verylowfreq/cyd_kusabi/HARDWARE_DESIGN.md

# サイバーデックのハードウェア仕様の検討

最終更新: 2026-10-31

**状態**: 検証済み。**指摘 12 件はすべて決着した**（下の「決定事項」）。
**2026-08-28 にブレッドボード試作機で初火入れ**（下の「初火入れの結果」）。
残る未決は 1 つ:

- **F-11 の付随信号**（カード検出・過電流・電源スイッチ・状態 LED）の割り付け
  — 空きピンは 2 本しかないので、I²C エキスパンダを使う想定

この文書の前半は基板を起こす前の仕様の検討。**実際に起こした基板 v1 と違うところは
下の「基板 v1（hardware/cdk_motherboard）」にまとめた。**

---

## 基板 v1（hardware/cdk_motherboard）

KiCad データは `hardware/cdk_motherboard/`。仕様の検討から変わったところ:

| 項目 | 仕様の検討 | 基板 v1 |
|---|---|---|
| MCU | ESP32-S3-WROOM-1-N16R8 | Freenove ESP32-S3 開発ボード（U1）を載せる |
| 電源 | TPS631000 で 5V / 3.3V | 基板上に電源回路は無い。CN7（GND / 5V / VBAT_RAW / VBAT_EN）に外付けの電源を挿す。SW1 が VBAT_EN を GND に落とす。3.3V は開発ボードの 3V3 |
| RS-232C | SP3232EEN | **XD3232**（U3、DIP-16。3.3V 対応、ドライバ 2・レシーバ 2）。+3V3 給電。回路図のシンボル名は ADM232A のまま（下の「既知の誤り」） |
| USB VBUS | GPIO4 で制御 | GPIO4 は未接続。USB-A（CN1）の VBUS は +5V 直結。ファームは G4 に H を出すだけで害は無い |
| 外部端子 | Grove | Grove（CN2: GPIO1/2、CN3: I2C、CN4: UART2）。フットプリントは JST PH のまま（下の「既知の誤り」） |
| デバッグ | — | CN6（3V3 / RX / TX / EN / BOOT / GND）は開発ボードの UART0。CN8（RX / TX / GND）は G15/G16 の UART1（制御チャネル）。**回路図の信号名 `UART_1_*` は UART0、`UART_DEBUG_*` は UART1** |

電池電圧の分圧は R6 / R7 = 100k / 100k で GPIO5 へ（`CDK_BOARD_BATT_DIV 2` と一致）。

### 基板 v1 の既知の誤り

#### microSD の SPI の信号名

**microSD の SPI 4 本は、回路図・基板データの信号名が実物と違う。**
液晶モジュールの SD のパッド 15〜18 の並びが、フットプリントでは実物と逆順になっている。
ファームウェアのピン指定（`cdk_board.h` と下のピン割り当て表）が正しい。

| GPIO | 回路図・基板データの信号名 | 実物（ファームの指定） |
|---|---|---|
| 39 | SD_MISO | **MOSI** |
| 40 | SD_MOSI | **MISO** |
| 41 | SD_CS | **SCLK** |
| 42 | SD_SCLK | **CS** |

- 基板はそのまま使える。ファームのピン指定を実物に合わせてある（2026-09-12）。
- 信号名が入れ替わっているので、プルアップ抵抗も意図とずれている。
  R1（意図は MISO）は実物の MOSI、R2（意図は SCLK）は CS、R3（意図は CS）は SCLK に付いている。
  **実物の MISO（GPIO40）には外付けのプルアップが無い。** いまのところ読み書きは動いている。
- 次に基板を起こすときは、液晶モジュールのフットプリントの SD パッドの並びを直すこと。
- ctest の `board_pins` はこの文書と `cdk_board.h` を比べるだけで、KiCad データは見ない。

#### 部品の名前が実物と違う（配線は正しい）

- **RS-232C の IC（U3）**: 回路図のシンボル名は `ADM232A` だが、実装しているのは 3.3V 対応の
  **XD3232**。ADM232A は 5V の部品なので、シンボル名どおりに部品を買うと +3V3 給電では定格外になる。
- **外部端子（CN2〜CN4）**: フットプリントは JST PH（`JST_PH_B4B-PH-K`）だが、実装は **Grove**。

---

## MCU

ESP32-S3-WROOM-1-N16R8

- N16 = 16MB flash / **R8 = 8MB octal PSRAM**
- octal PSRAM は GPIO33〜37 を SPIIO4〜7 と SPIDQS に使う。
  GPIO33/34 はモジュールのピンに出ていないので、実際に潰れるのは 35〜37。
- ファーム側は `CONFIG_SPIRAM_MODE_OCT=y`。`sdkconfig.defaults.v1` に入っている（→ F-12）
- **ピン番号は `cyberdeck_firmware/components_port/port_board/include/cdk_board.h`
  にも同じものが入っている。**片方だけ直すと ctest の `board_pins` が落ちる

## ピン割り当て

チップにあるのは GPIO0〜21 と GPIO26〜48 の 45 本。GPIO22〜25 は存在せず、
GPIO26〜32 は内蔵 flash 用でモジュールのピンに出ていない。
**入力専用のピンは無い**（どのピンも出力にできる）。

| GPIO | 用途 | 備考 |
|---|---|---|
| 0 | BOOTボタン専用 | ストラッピング |
| 1 | ADC外部入力0 | ADC1_CH0 |
| 2 | ADC外部入力1 | ADC1_CH1 |
| 3 | 原則未使用、テストパッド | ストラッピング（JTAG 選択）/ ADC1_CH2 |
| 4 | USB Host VBUS Enable | ADC1_CH3。**基板 v1 では未接続**（VBUS は 5V 直結） |
| 5 | **電池電圧センス** | ADC1_CH4 |
| 6 | 空き | ADC1_CH5 / RTC |
| 7 | 空き | ADC1_CH6 / RTC |
| 8 | LCD Backlight PWM | ADC1_CH7 |
| 9 | LCD D/C | |
| 10 | LCD CS | **SPI2 IO_MUX**（FSPICS0） |
| 11 | LCD MOSI | **SPI2 IO_MUX**（FSPID） |
| 12 | LCD SCLK | **SPI2 IO_MUX**（FSPICLK） |
| 13 | LCD MISO | **SPI2 IO_MUX**（FSPIQ）— ファームは未使用 |
| 14 | LCD RESET | |
| 15 | UART1 RX | **デバッグ: 制御チャネル**（`cdk_proto`） |
| 16 | UART1 TX | 同上 |
| 17 | I²C SDA | 信号は 3.3V レベル前提 |
| 18 | I²C SCL | 同上 |
| 19 | USB Host D− | 内蔵 USB PHY |
| 20 | USB Host D+ | 同上 |
| 21 | UART2 RTS | RTC |
| 35–37 | 使用禁止 | octal PSRAM が使用 |
| 38 | UART2 CTS | |
| 39 | SD MOSI | 外部 JTAG と同じピン（JTAG は使わない） |
| 40 | SD MISO | 同上 |
| 41 | SD SCLK | 同上 |
| 42 | SD CS | 同上 |
| 43 | UART0 TX | **デバッグ: ログ + 書き込み**。モジュール既定 TXD0 |
| 44 | UART0 RX | 同上。モジュール既定 RXD0 |
| 45 | 空き | ストラッピング |
| 46 | 空き | ストラッピング |
| 47 | UART2 RX | D-sub / Grove（排他） |
| 48 | UART2 TX | 同上 |

### デバッグ経路

USB-Serial-JTAG が使えない（GPIO19/20 を USB ホストに使うため）ので、
DESIGN.md §3.4 の 2 チャネル構成を UART で組み直す。

| チャネル | UART | ピン | 用途 |
|---|---|---|---|
| CTRL | UART1 | 15 / 16 | `cdk_proto` のバイナリフレーム専用 |
| LOG | UART0 | 43 / 44 | `ESP_LOG` のテキスト + ファーム書き込み |

制御とログが別の物理ポートのまま残るので、DESIGN.md §3.4 が 1 チャネル縮退を
避けた理由（パニック時のバックトレースやブートローダの出力がフレームに
割り込む）はそのまま満たせる。

## 電源

- バッテリー: NiMH x2（公称 2.4V、放電末期 約 2.0V）。**本体では充電しない**
- 5V レーン: TPS631000
- 3.3V レーン: TPS631000

TPS631000 は昇降圧。出力は最大 5.3V。カタログの出力電流は入力電圧の条件つき
（`VIN ≥ 2.7V` で 1.5A、`VIN ≥ 3V` で 2A、ピークスイッチ電流 3A）で、
2 セル NiMH は常に 2.7V を下回る。**5V / 3.3V ともにピークでも 1.5A に
達しない前提**で設計する（→ F-6）。

## 外部端子

| 端子 | 内容 | 前提 |
|---|---|---|
| Grove GPIO | ADC対応GPIO x2 (GPIO1/2), 5V, GND | **信号線は 3.3V レベル** |
| Grove I2C | I2C (GPIO17/18), 5V, GND | **信号線は 3.3V レベル**（5V プルアップのモジュールは不可） |
| Grove UART | UART2 | **D-sub と排他。同時に挿さない** |
| D-sub 9pin UART | UART2 + CTS, RTS | IC: SP3232EEN(UMW)。ドライバ2/レシーバ2 でちょうど合う |

電源ピンは 5V を出すが、**信号線は 3.3V** で扱う。ESP32-S3 の GPIO は
5V トレラントではなく、絶対最大定格は電源電圧 +0.3V。5V で信号を出す
モジュールは繋がない（→ F-8）。

Grove UART と D-sub は同じ UART2 の RX（GPIO47）に繋がるため、両方に機器を
挿すと RX 側で競合する。**シルクに明記すること**（→ F-3）。

---

# 検証結果と決定 (2026-08-28)

ESP-IDF v5.5.5 の一次情報と TI の製品情報に突き合わせた。
**ピンの並びそのものは正確**で、モジュールで使えないピンも正しく除いてある。
指摘はピンの選び方ではなく、**その結果として何が使えなくなるか**に集中していた。

## 決定事項

| # | 指摘 | 決定 |
|---|---|---|
| F-1 | USB ホストが内蔵 USB PHY を占有し、USB-Serial-JTAG が使えなくなる | **UART0 と UART1 をデバッグに使う。**CTRL=UART1(15/16)、LOG+書き込み=UART0(43/44) |
| F-2 | 外部 JTAG (39–42) が SD に、内蔵 USB-JTAG が F-1 で塞がる | **JTAG は使わない。**両方とも捨てる |
| F-3 | Grove UART と D-sub が同じ UART2 で RX が競合 | **同時使用しないよう運用で回避。**シルクとドキュメントに明記 |
| F-4 | EN を操作する手段が無い | **EN ボタンを付ける** |
| F-5 | 電池電圧を測るピンが無い | **GPIO5（ADC1_CH4）で測る** |
| F-6 | TPS631000 の 1.5A は VIN≥2.7V の条件つき | **5V / 3.3V ともピークでも 1.5A に達しない前提**。問題なし |
| F-7 | NiMH の充電回路が未定義 | **本体では充電しない。**電池を抜いて外部充電器で充電する |
| F-8 | Grove の 5V と 3.3V GPIO | **信号線は 3.3V レベル前提。**5V 信号のモジュールは繋がない |
| F-9 | 型番の誤記 `TSP631000` | 修正済（`TPS631000`） |
| F-10 | LCD MISO はファームが使わない | 承知のうえで配線は残す。条件つき空きピンとして扱う |
| F-11 | 付随信号（カード検出・過電流・電源スイッチ・状態 LED）が未割り当て | **あとで決める。**空きピン一覧は下記 |
| F-12 | ファームの PSRAM 設定が試作機と最終ハードで違う | **実装済み。**`cdk.py build --board v1` で切り替わる（DESIGN.md §13 M7） |

## F-11 空きピン一覧

決定を反映したあと、モジュールに出ている 33 本の使えるピンのうち
**28 本が埋まっていて、残りは 5 本**。

### 完全に自由に使える — 2 本

| GPIO | ADC | RTC | 備考 |
|---|---|---|---|
| **6** | ADC1_CH5 | ○ | 制約なし |
| **7** | ADC1_CH6 | ○ | 制約なし |

どちらも **ADC1** なのでアナログ入力に使える（ADC2 は WiFi 使用中に読めないため
実質使えない）。どちらも **RTC GPIO** なので**ディープスリープからの復帰に使える**。

> **ウェイクに使うピンはこの 2 本のどちらかしかない。**
> RTC GPIO は GPIO0〜21 に限られ、そのうち空いているのは 6 と 7 だけ。
> 電源スイッチやウェイクボタンを付けるなら、**先にここを予約すること。**
> I²C エキスパンダの先に付けた信号ではチップを起こせない。

### 条件つきで使える — 5 本

| GPIO | 条件 | ADC / RTC |
|---|---|---|
| **3** | ストラッピング（JTAG 選択）。ただし **`STRAP_JTAG_SEL` eFuse を焼かない限り効かない**。JTAG を使わないので焼く理由がない。起動時の内部プルが無いので外部で決めること | ADC1_CH2 / RTC |
| **13** | LCD MISO。ファームは画面を読み戻さないので未接続にできる（DESIGN.md §12）。将来リードバック対応パネルに替えるなら残す | ADC2 / RTC |
| **21** | UART2 RTS。D-sub のフロー制御を使わないなら空く | — / RTC |
| **38** | UART2 CTS。同上 | — / — |
| **45** | ストラッピング（VDD_SPI 電圧選択）。**起動時に LOW でなければならない**。起動時に HIGH へ引かれる接続は不可 | — / — |
| **46** | ストラッピング（起動モード）。**起動時に LOW でなければならない**。同上 | — / — |

GPIO45 / 46 は「起動時のレベルが決まっていて、起動後に出力として使う」用途向き。
状態 LED のように起動時に不定でも困らないものなら載る。逆に、外部から
引っ張られる可能性がある入力には使わないこと。

> **未確認**: GPIO45 / 46 の内部プルダウンが reset 時に有効かどうかまでは
> 確認していない。何かを繋ぐなら**外部プルダウンを入れる**のが安全。

### 付随信号の割り付け案

F-11 で挙がっていたのは 5 つ。空きは 2 本なので、そのままでは足りない。

| 信号 | 案 |
|---|---|
| 電源スイッチ / ウェイク | **GPIO6 か 7**（RTC が要るので他に選択肢が無い） |
| SD カード検出 | I²C エキスパンダ、または**省略**（マウントを試して失敗で判定できる） |
| USB 過電流 (FAULT) | I²C エキスパンダ。または**ロードスイッチの FAULT を自分の EN に戻して**ハードだけで遮断し、MCU は関与しない |
| USB VBUS 検出 | I²C エキスパンダ |
| 状態 LED | I²C エキスパンダ、または GPIO45 / 46 |

**I²C エキスパンダ（PCA9555 / PCF8574 など）を 1 個載せるのが素直。**
I²C は GPIO17/18 にすでに出ているので MCU のピンは 1 本も増えない。
遅い信号（LED・検出・スイッチの状態）はこれで足りる。
試作機の CoreS3 も同じことを AW9523 でやっているので、扱いの勘所は分かっている。

**エキスパンダで代替できないのはウェイクだけ**。そこだけ GPIO6/7 を使う。

## 確認できた点

- **GPIO35–37 使用禁止。** R8 は octal PSRAM なので GPIO33–37 が
  SPIIO4–7 / SPIDQS に使われる。GPIO33/34 はモジュールのピンに出ていないので、
  表に無いのが正しい。
- **ストラッピングピンの扱い。** ESP32-S3 のストラッピングは
  GPIO0 / 3 / 45 / 46 のちょうど 4 本で、指定と一致する。
- **USB D− = GPIO19 / D+ = GPIO20。** 内蔵 PHY の割り当てとして正しい。
- **ADC を GPIO1/2 に取った判断。** ADC1 は GPIO1–10、ADC2 は GPIO11–20。
  **ADC2 は WiFi 使用中に読めない**ので、外部入力を ADC1 に置いたのは正しい。
  電池センスの GPIO5 も ADC1。
- **UART0 が GPIO43/44。** WROOM-1 の既定 TXD0/RXD0 と一致していて、
  書き込み時に迷わない。
- **LCD が SPI2 の IO_MUX ピンに載っている。** CS=10 / MOSI=11 / SCLK=12 /
  MISO=13 は FSPI の IO_MUX そのもの。GPIO マトリクス経由を避けられるので
  SPI を 80MHz まで上げられる（いまは 40MHz で動かしている）。480x320 の全画面が 300KB なのでここが効く。
- **LCD と SD が別の SPI ホスト。** 試作機 CoreS3 の「LCD と SD が SPI3 を
  共有し、さらに DC と MISO が同じ G35」という問題
  （`port_spibus` でピンの向きを切り替えて凌いでいる）が、この基板では
  最初から存在しない。DESIGN.md §12 の 7 番が構造的に消える。
- **SP3232 の選定。** ドライバ 2・レシーバ 2 で TX / RX / RTS / CTS に
  ちょうど合う。過不足がない。
- **TPS631000 で 5V が作れる。** 出力は最大 5.3V なので範囲内。
- **入力専用ピンが無い。** ESP32-S3 はどの GPIO も出力にできるので、
  空きピンの用途を選ぶときに向きの制約を考えなくてよい。

## 液晶 — ILI9488 (決定)

**SPI 接続では 16bit を受け付けない。** 18bit (RGB666) の 3 バイトしか
通らないので、キャンバスの RGB565 を転送の直前に広げる。

| | |
|---|---|
| 転送量 | 480x320 の全画面で **450KB**（RGB565 なら 300KB。1.5 倍） |
| ドライバ | `atanisoft/esp_lcd_ili9488` 1.1.x（変換とレジスタ列） |
| 素の向き | 320x480（縦）。横長で使うので `swap_xy` + `mirror` |

**帯単位で送るので全画面 450KB を一度に持つ必要はない。** 16 行ずつなら
480x16x3 = 23KB の変換バッファ 1 つで足り、起動時に 1 回だけ確保する
（DESIGN.md §14）。

> **ドライバの `draw_bitmap` に境界検査が無い。** `buffer_size`（画素数）を
> 超える画素数を渡すとヒープを壊す。帯の行数と必ず一致させること。
> 1.0.x は転送のたびに malloc し、失敗すると**無限ループ**するので使わない。

## まだ決まっていないこと

### F-11 の付随信号

上記の案のとおり。**ウェイクに使う 1 本（GPIO6 か 7）だけは先に予約する**のが
よい。あとから「RTC GPIO が無い」と気づくと、空きが無いので詰む。

## 照合先と、確認していないこと

ピン・ADC・JTAG・ストラッピング・IO_MUX は手元の ESP-IDF v5.5.5 のソースと
資料で確認した。

- `components/soc/esp32s3/include/soc/adc_channel.h` — ADC1 = GPIO1–10 / ADC2 = GPIO11–20
- `components/soc/esp32s3/include/soc/usb_pins.h` — D− = GPIO19 / D+ = GPIO20
- `components/soc/esp32s3/include/soc/spi_pins.h` — SPI2 IO_MUX と MSPI（octal）の割り当て
- `components/soc/esp32s3/include/soc/soc_caps.h` — 入力専用ピン無し / UART 3 本
- `docs/en/api-reference/peripherals/gpio/esp32s3.inc` — ストラッピング / ADC / RTC / GPIO33–37 / USB-JTAG
- `docs/en/api-guides/jtag-debugging/esp32s3.inc` — 外部 JTAG = GPIO39–42、選択ピン = GPIO3

TPS631000 の電圧・電流は TI の製品ページ。

**確認していないこと:**

- GPIO45 / 46 の内部プルダウンが reset 時に有効かどうか
- JTAG の 4 信号が GPIO39–42 のどれに対応するか（JTAG を使わないので影響なし）
- 電源の最終判断には実際の負荷実測が要る（1.5A に達しない前提は未検証）
- キーボードの型番が未定なので、消費電力の見積もりは概算
- **ILI9488 のドライバは実機で一度も動かしていない。**基板が無いので、
  初期化列・向き（swap_xy / mirror）・SPI クロックは最初の火入れで調整が要る
  → 2026-08-28 の初火入れで動いた（下記）

---

# 初火入れの結果 (2026-08-28)

本番の回路構成をブレッドボードで組んだ試作機にファームウェアを載せた。
書き込みは CH343 (COM76) 経由の UART0。

## 動いたもの

| | 結果 |
|---|---|
| チップ | ESP32-S3 (QFN56) rev v0.2 / 16MB flash (quad) / **PSRAM 8MB** |
| **octal PSRAM** | `Found 8MB PSRAM device` / 80MHz。基板切り分けの `SPIRAM_MODE_OCT` が効いた |
| 自動リセット | esptool の `default_reset` がそのまま通る（**手で BOOT を押す必要が無い**） |
| コンソール | UART0 (G43/G44)。ログも書き込みも同じ線 |
| **ILI9488** | 初期化・転送とも成功。**480x320 → 端末 80桁 x 26行** |
| フォント / 日本語 | 東雲 12px、かな漢字カタカナ半角カナ、罫線、色、属性すべて描画 |
| WiFi | 接続して IP 取得 |
| SKK 辞書 | フラッシュに 6.3MB を焼いて 送りあり15,996 / 送りなし159,795 を認識 |
| 空きヒープ | internal 110KB / PSRAM 7.8MB |

DESIGN.md §0 で決めた **80桁 x 26行がそのまま出た**。

## 直したもの

### SPI ホストの番号を 1 つ間違えていた

`spi_host_device_t` は `SPI1_HOST=0 / SPI2_HOST=1 / SPI3_HOST=2` で、
**周辺機能の名前の数字と 1 つずれる**。「SPI2 だから 2」と書いていた。

- SD: `3` は範囲外で `spi_bus_initialize(): invalid host_id`
- **LCD: `2` は SPI3 に載る。初期化も表示も通ってしまう。**
  IO_MUX 直結を失って GPIO マトリクス経由になり、80MHz が使えない

SD は起動時に落ちたので気づいた。**LCD のほうは正常に見えるので気づけない。**
この文書が「LCD を IO_MUX ピンに置いた」ことを強みとして挙げていたのに、
ファームがその経路を使っていなかった。列挙子の名前で書くように直した。

**この表の主張をビルドで守るようにした。** 上のピン表の「SPI2 IO_MUX」は
`soc/spi_pins.h` の `SPI2_IOMUX_PIN_NUM_*` そのものなので、
`port_display.c` で静的アサートにしてある。ホストを別の番号にしても、
LCD の 4 本を IO_MUX 以外へ動かしても、そこでビルドが止まる。

つまり**このピン表の「SPI2 IO_MUX」という記述は、もう飾りではない**。
ここを書き換えるなら `cdk_board.h` も一緒に直さないとビルドが通らない。
（ピン**番号**の食い違いは別途 `tools/check_board_pins.py` が見ている。
番号の一致とホストの正しさは別の性質なので、仕組みも 2 つある。）

### 画面が 180 度回っていた

`swap_xy(true)` + `mirror(true, false)` で上下逆に出た。初期化も転送も
正しく、向きだけが違う。`mirror(false, true)` に直した。
**これは論理では決まらない**（パネルの実装と取り付け向き次第）ので、
見て合わせるしかない。

### パネルの上端（見えない行があるか）

**基板を起こすときに効く話。** 以前の 3.5 インチ ILI9488 モジュールは
一番上の 1 画素行が見えず、キャンバスの行 y をパネルの行 y+1 に出して
逃がしていた（`CDK_BOARD_LCD_Y_OFFSET` = 1）。

**2026-10-30 に 0 へ戻した。** いまのパネルでは 1 下げると画面全体が
1 画素下にずれて見えた（人間の目視）。以下は 1 以上にするときの約束:

- ずらした分、キャンバス下端の 1 行はパネルの外に出るので送らない。
  欠けるのはステータス帯（DESIGN.md §0）の最下段 1 行だけ。
- **キャンバスは 480x320 のまま**。ずれはパネルの性質であって描く内容の
  性質ではないし、`shot --verify` がキャンバスを見ている以上、
  ここを変えるとホストとの一致検証まで巻き添えになる。

**別のパネルに変えたらこの値を測り直すこと。** 見えない行数はモジュール
（ガラスの位置・ベゼル・コントローラのオフセット）で決まるので、
0 かもしれないし 2 かもしれない。

確認の仕方は A/B しかない。`shot --verify` はキャンバスを比べているので、
**オフセットが 0 でも 1 でも 2 でも必ず通る**。オフセットを変えて 2 回焼き、
同じ画面を撮って相互相関でずれ量を測った（文字行のピッチ 12 画素を
物差しにすると、写真 1 枚あたり 2.833 画像画素 = 1 パネル画素）。

### 地の文の白

`default_fg` を `palette[7]`（xterm 既定 = 0xE5E5E5、実は 90% の灰色）から
`palette[15]`（純白）に変えた。このパネルでは灰色が目立って暗く見える。

**ファーム側の上限はここ。** ドライバの RGB565→RGB666 変換は 0xFFFF を
63/63/63 に写しており（変換で落ちてはいない）、バックライトも起動時から
duty 100%。これ以上明るくするならハードウェア側（バックライト電流、
パネルのコントラスト）になる。

### 制御チャネルを UART1 に載せた

F-1 の結論を実装した。`cdk_proto` のフレームを UART1 (TX=G16 / RX=G15) に
流す。速度は 921600（スクリーンショットが 300KB あるので、ログと同じ
115200 だと 1 枚 26 秒かかる）。

## 配線を直して動いたもの

### microSD

最初は `sdmmc_card_init failed (0x107)` でタイムアウトしていたが、
配線を直したら認識した。`SL16G 14.8G 20000 kHz`、読み書きとも成功。
CoreS3 で使っていたカードをそのまま挿しており、`/sdcard/skk/user.dic` の
学習 3 件も読めている。

### 制御チャネル (UART1 → FT232 COM75)

`ping` が通り、**`shot --verify` が 480x320 = 307,200 バイトで
ホストの基準画像と完全一致**した。`selftest`（boot + ping + vt + shot）も
そのまま完走する。

これで**本番の解像度で、実機の画面とホストが同じ絵を描いていることを
バイト単位で確かめられる**ようになった。M0 から積んできた検証の仕組みが
最終ハードでもそのまま使える。

## 動作確認できたこと

| 機能 | 結果 |
|---|---|
| `selftest` | boot + ping + vt + shot が完走。**480x320 完全一致** |
| SKK | `Ctrl-J` → `Nihon` → Space → **▼日本**（画素で桁も確認） |
| 辞書 | フラッシュから 17.5 万語。個人辞書は SD から 3 件 |
| エディタ | `edit v1.txt` で日本語を書いて `Ctrl-S` → SD に 53 バイト保存 |
| SD 読み書き | `cat v1.txt` で書いた内容が読める |
| WiFi | 接続して IP 取得 |

空きヒープ: internal 108KB / PSRAM 7.77MB。

## ポートの役割（基板で違う）

3 つの役割があり、どれが同じ線に乗っているかが基板で変わる。

| 役割 | 中身 | CoreS3 | v1 |
|---|---|---|---|
| PROG | esptool の書き込み。**EN と GPIO0 を叩ける線** | USB-Serial-JTAG (COM22) | CH343 (COM76) |
| CTRL | `cdk_proto` のバイナリフレーム | 同上 (COM22) | FT232 → UART1 (COM75) |
| LOG | `ESP_LOG` のテキスト | FT232 (COM75) | CH343 (COM76) |

**リセットの掛け方も違う。** USB-Serial-JTAG と普通の USB シリアルでは
DTR/RTS の使い方が別で、取り違えると症状が「起動ログが出ない」だけになり、
ポートの問題だと気づきにくい。`cdk.py` は `.cdk_board` を見て
自動で使い分ける（`--ctrl` / `--log` / `--prog` で上書きできる）。

なお、このブレッドボードでは **GPIO19/20 が PC に繋がっている**らしく、
USB-Serial-JTAG が COM77 として見えている（本番は USB ホストに使うので
消える経路）。ファームは v1 では使わない。

### 中間調が沈む（ガンマ補正）

「少し暗いだけの色がまったく読めない」という指摘。原因は 2 つ重なっている。

- xterm の**通常色は 0xCD = 80%** しかない。バナーの `ESP32-S3 terminal` は
  `ESC[32m` の緑 (0x00CD00) で、1 チャネルだけなのでいちばん条件が悪い
- このパネル自体が中間調を沈ませる

`cdk_screen_set_gamma()` で 0 と最大値を固定したまま中間だけ持ち上げる。
基板の既定は `CDK_BOARD_LCD_GAMMA_X10`（v1 = 22 → ガンマ 2.2、CoreS3 = 10 = 無補正）。

**パレットではなくセルの色に最後に掛ける。** dim（半分にする）や反転を
済ませてから補正しないと「補正後の値の半分」になって dim が沈みすぎる。

**中身は整数演算だけ。** `powf` だとホストと実機で最終ビットが揃う保証が無く、
`shot --verify` の完全一致がたまに崩れる。整数なら同じ C コードが必ず同じ値を出す。

#### 値は目で決めるしかない

**カメラでは測れないことを 3 通りで確かめた。**

| やったこと | なぜ駄目だったか |
|---|---|
| 横並びのグレーランプを 1 枚撮る | 視野角で場所ごとに明るさが違い、**単調なランプが単調に写らない**（v=78 が v=177 より明るい） |
| 画面全体を 1 色で塗って階調ごとに撮る | **写真ごとに露出が変わる**。黒と白の比が 1.38:1 まで潰れた |
| 同じ写真の中で緑と白の比を取る | 白が 255 で**飽和**して比が意味を持たない |

パネルの向き (#35) と同じ性質で、人が見て決めるしかない。
そのかわり**焼き直さずに追い込める**ようにした。

```
set gamma 26      ← その場で画面が変わる。NVS に残る
```

10（無補正）〜40 の範囲。範囲外や壊れた値は基板の既定値に落として、
設定ミスで画面が読めなくならないようにしてある。

#### 実機のガンマは基準画像にも渡している

`SHOT_INFO` の予約バイトに載せ、`cdk.py` が `cdk_render --gamma=N` へ渡す。
これが無いと `set gamma` で追い込んだ瞬間に `shot --verify` が落ちて、
**しかも落ちる理由がガンマ違いなので「実機が壊れた」ように見える**。
実機で 2.2 / 2.6 / 3.0 と変えても完全一致のままであることを確認済み。
