verylowfreq/cyd_kusabi/ABOUT.md

## 概要

ESP32-S3でサイバーデックを作るプロジェクト

## 利用シチュエーション

- 簡易なSSH端末に
- SSH接続先のホストで実行されるAIエージェントの指示端末
- マイコンであることを活かして、ローレベルな通信やピン操作が可能な端末
- 日本語ワープロ

## 機能

- WiFiでインターネット接続
- USBキーボードから入力を受け付ける
- ディスプレイにコンソールを表示
- SSH端末
- SKK日本語入力
- コマンドラインの簡易なシェル風環境
- コマンドでGPIO、I2C、ADC、UARTなどが操作できる
- microSDをファイルシステムとして利用

## ハードウェア

- ESP32-S3 + PSRAM
- USBキーボード
- microSD
- SPI接続の液晶ディスプレイ。320x240もしくは480x320

## 開発環境

ESP-IDF v5.5.5 ( C:\DATA-0\Espressif\esp-idf-v5.5.5 )

## ターミナル機能

目標はCodexやClaude CodeのCLIが動くこと。下記で省略可能なものは削って良い。

CR、LF、BS、TAB
カーソル移動
画面消去
行消去
SGR色
カーソル位置設定
保存・復元
スクロール
UTF-8。ただし実際に扱うのはShiftJISの範囲でも良い。
全角幅

## SKK日本語入力

辞書はとりあえずSKK-JISYO.Lを利用する。あとで差し替えられるように。
実機では辞書ファイルを直接扱わず、パソコン上でいったん変換を挟んでも良い。

## 開発進行

まずはM5Stack CoreS3で試作をする。この時点ではUSBキーボード対応は不要。AIエージェントが自律的にコーディング、実行、デバッグできるようにする。ディスプレイ表示も検証できるように、ディスプレイの表示画像をファイルに書き出してパソコンへ転送する仕組みを入れる。
ESP32-S3実機ではなくパソコン上で検証できるところは積極的にパソコン上で検証する。

## テスト用WiFiネットワーク

TEST_WIFI_SSID
TEST_WIFI_PSK

## テスト用SSHサーバー

TEST_SSHSERVER_HOST
TEST_SSHSERVER_USERNAME
TEST_SSHSERVER_PASSWORD

## ホストのコンパイラ・インタプリタ

Rust
clang ( C:\Program Files\LLVM\bin )
Visual Studio 2022 ( C:\Program Files\Microsoft Visual Studio\2022\Community )
Python

## 決めてほしいこと

- 機能の開発順序
- 機能ごとの詳細
- 実装困難・不能な箇所についての指摘と代替案

→ 回答は `cyberdeck_firmware/DESIGN.md` に記載。以降、実装仕様の正はそちら。

---

## 決定事項 (2026-08-27)

| 項目 | 決定 |
|---|---|
| 最終ハードの液晶 | 480x320 |
| 端末のセル寸法 | 半角 6x12 / 全角 12x12 → **80桁 x 26行** |
| フォント | 東雲フォント 12px (BDF, Public Domain)。フラッシュに焼き込み、SD 不要 |
| 試作機の入力手段 | PC からシリアル経由でキーイベントを注入（`tools/cdk.py type` / `key`） |
| 開発優先順位 | M0 基盤 → M1 ターミナル → **M2 WiFi+SSH** → M3 シェル/周辺 → M4 SD → M5 SKK → M6 エディタ |
| 日本語ワープロの範囲 | microSD 上のプレーンテキストを編集する簡易エディタ（SKK 併用）。装飾・PDF 出力は対象外 |
| 実装言語 | C11 + ESP-IDF v5.5.5（ホスト側ツールは Python） |
| GUI ライブラリ | 使わない（テキストグリッドを自前描画） |

### 実機の確認結果

- COM22 に ESP32-S3 (rev v0.1) / 16MB flash / USB-Serial-JTAG モードを検出。M5Stack CoreS3 とみなす。
- COM74 に CH340 USB シリアル変換器。ログ専用チャネルが必要になったときの予備。
- ESP-IDF v5.5.5 と esp32s3 ツールチェーンは導入済み。
- 公式 BSP `espressif/m5stack_core_s3` 2.0.0 がコンポーネントレジストリに存在。
  CoreS3 は LCD バックライトと周辺電源が AXP2101 / AW9523 経由なので、
  ピンマップと電源投入順序は BSP から取る。

## 追加で決めた仕様（詳細は DESIGN.md）

### 画面

480x320 で 80桁 x 26行（312px）、余り 8px を最下段のステータス帯にする。
試作機 CoreS3 (320x240) は同じフォントで 53桁 x 20行。桁数は実行時にパネル寸法から算出する。

### アーキテクチャ

ESP-IDF に依存しない純 C のコア（VT パーサ、UTF-8/文字幅、フォント描画、SKK エンジン、
シェル、エディタ）と、薄いポート層（表示、入力、ネットワーク、ストレージ、周辺）に分ける。
コアはホスト PC 上で clang/MSVC + ctest で単体テストする。

### 開発ループ

- `idf.py monitor` は終了しないのでエージェントからは使わない。
  タイムアウトとセンチネル (`#CDK-READY`) 付きのシリアルリーダを `tools/cdk.py` に実装する。
- スクリーンショットは液晶からの読み戻しではなく、PSRAM 上のキャンバスをダンプして PNG 化する。
  同じキャンバスをホスト側テストでもレンダリングして画像 diff できる。
- チャネルは 2 本に分ける。制御・バイナリ転送は USB-Serial-JTAG (**COM22**)、
  ログは UART1 → CoreS3 の PORT.C (G17/G18) → FT232 (**COM75**)。配線済み。
  1 本に多重化するとパニック出力や ROM ブートローダのチャタリングでフレームが壊れるため。
  FT232 を繋げないとき用に 1 チャネル縮退モードも用意する。
- SSH ライブラリは **wolfSSH + wolfSSL**（GPLv3 は許容と判断）。導入コストが最小。
  クライアント PTY が期待通り動かなければ libssh2 (BSD-3) に切り替える。
- 26 行は仕様として受け入れる。パネル変更はしない。

## セキュリティ上の注意

テスト用の WiFi PSK と SSH パスワードは、最初この資料に平文で書いていた。
2026-08-27 に gitignore した `.env` へ移し（上の「テスト用」の節は変数名だけ）、
2026-09-01 に `git filter-repo` で履歴からも消した。
ファームウェアのソースにも sdkconfig にも書かず、NVS から読む
（`.env` から作る `secrets.h` は初回の種。DESIGN.md §8.1）。

## 未決の宿題

以下は当面ブロッカーではないが、いずれ決める必要がある。

- **`skkdict` パーティション (4MB) を確保するか**: SD が本命なので、SD 無し運用を捨てるなら不要。M5 までに判断。
- **最終ハードの基板構成**: パネルの型番（ILI9488 / ST7796 など）、SD を SDMMC で別バスにするか、
  USB キーボードへの 5V 給電回路、バッテリと PMIC。
- **キー配列の既定値**: US / JIS 両対応で実装するが、既定をどちらにするか。
- **SSH の鍵認証**: パスワード認証だけで足りるか、SD 上の秘密鍵にも対応するか。
- **筐体**: 実装が固まってから。
