verylowfreq/cyd_kusabi/DEV_STATS.md

# AIの自律的な組み込み開発における各種統計

対象: ESP32-S3 サイバーデック (M0 基盤 → M1 ターミナル → M2 SSH → M3 シェル → M4 ストレージ → M5 日本語入力 → M6 エディタ → M7 最終ハード → M8 wasm)
最終更新: 2026-09-16 / 到達点: **M8 完了**（WebAssembly ユーザーアプリ / C と Rust の SDK）
＋ `wget`（HTTP / HTTPS で 1 本取る。実機 v1 で確認、https の 1 周最長 200ms → 62ms に詰めた）
＋ シリアル端末 `uart`（UART2・RTS/CTS の切り替え。M3 で見送った 2 点を決着。
  実機の折り返しで echo とフロー制御まで確認）
＋ wasm アプリからの TLS / HTTPS（ABI は増やさず `sock_open` の型で。同時 2 本）
＋ ターミナルのスクロールバック（200 行）
＋ M7 完了（USB キーボード / ステータス帯 / 公開鍵認証 / 再接続）
＋ ハードウェア仕様のレビュー ＋ 最終ハードの初火入れとパネル調整

機械的に数える項目はフックの**累計**（`.dev-stats.json`）で、
**この節目だけの数ではない。** 前回（2026-08-29 / ビルド 99・書き込み 34・
テスト 39）との差には、M8 の作業だけでなく、その間に人間が回した分も入っている。
M8 単体の内訳は下の「M8」の節にある（実機書き込み 4・実機ビルド 8）。

- AIが行ったビルド回数: **305**（実機 196 / ホスト 109）
- 実機への書き込み回数: **116**
- 自動テスト回数: **158**（ctest 実行回数。1 回あたり **27 スイート / 39,186 チェック**。
  うち `test_text` 29,034・`test_font` 7,387 が総当たりのループで、残りは約 2,800）
- 成功／失敗回数: テスト **107 成功 / 11 失敗** ・ ビルド **136 成功 / 19 失敗**
- AIが修正した不具合数: **64**（うち 53 は AI が自力で発見、3 は人間が指摘、8 はレビュー指摘）
- AIが指摘したハードウェア設計上の問題: **12**（うち重大 4。ファームの不具合とは別枠）
- 人間が介入した回数: **53**（うち不具合の指摘 4、設定ミスの訂正 2、判断の提供 22、新規指示 23、検証の代行 2）
- 人間が却下した提案数: **0**
- 1機能が通るまでの反復回数: M0 = 実機書き込み 3 / M1 = 実機書き込み 4・ホストテスト 12 / M2 = 実機書き込み 5・ビルド 8 / M3 = 実機書き込み 4・ホストテスト 6 / M4 = 実機書き込み 9・実機ビルド 12 / M5 = 実機書き込み 3・ホストビルド 15 / M6 = 実機書き込み 3・ホストビルド 4 / **M8 = 実機書き込み 4・実機ビルド 8**
- 自律ループが停止した理由の列挙と回数: **9**（内訳は下記。**M4〜M8 では 0 回**。`wget` で 3 回）
- カメラの撮影回数: **23**（M5 / M6 / M8 / TLS では 0 回。v1 のパネル調整で 18 回）
- 画像で初めて見つかった不具合数: **2**（ほかに、原因の手がかりが画面から得られたもの 1）

---

## 数え方

機械的に数えられる項目は `dev-stats-hook.py`（Claude Code の PostToolUse フック）が
自動計上し、生カウンタは `.dev-stats.json` に貯まる。人間が数えるとずれるし、
AI が後から会話ログを読み返して再構成しても概算にしかならないため。

判断が要る項目（不具合数・人間の介入回数など）はフックでは数えられないので、
このファイルに手で書く。

> **フック導入は 2026-08-27 11:20。それ以前の数字はセッションログからの再構成で、
> ビルド回数とテスト回数は ±2 程度の誤差がある。** 書き込み回数・カメラ撮影回数・
> 不具合数・人間の介入回数は個別に列挙できるので正確。以降は自動計上。

補足 1: `ctest` の出力を `grep` や `tail` で絞ると、フックから合否判定が見えず
テストの成功／失敗が計上されない。判定を数えたい実行では出力を絞らないこと。

補足 2: 2026-08-27 12:00 に分類の取りこぼしを直した。それ以前は
`build; flash` のような複合コマンドを 1 つしか数えていなかった。

---

## AIが修正した不具合（44件）

| # | 不具合 | 発見方法 |
|---|---|---|
| 1 | PSRAM を octal で初期化 → 起動時 abort（CoreS3 は quad） | 起動ログ |
| 2 | `usb_serial_jtag_write_bytes` が TX リング超えで 0 を返し続ける → スクショ 0 バイト | 実機ログ |
| 3 | フォントのビット詰めが「バイトの MSB が左端」でなく右 2 列が消える | ホストテスト |
| 4 | カーソル移動先の行がダーティにならず、カーソルが描かれない | ホストテスト |
| 5 | `cdk_keys` が Enter / BS / Tab で Alt 修飾を落とす（Alt+BS が効かない） | レビュー指摘 |
| 6 | JIS X 0208 の全角が Latin-1 の半角を上書き（`° ± £` がげたになる） | ホストテスト |
| 7 | **起動バナーの枠線の桁数が中身と合っていない** | **人間が画面を見て指摘** |
| 8 | `cdk.py build` の `cmd.exe` 引用符が壊れて起動しない | コマンド実行 |
| 9 | `cdk.py type` が `\033` を解釈しない | 実機の画面 |
| 10 | libssh2 で `HAVE_POLL` を定義（lwIP に `poll.h` が無い） | コンパイルエラー |
| 11 | libssh2 の `agent_win.c` を削って `#include` が壊れた（自分のミス） | コンパイルエラー |
| 12 | libssh2 がリンクされていない（`probe` を呼んでいなかった） | バイナリサイズが変わらない |
| 13 | 生成した C ソースのエスケープが潰れた（`\033` が ESC 実体に） | 書き込み前に自分で確認 |
| 14 | 同上。1 行だけ f-string にし忘れ `{NL}` が literal で残った | 書き込み前に自分で確認 |
| 15 | 統計フックが複合コマンド（build+flash）の最初の分類しか数えない | カウンタが実感と合わない |
| 16 | `cdk_shell_split` が区切り文字を終端で潰し、2 語目以降を落とす | ホストテスト（SegFault） |
| 17 | Alt 修飾が UTF-8 の複数バイトをまたぐと消える | ホストテスト（往復） |
| 18 | `cdk_keys` の新ファイルを IDF 側 CMakeLists に足し忘れ | 実機のリンクエラー |
| 19 | `gpio mode out` の直後に `gpio get` が 0 を返す（入力バッファが切れる） | 実機の画面 |
| 20 | シェル終了後に送信済みの行が残る | ホストテスト |
| 21 | **プロンプトの表示幅計算が SGR を可視文字として数え、カーソルが 7 桁ずれる** | **画像（画素の反転位置を計測）** |
| 22 | **FATFS の長いファイル名が無効で `known_hosts` を開けない**（libssh2 からは `rc=-16` としか見えない） | **実機の画面**（`ls` に `LICENC~1.BRO` という 8.3 短縮名が出ていた） |
| 23 | ECDSA の鍵種別を 1 つのビットに丸め、nistp384/521 を `nistp256` と偽って記録する | 実機で TOFU の書き出し内容を確認中に発見 |
| 24 | ヒアドキュメント経由で C ソースの `\r\n` が実改行に潰れた（3 度目。正規表現での修復を試みて悪化させた） | 書き込み前に自分で確認 |
| 25 | ローマ字変換で `"nn"` を ん と決め打ち、`konna` が「こんあ」になる | ホストテスト |
| 26 | **`selftest` が M2 から壊れていた**（起動画面に WiFi の IP と SD のカード名が出るようになり、基準画像と一致しなくなっていた） | M5 で久しぶりに実行した |
| 27 | 送りの途中で BS すると `▽おく*` という、母音を打つまで抜けられない状態に落ちる | ホストテスト |
| 28 | 同上（4 度目）。`cdk_render.c` の `\n` `\0` が潰れた | コンパイルエラー |
| 29 | **エディタのステータス行が画面幅を超えると画面全体がスクロールし、本文が消える** | ホストテスト（吐いたエスケープ列を端末に流してセルを見る） |
| 30 | エディタから戻ってもかな入力が続き、シェルの `ls` が「ｌｓ」になって何も打てない | 実機の画面 |
| 31 | 同上（5 度目）。今度は Python の**検索文字列側**で `\n` が潰れ、置換が当たらなかった | assert が落ちた |
| 32 | **折り返した行がちょうど右端まで埋まっているとカーソルが動かない**（実機では固まって見える） | ホストテスト（1 つの論理行が画面より深く折り返す場合を足した） |
| 33 | ファイルを arena へ直接読んだあと、同じ番地を src と dst にして `memcpy` していた | レビュー指摘 |
| 34 | **SPI ホスト番号を 1 つ間違え、LCD が IO_MUX 直結を失っていた**（SD だけ起動時に落ちて発覚。LCD は正常に見える） | 実機の起動ログ → 再発は `_Static_assert` で止まる |
| 35 | v1 の画面が 180 度回っていた（初期化も転送も正しく、向きだけ） | 実機のカメラ写真 |
| 36 | **`ctest --test-dir build-host` は建て直さない。** 古いバイナリのまま「18/18 通った」と出る | `default_fg` を変えたのに ctest が通り、そのあと selftest だけが落ちた |
| 37 | 同上（**6 度目**）。ヒアドキュメント経由で `\n` が実改行に潰れ、Python の文字列リテラルが壊れた | `cat -A` で書いた直後に確認 |
| 38 | 起動時に `cdk_cfg_init()` を呼んでおらず、**`set gamma` で書いた値が再起動で消えたように見える**（NVS を開くのが WiFi 接続時だけだった） | 実機で `set` すると値は残っているのに画面が変わらない |
| 39 | 立ち上げ用の詳細ログの枠を、**キーを離したときの全ゼロレポートも消費**していた。目当ての打鍵が枠を使い切ったあとに来て、ログに残らなかった | 打鍵を頼んだのにログに出ず、画面写真で確認する羽目になった |
| 40 | **公開鍵認証を足したらメインタスクのスタックが溢れて再起動**（8192 では足りない。libssh2 が PEM を読んで EC 署名する分） | 実機で `ssh` を叩いたら落ちた |
| 41 | `libssh2_userauth_publickey_fromfile_ex` に公開鍵 NULL を渡すと **ECDSA が `rc=-16` で落ちる**（mbedTLS の導出は RSA 専用）。「鍵が未登録」と区別がつかない | 実機のログ |
| 42 | **`set ssh.pass ""` で消したパスワードが `secrets.h` から書き戻されて復活する**（空 = 未設定と見なして毎回種を撒いていた）。認証情報を消す手段が無かった | **人間が指摘** |
| 43 | 接続済みで `wifi connect` を叩くと**必ず 20 秒待って「失敗 ESP_ERR_TIMEOUT」と赤く出る**（接続は生きたまま）。`esp_wifi_connect()` は接続中に呼んでもイベントを上げない | **人間が指摘**（紛らわしい） |
| 44 | **かな入力から `l` で抜けられない。** 打ちかけがあると `l` が文字扱いになり、その `l` がまた打ちかけになって次の `l` が `ll` = っ を出す。押すほど抜けられない | **取扱説明書を書きながら実機で確認して発覚** |
| 45 | 生成した C の `\033` が **ESC の実体に潰れた**（#13 / #14 と同じ再発）。`main.c` の 4 か所が壊れた | コンパイルエラー |
| 46 | wasm3 のリンクで、**ゲストが使っていないインポートが `function lookup failed` になる**。表を全部リンクすると必ず落ちる | ホストのスパイク |
| 47 | 境界検査の対漏れを見る検査が**空振りで通っていた**。区切りに使った置き換え文字が `@` を含み、関数の本体が最初の `;` で切れて「0 個 対 0 個」で一致していた | **わざと 1 個消して落ちるか試した** |
| 48 | コマンド表を足すとき `tables[]` にだけ足して `counts[]` に足さないと**配列の外を読む** | 書きながら気づき `_Static_assert` を入れた |
| 49 | **32KB のタスクスタックが内部 DRAM から取れない。** 空き 77,959 に対し最大ブロックが 31,744 しかなく `wasm run` が落ちた。しかも hello.wasm ですら 42KB 使うので、取れていても踏み抜いていた | **実機**（画面のエラー → `free` で最大ブロックを見て判明） |
| 50 | **`con_write` が溢れたぶんを黙って捨てていた。** リング 4KB に対しメインループが 1 周で汲むのは 2KB で、出し続けるアプリの出力が画面から消えてログにしか残らない。しかも**ホストのテストがその挙動を固定していた** | レビュー指摘 |
| 51 | `wasm stop` に**入る道が無い**。走っている間はシェルが止まっているので、書いても「動いているアプリはありません」としか言えない | レビュー指摘 |
| 52 | UART の枠が 2 で**ハードと合っていない**。UART0 がコンソール、UART1 が制御チャネルで、外に出せるのは 1 本だけ | レビュー指摘 |
| 53 | **予約ピンの表が試作機のものしか無かった。** v1 では LCD (G8-G14)・SD (G39-G42)・制御チャネル (G15/G16)・ログ UART (G43/G44) が素通しで、逆に Grove の I2C (G17/G18) が塞がっていた。`gpio set 12` で画面が、`gpio set 15` で PC との通信が死ぬ状態 | I2C / UART を予約表に通したときに発覚（既存の穴） |
| 54 | **ゲストのモジュールでファームが落ちる。** 上流の `m3_LoadModule` は失敗してもモジュールをランタイムに繋ぐ（コメントに明記あり）のに、こちらでも `m3_FreeModule` していて二重解放になっていた。線形メモリを大きく宣言した `.wasm` を置くだけで再起動する | **AI が自力で発見**（Rust 用に足した fixture `f_bigmem` で segfault） |
| 55 | **`cdk.py push` が複数フレームの転送で壊れる。** 受け側が 1 周 256 バイトしか汲まず、921600 baud（約 92 バイト/ms）に追いつかずに受信リングが溢れていた。C のアプリはどれも 1 フレームに収まっていたので通っていなかった | **AI が自力で発見**（Rust のアプリ 10 本中 6 本が失敗。END の CRC 照合が捕まえた） |
| 56 | Rust の `prelude` に `gfx` が無く、ハンドル型に `Debug` も無かった（`?` や `unwrap_err()` で必ず躓く） | **AI が自力で発見**（fixture を書いていてコンパイルエラー） |
| 57 | `du` の MB 表示の丸めが `1024*104`（正しくは `1024*1024/10`）。1.5M が 1.4M になる | **レビュー指摘** |
| 58 | Rust のコンソールを `con.rs` に置いたら **git が add できない**（`CON` は Win32 の予約デバイス名） | **AI が自力で発見**（git のエラー） |
| 59 | **エディタの中で `Shift+PgUp` を押すと画面が壊れる。** 代替画面の上に主画面の履歴が描かれる。積むほうは `alt_active` を見ていたのに、遡るほう (`cdk_term_view_scroll`) で見落としていた | **AI が自力で発見**（実機のエディタで） |
| 60 | **2 回目以降の `wifi connect` が黙って繋がらない。** `esp_wifi_start()` は 2 回目も `ESP_OK` を返す（冪等）のに `ESP_ERR_WIFI_NOT_STOPPED` が返る前提で書かれており、`ESP_OK` の枝は 「STA_START イベントが繋ぎに行く」に任せていた。STA_START は最初の 1 回しか 上がらないので誰も `esp_wifi_connect()` を呼ばず、20 秒待って reason=0 で失敗。ドライバは何もしていないのでログにも一切出ない | **AI が自力で発見**（起動を非同期化したあと実機で。ログに `wifi:` が 1 行も 出ないことが手がかり） |
| 61 | **切断と再接続を繰り返すと fd と libssh2 のセッションが漏れる。** リモートで `exit` すると `cdk_ssh_read` は `s_open` を false にするだけで セッションもソケットも解放せず、`cdk_ssh_connect` は `if (s_open)` でしか 閉じないので、残ったものを黙って上書きしていた | **AI が自力で発見**（scp のために「開いているセッションを黙って壊さない」判定を足したら `exit` 後の再接続が `ESP_ERR_INVALID_STATE` で通らなくなり、その原因を追って判明） |
| 62 | **`libssh2_session_set_blocking(0)` だけではノンブロッキングにならない。** ソケットが blocking のままだと libssh2 の `recv()` がカーネルの中で待つので EAGAIN が返らず、メインループが止まる | **AI が自力で発見**（scp の転送は始まるのに `cdk.py shot` が「SHOT_INFO が返りません」で落ちた。画面が止まっている証拠） |
| 63 | **ホスト鍵の不一致と二重呼び出しを同じ `ESP_ERR_INVALID_STATE` で返していた。** `exit` 後に残ったセッションのせいで、**繋がる相手に「ホスト鍵が記録と一致しません」** と表示され、直す方向が完全に間違う | **AI が自力で発見**（scp の受信を実機で試したら出た） |
| 64 | **アプリ用の I2C がアドレス 8 個で打ち止め。** `dev_for` がデバイスハンドルを 8 個キャッシュしたまま解放せず、9 個目に `ESP_ERR_NO_MEM` を返していた。走査すると 0x08-0x0F で枠を使い切るので **0x10 より上を絶対に見つけられない**。シェルの `i2c scan` は `i2c_master_probe` を通って表に触らないため、同じピンで片方だけ見つかる | **実機**（ユーザーが ENV III を繋いで報告。シェルでは見えるのに wasm では 0 個） |
| 65 | **走査を 1 バイト読みで書いていて、相手を壊していた。** 待機中の SHT30 に読みを 1 回投げると、来ない続きを待って **SCL を握り続ける**。ユニットの VDD を抜くまで戻らず、同じバスの他のデバイスも道連れ。`i2c scan` でも回復しない。0 バイト書きは `i2c_master_transmit` が `write_size > 0` で弾くので、IDF で安全な走査は `i2c_master_probe` だけ。ABI に `i2c_probe` を足した。**C と Rust の両方に同じ穴があった**（Rust は `I2c::probe()` が 1 バイト読み） | **実機**（ユーザーが「i2cscan の後に envunit3 が反応しなくなる。電源を抜くと復活」と切り分けて報告） |
| 66 | **NACK が `CDK_E_PERM` (-2) に化けていた。** IDF は転送が DONE にならないと一律 `ESP_ERR_INVALID_STATE` を返し、`map_err` がそれを PERM に写す。「相手が居ない」が「予約ピンで禁止」と同じ番号になり、いちばん多い失敗がいちばん誤解を招いていた | **AI が自力で発見**（上の 2 件を追う途中で。番号だけでは切り分けられないことに気づいた） |
| 67 | **クロックストレッチの上限がドライバ既定の 2ms のままだった。** SHT30 は高精度測定で 15ms 引っぱるので、`0x2C06` を投げて即読むと読みだけが時間切れで落ちる | **AI が自力で発見**（IDF の `I2C_LL_SCL_WAIT_US_VAL_DEFAULT` を読んで） |

このほか、**製品コードではなくテスト側の期待値が誤っていたもの 3 件**（タブストップ 2、
CBT の終端文字 1）。実装は正しく、テストを直した。

不具合ではないが直したもの: `f_getfree("0:")` のドライブ番号決め打ちを
`esp_vfs_fat_info()` に変更。表示された空き容量が不審に見えたので調べたが、
数字自体は正しかった（カードに Raspberry Pi のブートパーティションが入っていた）。

### #13 #14 #24 #28 #31 — 同じ罠を 5 回踏んだ

シェルのヒアドキュメントに埋めた Python から C ソースを書くと、`\033` や
`\r\n` がバックスラッシュのまま残らない。5 回目は**検索文字列側**で潰れて
置換が当たらなかった（幸い assert で止まった）。

5 回払ったので、注意ではなく**規則**にする。

> **追跡下のファイルの中身を書き換えるなら Write / Edit ツールを使う。
> ヒアドキュメントはシェル内で閉じる作業だけに使う。**

最初は「エスケープを含む文字列は通さない」と書いたが、それだと毎回
「この文字列にエスケープは入っているか？」を判断することになる。
5 回とも判断を誤ったのだから、判断が要らない形にするしかない。

**正規表現で後から直そうとすると悪化する。** 復旧は `git checkout --`
からやり直すのが速い。

## 人間が介入した回数（30件）

| # | 内容 | 種別 |
|---|---|---|
| 1 | 仕様質問 4 件への回答（画面/桁数・試作機の入力・優先順位・ワープロ範囲） | 判断 |
| 2 | GPL 許容・26 行受け入れ・FT232 配線完了の報告 | 判断 |
| 3 | 四隅マーカーとグレー勾配が正常であることの確認 | 判断 |
| 4 | **バナー枠線のずれを指摘** + コミット方針の選択 | **不具合報告** |
| 5 | 認証情報を Git 履歴から消す依頼 | 新規指示 |
| 6 | マージ完了報告 + カメラ撮影スクリプト導入 + 継続指示 | 新規指示 |
| 7 | カメラ解像度変更 + 本ファイルの作成依頼 | 新規指示 |
| 8 | M2 の継続指示 | 新規指示 |
| 9 | **`.env` のユーザー名タイポを訂正**（`tesetuser` → `testuser`） | **設定ミスの訂正** |
| 10 | M3 の継続指示 | 新規指示 |
| 11 | microSD を挿入した報告 + M4 の継続指示 | 新規指示（物理作業を含む） |
| 12 | M5 の継続指示 | 新規指示 |
| 13 | M6 の継続指示 | 新規指示 |
| 14 | **ハードウェア仕様の検証依頼**（HARDWARE_DESIGN.md） | 新規指示 |
| 15 | **指摘 12 件すべてへの回答**（設計判断）+ 空きピン一覧と基板切り分けの依頼 | 判断 |
| 16 | SKK 辞書を注釈なし版に差し替える指示 | 新規指示 |
| 17 | **液晶コントローラを ILI9488 に決定** | 判断 |
| 18 | **本番回路のブレッドボード試作機を接続**（COM76）+ 動作確認の依頼 | 新規指示（物理作業を含む） |
| 19 | **SD の配線ミスを修正**、FT232 (COM75) の所在を指摘 | **設定ミスの訂正**（物理作業を含む） |
| 20 | **パネルの上端 1 行が見えない**／**地の文の白が暗い** の 2 点を指摘 | **不具合の指摘**（どちらも実機を見ないと分からない） |
| 21 | 他の色も暗くて読めないと報告し、**パレットごと明るくする案の可否を諮問**。提示した 3 案からガンマ補正を選択 | 判断 |
| 22 | **USB キーボードを接続**し、USB ホストの実装を依頼 | 新規指示（物理作業を含む） |
| 23 | **キーボードで打鍵**（abc → @ → : → "）。AI には押せないので検証そのものを代行 | **検証の代行**（物理作業） |
| 24 | 展示想定で**文字を 2 倍にするモード**を依頼。「まず方針だけ」と区切ってから着手を承認 | 新規指示 |
| 25 | M7 の続き（ステータス帯）を指示 | 新規指示 |
| 26 | さらに M7 の続き（公開鍵認証）を指示 | 新規指示 |
| 27 | **公開鍵をサーバーに登録**して動作を確認。残り（再接続）の実装を指示 | 新規指示（AI にできない作業） |
| 28 | **`set ssh.pass ""` が効かないことを指摘**。あわせて `authorized_keys` のファイル名誤り（`.authorized_keys`）を自分で見つけて修正 | **不具合の指摘** |
| 29 | `wifi connect` の紛らわしい失敗表示を直すよう指示 | **不具合の指摘** |
| 30 | 取扱説明書の作成を指示。続けて SKK の `l` の修正と、ビルド・書き込み手順の追記を指示 | 新規指示 |

物理作業（FT232 の配線、microSD の挿入、カメラの設置）は人間しかできない。
18 番までは**すべて人間の側から先回りして行われた**もので、AI が作業を
止めて依頼したケースは無かった。

**23 番で初めて、AI から頼んで手を止めた。** USB キーボードの検証は
「キーを押す」ことそのものが要るので、先回りのしようがない。
撮影や配線と違って**一度やってもらえば済む作業ではなく、直すたびに
また押してもらう**ことになる。だから 1 回の打鍵から最大限を引き出す作り
（生のレポートと復号結果を並べて出す）を先に入れた。

## 自律ループが停止した理由（6件・M4〜M6 では 0 件）

| 理由 | 回数 | 内訳 |
|---|---|---|
| 仕様が決まらず判断を仰いだ | 3 | 初期の 4 問、M0 完了時の確認、部分帯転送＋同期状況 |
| 破壊的操作の承認待ち | 1 | Git 履歴の書き換え（4 コミット全部のハッシュが変わる） |
| 実機の目視確認を依頼 | 2 | パネルの向き（M0）、部分帯転送の位置（M1） |
| 仕様の判断を仰いだ（`wget`） | 1 | 同名の扱いとサイズ上限（2 問を 1 回で） |
| 実機が無く実機試験の手前で止めた（`wget`） | 1 | 人間の指示「実機テストまで来たらいったん停止」 |
| 制御チャネルが見えず接続を頼んだ（`wget`） | 1 | ログ/書き込みの COM81 だけ見えて、制御の COM75 が無かった |

「目視確認を依頼」の 2 件は、**スクリーンショットでは原理的に検出できない**もの。
`shot` はキャンバスのダンプなので、パネルへの転送が壊れていても正しい絵が返る。
カメラ (`cdk.py cam`) を導入したので、今後この 2 件は自力で確認できる。

## カメラ撮影（23回）

| # | 解像度 | 目的 | 結果 |
|---|---|---|---|
| 1 | 1280x720 | M1 の表示をパネル上で確認 | 枠・色・日本語とも正常。ただし 6x12 グリフは判読限界 |
| 2 | 1280x720 | `cdk.py cam` の疎通確認 | 同上 |
| 3 | 1920x1080 | 解像度変更後の判読性確認 | **本文がそのまま読める。**M2 で SSH 出力を写真から確認できる見込み |
| 4 | 1920x1080 | SSH 経由の `top` をパネルで確認 | 反転ヘッダ・桁揃え・連続再描画とも正常。**写真から内容を読めた** |
| 5 | 1920x1080 | **SD アクセス直後のパネルを確認**（M4） | 破壊なし。色分けも正常。`LICENCE.broadcom` が実機で読めた |
| 6-9 | 1920x1080 | **上端 1 画素ずらしの A/B 測定**（v1） | オフセット 0 と 1 で焼き分けて撮影し、相互相関で **+0.92 パネル画素**。`shot --verify` では原理的に見えない変更を数字で確認した |
| 10-23 | 1920x1080 | **パネルの伝達特性を測ろうとした**（v1） | **3 通り試して全部失敗。**カメラでは測れないと結論した（下記） |

M2 では写真から `top` の表示内容（反転ヘッダ・桁揃え）を直接読めた。
1280x720 では 6x12 グリフが判読限界だったので、解像度の変更が効いている。

**5 枚目はスクリーンショットでは代用できない。** M4 では LCD と SD が
同じ SPI バスとピン (G35) を共有しており、壊れるとしたらパネルへの転送。
`shot` はキャンバスのダンプなので、転送が壊れていても正しい絵を返す。
「SD アクセス中に画面が壊れないこと」は**カメラでしか確認できない**。

**画像で初めて見つかった不具合: 2件**

**#7 バナー枠線のずれ**（人間が指摘）。
これは人間が指摘したもので、AI 側はスクリーンショットとホストの基準画像が
バイト単位で一致していたため「正しい」と判断していた。
**両者が同じコードで同じ間違いを描いていれば一致してしまう** という、
自己検証の構造的な穴が出た例。

**#21 カーソルが 7 桁ずれる**（AI がスクリーンショットの画素を計測して発見）。
行の中身は正しく、`gpio` も履歴も期待通り動いていたので、
文字列を見るテストでは何も落ちなかった。「見た目だけがおかしい」不具合は
画面を実際に見ないと見つからない。

このときは目視で判断がつかなかったので、**セルごとの白画素率を数えて
反転表示（カーソル）がどの桁にあるかを機械的に求めた**。
写真や画像を「読む」のではなく「測る」と、判別しづらい表示でも
はっきり答えが出る。ホスト側にも回帰テストを足してある
（`ESC[<n>C` の n を見る）。

**#22 FATFS の LFN**（AI が `ls` の画面から発見）。
不具合そのものは機能的なもので「見た目の異常」ではない。
ログには `rc=-16` としか出ておらず、SD の故障・ディレクトリ不在・権限と
候補が絞れなかった。決め手は**画面に出ていた `LICENC~1.BRO`** という
チルダ付きの短縮名で、これで「長いファイル名が無効」と一手で確定した。
画面が原因究明の材料になった例として数えるが、
「画像でしか見つからない不具合」ではないので上の 2 件とは分けている。

### 画像の読み違い（1件・実害なし）

M4 の検証中、320x240 のスクリーンショットを見て
`testuser@203.0.113.10` の `@` が抜けていると判断した。
実際には出ており、6x12 の `@` が縮小画像で `0` に見えていただけだった。

確かめ方は #21 と同じで、**該当セルの画素を 6x12 のドット図に起こして形を見た**。

```
.###.
#...#
#..##
#.#.#
#.#.#
#.#.#
#..#.
#...#
.###.
```

**小さいグリフを画像から目で読むのは信頼できない。**
おかしいと思ったら、読むのをやめて測ること。

---

## 実機で通していない分岐をどう潰すか（M4）

`known_hosts` の**「鍵が違ったら接続を断る」枝は、外から普通に叩けない**。
正しいサーバーに繋いでいる限り一度も走らないので、
放っておくと「コードを読んで正しそうだから正しい」で終わる。

これは #7（バナー枠線）で踏んだのと同じ穴で、そのときは人間が画面を見て気づいた。
同じ形の見落としを繰り返さないために、故意に壊すビルドを用意した。

```
idf.py build -DCDK_FAULT_KNOWNHOSTS=1   # 照合用の鍵の末尾ビットを反転する
```

既定は無効で、CMake の警告が出るようにしてある。

**最初の版は「壊し方」を間違えていた。** 鍵そのものを壊したので、記録も
同じように壊れて一致してしまい、細工したのに普通に繋がった。
壊すのを**照合に使う側だけ**にすると、記録には本物が入るので、
1 つのビルドで「1 回目は記録して繋がる → 2 回目以降は必ず断る」まで通せる。

M4 では 5 経路すべてを実機で通した。

| 経路 | 通し方 | 結果 |
|---|---|---|
| 未登録 → 記録 (TOFU) | そのまま接続 | 記録して接続 |
| 一致 | 通常ビルドで再接続 | `記録と一致` |
| **不一致 → 拒否** | **故意に壊すビルド** | `ESP_ERR_INVALID_STATE` |
| 拒否のあとの再試行 | 同じ起動のまま 7 回 | 毎回断る。固まらない |
| 記録の削除 | `hostkey forget` | 次が TOFU に戻る |

拒否を確認したあと**通常ビルドに戻して接続できることまで確認する**。
CMake のキャッシュ変数なので、消し忘れると壊れたビルドが残り続ける。

### ついでに分かったこと

拒否を 5 回繰り返すと PSRAM の空きが約 1KB 減るが、**リークではない**。
放置すると戻る。閉じた TCP コネクションの制御ブロックが
TIME_WAIT の間だけ残っているため（1 接続あたり約 200 バイト）。
内部ヒープの空きは 166,011 バイトで前後とも 1 バイトも動かなかった。

「数字が減った＝リーク」と決めつける前に、時間をおいてもう一度測ること。

---

## 検証そのものが壊れていた件（M5）

**`selftest` は M2 から一度も通っていなかった。** 起動画面に WiFi の IP と
SD のカード名が出るようになり、基準画像 `banner.vt` と一致しなくなっていた。
M5 で久しぶりに走らせて気づいた。

不具合 #26 として数えているが、性質が違う。

- 検証されなかった期間は M2 → M5 の 3 マイルストーン
- その間に「ホストと実機が同じ絵を描く」ことは一度も確かめていない
- それでも表示の不具合は #21（カーソルの桁ずれ）1 件しか出ていない

**失敗したまま誰も見ていない検証は、無いのと同じ。** 緑を確認しないなら、
テストを書いていないのと変わらない。M0 と M1 では完了条件として毎回
実行していたのに、機能を足すことに気を取られて回さなくなっていた。

直し方は「基準画像を実機の起動画面に合わせる」ではなく、
**実機の画面を確定的にできる経路を作る**ことにした（`CDK_MSG_VT`）。
端末を作り直してから同じバイト列を流すので、起動時に何が表示されていても
比較できる。基準画像を実機に合わせにいくと、実機が壊れたときに
基準画像も一緒に壊れる。

ついでに未確定文字列（日本語入力のプリエディット）も比較対象に入れた。
実機だけで重ね描きしていたら、この検証の外に出ていた。

再発防止として DESIGN.md §13 に「次のマイルストーンを始める前に
ctest と selftest を両方通す」と入れた。ホスト側だけなら Claude Code の
`Stop` フックで自動化できる（実機不要・1 秒）。

## 日本語入力をどう検証したか（M5）

画面に出る日本語は、**読める** ことと **桁が合っている** ことが別々に壊れる。

| 見たいこと | 方法 |
|---|---|
| 変換結果が正しい | ホストテスト（辞書 fixture 10 件 + 状態機械 82 チェック） |
| 辞書の探索が正しい | 実物 17.5 万件を別実装と 613 件照合 |
| 実機で同じ結果になる | `skkdict` コマンドで実機から引く |
| 桁が合っている | セルの画素を 6x12 のドット図に起こす |
| ホストと 1 ビットも違わない | `shot --verify-vt --preedit` |

**辞書を実機で引けることを、入力の配線より先に確かめた。** 一度に両方を
繋ぐと、変換できないときに辞書とキー配線のどちらが悪いのかを 6x12 の
画面越しに切り分けることになる。`skkdict` コマンドはそのために作った。

**「壊れていることを確かめる」テストも入れた。** 未確定文字列をわざと
違う文字列にすると比較が落ちることを確認している。これをやらないと、
「両方とも空だから一致した」を「合っている」と読み違える。
M4 のホスト鍵と同じ考え方。

---

## テストの当て方を変えた（M6）

エディタは「画面がどう見えるか」が仕様なのに、出力は**エスケープ列**という
中間形式で出る。バイト列を直接期待値にすると、描き方を変えるたびに
テストが落ちる。かといって目で見るのでは自動化にならない。

**吐いたエスケープ列を `cdk_term` に流し込み、画面のセルの中身と
カーソル位置で確かめる**ことにした。

```
cdk_edit → エスケープ列 → cdk_term → セルを読む → 期待値と比べる
```

すでに 1,000 チェック以上で検証してある VT パーサを、そのまま
「エディタが正しく描いたか」の物差しに使い回せる。おかげで
「全角が右端に来たときのカーソル位置」のような、文字列比較では
書きようがない期待値が 1 行で書けた。

```c
T_EQ_STR(row_text(0), "abcdefgあ");
T_EQ_INT(T.cy, 1);   /* 行が埋まったのでカーソルは次の行の頭 */
T_EQ_INT(T.cx, 0);
```

この当て方が **#29（ステータス行が画面をスクロールさせる）** を出した。
長いメッセージを最下行に書くと端末が改行し、画面全体が 1 行上がって
本文が消える。バイト列を見るテストでは絶対に見つからない。
実機で書いていたら「たまに本文が消える」として何時間か溶かしていた。

## 折り返しの判断を 1 か所に閉じ込めた（M6）

M1 の枠線ずれ、M3 のカーソル 7 桁ずれ、M5 の ▽ の桁——**表示が崩れる
不具合はどれも「同じことを 2 か所で計算していた」**。エディタは
折り返しがあるぶん、その機会が増える。

そこで「行の切れ目を決めるのは `wrap_break()` だけ」と決め、描画・
上下移動・スクロール・カーソル位置の 4 つを全部そこへ通した。
上下移動を書くときに「ここだけ自前で数えたほうが速い」と思う場面が
確かに来たが、通した。

結果として、実機で最初に試した折り返し + 上移動が一発で正しかった。

## 「固まる」不具合はテストの形で決まる（M6）

**#32** は、折り返した行がちょうど右端まで埋まっているときに
カーソルが動かなくなるというもの。実機で踏んだら「エディタが固まった」
としか見えない。画素を測っても分からないし、ログにも何も出ない。

見つかったのは、スクロールのテストに**1 つの論理行が画面より深く
折り返す**場合を足したから。それまでのテストは

```
l1 / l2 / l3 ... l7      短い行が 7 本
```

という形ばかりで、実機で実際に走る

```
あいうえお…（40 字が 8 行に折り返す）
```

という形が無かった。行数もカーソルの動きも「テストしている」つもりで、
**いちばん普通の使い方だけが抜けていた。**

テストの数ではなく、**形**が足りているかを見ること。

---

## 人間が書いた設計を AI がレビューした（2026-08-28）

M0〜M6 は「AI が書いたものを AI が検証する」だった。ここで初めて向きが逆になり、
**人間が書いたハードウェア仕様を AI が検証した**。指摘 12 件、うち重大 4 件。

ファームの不具合とは別枠で数えている。直したのは AI ではなく、
判断するのは人間だから。

### 何が効いたか

ピンの並びそのものは**正確だった**。使えないピン（octal PSRAM が食う GPIO35–37）も
ストラッピングピンも正しく除いてある。指摘が集中したのは別のところで、

> **ピンの選び方ではなく、その結果として何が使えなくなるか。**

たとえば「USB ホストを GPIO19/20 に置く」は、ピン割り当てとしては正しい。
ESP32-S3 の内蔵 USB PHY はそこにしかない。問題は、その PHY を
USB-Serial-JTAG と取り合う関係にあることで、**いまの開発ループ
（`cdk.py` の制御チャネル）が丸ごと消える**。ピン表を見ているだけでは出てこない。

同じ形が 2 件目にもあった。外部 JTAG は GPIO39–42 で、そこは SD。
内蔵 USB-JTAG は 1 件目で消える。**両方の debug 経路が同時に塞がる**。
どちらの割り当ても単体では妥当なので、2 つを並べて初めて見える。

### やり方

**記憶で断定せず、手元の一次情報に当たった。** ESP-IDF v5.5.5 のソースと
ドキュメントが全部ローカルにあるので、ADC のチャネル対応、USB PHY のピン、
SPI2 の IO_MUX、JTAG のピン、ストラッピングを 1 つずつ確認した。
電源 IC は TI の製品ページ。

これは効いた。たとえば「TPS631000 は 1.5A」と覚えていたら見落としたが、
実際の記載は `VIN ≥ 2.7V で 1.5A` という条件つきで、**2 セル NiMH は
常にその条件を下回る**。数字そのものより、数字に付いている条件のほうが
効くことがある。

**確認していないことも書いた。** JTAG の 4 信号がどのピンに対応するかは
追っていない（4 本とも SD なので結論が変わらないため）。
消費電力は液晶とキーボードの型番が未定なので概算。
検証の範囲を書かないレビューは、読む側が信用の置き所を決められない。

## 基板の切り分けを入れた（2026-08-28）

ハードウェアレビューの F-12 から。試作機（CoreS3）と最終ハード（v1）で
**PSRAM のモードが違う**（quad / octal）。間違えると起動時に abort する。
M0 で一度踏んでいて、そのとき「基板ごとに設定を分ける仕組みが要る」と
書いたまま置いてあったもの。

やったこと:

- `sdkconfig.defaults` を「基板に依らない部分」だけにして、
  `sdkconfig.defaults.cores3` / `.v1` に分けた
- `components_port/port_board/include/cdk_board.h` にピン番号と
  「その基板にその機能があるか」を集めた
- `cdk.py build --board v1` で切り替わる
- ポート層で分岐しているのは 3 か所だけ（spibus / display / storage）

### ピン番号が 2 か所にあるので、突き合わせるテストを足した

ピン番号は HARDWARE_DESIGN.md（人が読む表）と `cdk_board.h`（ファームが
使う定数）の両方にある。片方だけ直すと、**基板は正しいのにファームだけ
別のピンを叩く**。実機でしか出ないうえ、原因が分かりにくい。

`tools/check_board_pins.py` が両方を読んで突き合わせる（ctest の `board_pins`）。
スクリプトが持っているのは「どの定数がどの用途か」という対応だけで、
番号そのものは持たない。**番号を 3 か所に増やしたら意味がない。**

例によって「壊れたときに落ちるか」も確かめた。`CDK_BOARD_SD_CS` を
41 → 31 に変えると落ち、戻すと通る。M4 のホスト鍵と同じ考え方。

### 実装しなかったこと

**v1 の表示ドライバは書いていない。** 480x320 の SPI 液晶は ILI9488 か
ST7796 が多いが、初期化列も色の受け方も違う。**型番が決まっていない。**
当てずっぽうで書くと、動かないときに「何も出ない」のか「初期化が違う」のか
切り分けられなくなる。いまは明示的にエラーを返して、ピン番号だけログに出す。

一方 **SD は書けた**。ピンが確定していて、`esp_vfs_fat_sdspi_mount` に
渡すだけだから。同じ「未検証のコード」でも、決まっていないものを埋めるのと
決まっているものを写すのとでは、後で払う値段が違う。

### 切り分けても壊れていないことを確かめた

CoreS3 でビルド → 書き込み → `selftest` が 153,600 バイト完全一致。
SD もマウントし、SKK 辞書も読めている（`port_storage` を触ったので、
ここは実機で見ないと分からない）。

## 最終ハードの初火入れ（2026-08-28）

本番回路のブレッドボード試作機にファームを載せた。**M0 から積んできた
検証の仕組みが、そのまま最終ハードで動いた。**

```
selftest → boot + ping + vt + shot --verify
        → 480x320 = 307,200 バイトが基準画像と完全一致
```

DESIGN.md §0 で「80桁 x 26行」と決めたものが、実機でそのまま出た。

### 見つけた不具合 2 件

**#34 SPI ホストの番号を 1 つ間違えていた。** `spi_host_device_t` は
`SPI1_HOST=0 / SPI2_HOST=1 / SPI3_HOST=2` で、周辺機能名の数字とずれる。

| | 書いた値 | 実際 | 症状 |
|---|---|---|---|
| SD | 3 | 範囲外 | 起動時に `invalid host_id` で落ちる |
| LCD | 2 | SPI3 | **正常に見える。**IO_MUX 直結を失うだけ |

**SD が落ちなければ気づけなかった。** ハードウェアレビューで
「LCD を IO_MUX ピンに置いたのは良い判断」と書いておきながら、
ファームがその経路を使っていなかった。設定の誤りが「動くが遅い」に化けると、
テストでも実機でも見つからない。列挙子の名前で書くよう直した。

**直したあと、同じ間違いがビルドで止まるようにした。** コメントを足すだけでは
次に同じことが起きる。`soc/spi_pins.h` が IO_MUX のピン番号を持っているので、
HARDWARE_DESIGN.md が主張している「LCD は SPI2 の IO_MUX 直結だから速い」を
そのまま静的アサートにできる。

```c
_Static_assert(CDK_BOARD_LCD_SPI_HOST == SPI2_HOST, ...);
_Static_assert(CDK_BOARD_LCD_CS == SPI2_IOMUX_PIN_NUM_CS && ..., ...);
_Static_assert(CDK_BOARD_SD_SPI_HOST != CDK_BOARD_LCD_SPI_HOST, ...);
```

`check_board_pins.py` はピン**番号**の食い違いを見るが、#34 は番号ではなく
**ホスト**の取り違えだった。守る対象が違うので別の仕組みが要る。

故障注入で確かめた（`SPI2_HOST` を `2` に戻すとビルドが止まる）。
**そのとき副産物が 1 つ出た。** gcc は静的アサートの文字列をバイトのまま
診断に出すので、日本語で書いたメッセージが 8 進エスケープの羅列になり、
肝心の「どう直すか」がまったく読めなかった。**アサートのメッセージは
ASCII で書く**（説明は上のコメントに置く）。故障注入をしていなければ、
次に踏んだ人が読めないメッセージを受け取っていた。

**#35 画面が 180 度回っていた。** 初期化も転送も正しく、向きだけが違う。
**これは論理では決まらない**（パネルの実装と取り付け向き次第）。
カメラで撮って見るまで分からず、直したあとも「見て合わせた」としか
書きようがない。他の不具合と性質が違う。

### 3 つ目は不具合ではなく道具の前提

`cdk.py boot` が動かなかった。**リセット線が乗っている口が基板で違う**のに、
ツールは「CTRL の線にリセットがある」と決め打っていた。

| 役割 | CoreS3 | v1 |
|---|---|---|
| PROG（EN と GPIO0） | USB-Serial-JTAG | UART0 の USB シリアル |
| CTRL | 同上 | UART1 |
| LOG | FT232 | UART0（PROG と同じ） |

CoreS3 では PROG=CTRL、v1 では PROG=LOG。**症状は「起動ログが出ない」
だけ**なので、ポートの問題だと気づきにくい。`.cdk_board` を見て
自動で使い分けるようにした（基板を切り分けたときに書いている印が役に立った）。

### 実機でしか出ないものの割合

2 つは別の話なので分けて数える。

M0〜M6 の 33 件の内訳:

| | 件数 | 内訳 |
|---|---|---|
| 実機で**見つかった** | 11 | #1 #2 #7 #9 #18 #19 #21 #22 #23 #26 #30 |
| 実機で**しか出ない** | 5 | #1 #2 #18 #19 #22 |

差の 6 件（#7 #9 #21 #23 #26 #30）は、**ホストでも捕まえられたのに
実機で先に踏んだもの**。枠線の桁数 (#7) もプロンプトの桁ずれ (#21) も
かな入力の漏れ (#30) も純粋な C の側にあり、テストを書いていれば
出ていた。実機で見つかった数を「実機が要る証拠」として数えると、
自分のテストの穴を見落とす。

今回の 3 件は #34 #35 とツールの前提で、**全部が実機でしか出ない側**。
このうち #34 だけはビルドで止まる形に落とせた。#35（向き）は落とせない —
正しい向きは論理では決まらないので、目で見るしかない。
最終ハードへ移る作業は、ホストで先回りできる比率がいちばん低い。
逆に言えばそれ以外はホストで潰してあったので、初火入れで残っていたのが
この 3 件で済んだ。

## パネル 2 件の指摘（2026-08-28）

人間から「上端 1 行が見えない」「地の文の白が暗い」の 2 点。
**どちらも実機を見ないと分からない**（#35 の向きと同じ性質）。

### 上端 1 行

キャンバスの行 y をパネルの行 y+1 に出す。ずらした分、下端 1 行は
パネルの外に出るので送らない。

**ここで `shot --verify` は役に立たない。** 比べているのはキャンバスで、
ずらしているのはパネルへの出し方だから、**オフセットが 0 でも 1 でも 2 でも
必ず通る**。自分の検証手段が構造的に見えない場所だと先に認めるほうが早い。

代わりに A/B を測った。オフセットを 0 に戻して焼き、同じ画面を撮って
2 枚を突き合わせる。

```
文字行のピッチ = 34 画像画素 / 12 パネル画素 → 2.833 倍
プロファイル相互相関 = +2.62 画像画素 = +0.92 パネル画素
```

最初は枠線のピークだけ見て「+0.75 画像画素」と出た。ピーク行は量子化されて
いるので単独では足りない。**プロファイル全体の相互相関**にしたら 0.92 になった。
1 画素ずらしたことを、目ではなく数字で確かめられた。

### 地の文の白

`default_fg` が `palette[7]` = 0xE5E5E5 だった。xterm の既定だが、
これは白ではなく **90% の灰色**。`palette[15]`（純白）に変えた。

先に「本当に上限なのか」を確かめた。

| 確かめたこと | 結果 |
|---|---|
| ドライバの RGB565→RGB666 変換 | 0xFFFF → 63/63/63。変換では落ちていない |
| バックライト | 起動時から duty 100% |
| 変更後の実測（写真の字の芯） | 青 254 で飽和 |

**つまりファーム側にこれ以上の余地は無い。** まだ暗いなら残る手はハードウェア
（バックライト電流・パネルのコントラスト）で、そう言えるだけの根拠を先に取った。

パレット自体は xterm 標準のまま。明示的な SGR 37 は今も 0xE5E5E5 で、
37 と 97 の区別も残る。

### 巻き添えで出た 2 件

**#36 `ctest` は建て直さない。** `default_fg` を変えたあと ctest は
18/18 で通ったが、そのあと selftest だけが落ちた。基準画像を作る
`cdk_render.exe` が古いままで、**実機とホストで違うコードを比べていた**。
ctest はビルド済みのバイナリを走らせるだけなので、こうなる。

怖いのは落ちたことではなく、**その手前で「18/18 通った」と出ていたこと**。
`shot --verify` の前に必ずホストを建て直すようにした（実行して
`cdk_render.exe` の更新時刻が進むことを確認済み）。

**#37 ヒアドキュメントで `\n` が潰れた。6 度目。** 今回は Python の
文字列リテラルが行の途中で切れて構文エラーになる形。書いた直後に
`cat -A` で見て気づいた。**「今回は大丈夫」と判断したときに起きている。**
規則は判断を挟まない形にしてあるのに、また判断した。直しは記録どおり
Edit ツールで入れた。

## 測れないと分かるまで（2026-08-29）

「他の色も暗くて読めない。パレットごと明るくしたほうがいいか」という相談。

原因は 2 つ重なっていた。xterm の**通常色は 0xCD = 80%** しかなく、
バナーの緑 (`ESC[32m` = 0x00CD00) は 1 チャネルだけなので条件が最悪。
そこにパネル自身の沈みが乗る。

### カメラで測ろうとして 3 回失敗した

「ガンマをいくつにするか」を数字で出そうとして、全部駄目だった。

| やったこと | なぜ駄目だったか |
|---|---|
| 横並びのグレーランプを 1 枚撮る | 視野角で場所ごとに明るさが違い、**単調なランプが単調に写らない**（v=78 が v=177 より明るく出た） |
| 画面全体を 1 色で塗り、階調ごとに撮る | **写真ごとに露出が変わる**。黒と白の比が 1.38:1 まで潰れた |
| 同じ写真の中で緑と白の比を取る | 白が 255 で**飽和**していて比が動かない（1.0/1.8/2.6 で 0.873→0.878） |

3 番目は「同一フレーム内の比なら露出は関係ない」という理屈自体は正しく、
1 番目・2 番目の失敗を踏まえて組み直したもの。それでも飽和で駄目だった。

**引き際を決めておくべきだった。** 1 回目で「カメラは測定器ではない」と
気づけたはずで、実際には 3 回やって 14 枚撮ってから諦めている。
[上端 1 画素ずらし](#) は A/B の**差**を見ていたので測れたが、今回は
**絶対値**が要る。同じカメラでも、測れるものと測れないものがある。

結論は #35（画面の向き）と同じ。**人が見て決めるしかない。**
そのかわり `set gamma 26` でその場で変わり NVS に残るようにして、
焼き直さずに追い込めるようにした。判断は人に返すが、**試行の回転は速くする**。

### 検証を巻き添えにしないための工夫

ガンマを実機で変えられるようにすると、ホストの基準画像とずれる。
放っておくと `set gamma` を打った瞬間に `shot --verify` が落ちて、
**しかも落ちる理由がガンマ違いなので「実機が壊れた」ように見える**。

`SHOT_INFO` の予約バイトに実機のガンマを載せ、`cdk.py` が
`cdk_render --gamma=N` へ渡すようにした。2.2 / 2.6 / 3.0 のどれでも
完全一致のままであることを確認済み。

**整数演算だけで書いた。** `powf` はライブラリ実装によって最終ビットが
違いうるので、ホストと実機で 1 ビットずれた画像ができる。原因を追いにくい
落ち方をするので、16.16 固定小数の平方根を積んで x^(1/gamma) を作った。

### #38 と、7 度目のヒアドキュメント

`set gamma` で書いた値が再起動で消えたように見えた。NVS を開く
`cdk_cfg_init()` が WiFi 接続時にしか呼ばれておらず、起動時のガンマ適用が
毎回「未設定」に落ちていた。`set` の一覧には値が出ているのに画面が変わらない、
という分かりにくい症状になる。

ヒアドキュメントの `\n` 潰れは**7 度目**。今回はシェルではなく
**ツール呼び出しの JSON 層**で 1 段落ちた。規則（追跡下のファイルは
Write / Edit を使う）は 5 回目のときに作ってあり、守っていれば起きなかった。
経路が増えるたびに同じ失敗が別の顔で出てくる。

## 自分では押せないものを検証する（2026-08-29）

USB キーボードの実装。**これまでと決定的に違うのは、AI が入力を発生させられない**
こと。`shot --verify` も A/B 撮影も故障注入も、全部こちらから動かせたが、
キーは人が押すしかない。

### 1 回の打鍵で最大限を知る

往復が高くつくので、**生のレポートと復号結果を 1 行に並べて出す**ようにした。

```
report 00 | 2F 00 00 00 00 00 -> '@'
report 02 | 1F 00 00 00 00 00 -> '"'
```

左が USB から届いたバイト、右がこちらの解釈。**押した文字が違うときに、
バスの問題なのか配列表の問題なのかが 1 行で分かれる。**
配列表はホストテストで固められるので、人に頼むのは「バスから何が届くか」だけ。

### 配列は 1 打鍵で確定する

US と JIS は**同じキーの usage id が同じで刻印だけが違う**。
`espressif/usb_host_hid` は HID ディスクリプタの `bCountryCode` を外に出さない
ので、挿さっているものからは判定できない。

決め手は `@` がどこから出るか。US は Shift+2 (0x1F)、JIS は P の右 (0x2F)。
US のまま打ってもらったら `[` が出た。**それだけで JIS と確定した。**

### #39 — 自分のログで自分の首を絞めた

立ち上げ用の詳細ログを「最初の 24 レポートだけ INFO」にしていたが、
**キーを離したときの全ゼロレポートも枠を消費していた**。情報量ゼロのもので
枠が半分潰れ、頼んだ打鍵 (`abc` → `@`) は枠を使い切ったあとに来た。

人に打ってもらったのに何も残らない、という一番もったいない失敗。
幸い**打った文字はシェルに入るので画面に残っていて**、写真から
`$ abc[` を読んで確定できた。検証経路を 2 つ持っていたことに救われた。

キーが乗っているレポートだけ数えるよう直した。

### レポートのまま渡す

USB のタスクが積むのは**キーではなくレポート**。キーに変換してから積むと、
CapsLock の状態とオートリピートの時計を 2 つのタスクから触ることになる。
レポートのまま渡せば、状態はぜんぶメインループ側に閉じる。

オートリピートは**呼び出し側の時計で進める**。ブートキーボードは状態が
変わったときしかレポートを送らないので、レポート駆動だと
「別のキーを押したときだけ連射される」ことになる。実機で気づくと厄介な種類の
間違いで、ホストテストで先に固定できた（時刻が一周する場合も）。

## 方針を先に出す（2026-08-29）

展示用の 2 倍表示。**「まず方針だけ教えて」と区切られた**のがこれまでと違う。

書く前に見せたことで、着手前に 3 つ決まった。

| 出した論点 | 決まったこと |
|---|---|
| 24px フォントを持ってくるか、画素を広げるか | **広げる。** 別フォントは字形もカバー範囲も変わって「その字だけ出ない」問題を新しく作る |
| 実行時に切り替えるか、再起動を挟むか | **再起動。** 端末を作り直す必要があり、その場でやると画面が消える |
| 40桁 x 13行で足りるか | 展示なら可 |

**3 番目は自分では決められなかった。** 13 行は SSH にはかなり狭く、
「遠くから読める」ことをどれだけ優先するかは使う人にしか分からない。
実装してから聞くと、駄目だったときに全部捨てることになる。

### 検証の穴を先に塞いだ

倍率を実機で変えられるようにすると、ホストの基準画像とずれる。
ガンマのときに通った道なので、**今回は最初から `SHOT_INFO` に載せた**。
2 倍にしても `shot --verify` は完全一致のまま。

同じ形の問題が 2 回続けて出たので、**「実機側で見た目を変えられるように
したら、基準レンダラにも同じ値を渡す」**が定型になった。

### #7 と同じ壊れ方を機械で止める

40 桁用のバナーを新しく書いたが、これは #7（枠線の桁数が中身と合っていない）
とまったく同じ地雷を踏みうる。しかも #7 は**スクリーンショットとホストの
基準画像がバイト単位で一致したまま**起きた（同じコードが同じ間違いを描く）。

`tools/check_banner_width.py` を ctest に足した。桁数の上限だけでなく
**枠線の行の幅が揃っていること**も見る。故障注入で確認済み
（上辺だけ 1 桁伸ばすと `36桁(行 3), 37桁(行 1)` と言って落ちる）。

実際、最初に書いた 40 桁バナーは枠と中身が合っていなかった。
書いた直後に数えたので気づけたが、目で見ていたら通していた。

## ステータス帯 — 仕様どおりに作らなかった（2026-08-29）

§0 は「26行 = 312px、**余りの 8px** を帯に使う」と書いてある。
そう作らなかったので、理由を残す。

- 8px に 12px のフォントは入らない
- 専用の小さいフォント（4x6 など）を作る手はあるが、**2 倍表示のときに
  帯だけ極小のまま**になり、展示で遠くから読めない
- 1 行使えば拡大率にそのまま追随する

代償は本文が 1 行減ること。「26行は仕方ない」で受け入れてもらった経緯が
あるので**既定は off** にした。仕様を変えるより、既定で影響しない形にする。

### 最初に考えた方法は SSH で壊れる

最下行を DECSTBM（`ESC[1;25r`）で守る案を先に考えた。これは駄目で、
**`vi` も `less` も `top` も自分でスクロール領域を設定するか `ESC[r` で
解除して全画面を使う**。SSH してそれらを動かすのがこの機械の主目的なので、
上書きは例外ではなく通常動作になる。

帯を端末グリッドの**外**に置き、端末には 1 行少なく渡す形にした。
エスケープを使わないので遠隔から触れない。ついでに #29（ステータス行が
幅を超えて画面全体がスクロールし本文が消える）の経路も構造的に消えた。

### 「検証中だけ描かない」は作らなかった

帯の中身（IP・電池）はホストで再現できないので、`shot --verify` と
食い違う。実機側に「検証中は帯を描かない」フラグを入れれば通るが、
**それは検証されているときだけ挙動が違う装置**で、#26（selftest が M2 から
壊れていた）と同じ穴になる。解除条件が曖昧なのも危ない。

装置に分岐を足すのではなく、**比較の範囲を本文に限った**。
`SHOT_INFO` に帯の高さを載せ、`cdk_render` にも同じ値を渡す。

最初この高さを「帯 1 行 = 24px」にして落ちた。実際は
`12行 x 24px = 288` で残り **32px**（帯 24 + 端数 8）。帯の高さだけにすると
端数の 8px が比較に残り、本文を比べているつもりで帯の一部を比べていた。
本文が終わる位置から下を全部、と計算し直した。

### 出せないものは出さない

電池電圧は GPIO5 (ADC1_CH4) から読めるが、**分圧比が未定**なので
正しい値にならない。`batt_mv` が 0 のときは何も出さない作りにして、
比が決まるまで出さないことにした。0.00V と出すのは嘘になる。

### 自分の足を踏んだ小ネタ

`skk on` のまま `set statusbar off` を送って、コマンドがかなに変換されて
届かなかった。#30（エディタから戻ってもかな入力が続く）とまったく同じ形を、
今度は**自分の操作で**踏んだ。実機を触るときはモードを戻してから。

## 公開鍵認証 — 検証の限界がはっきりしていた（2026-08-29）

**サーバー側の `authorized_keys` に登録できないので、「鍵で入れた」ことは
私には確かめられない。** その前提で、確かめられる範囲を先に決めてから作った。

| 確かめられること | 手段 |
|---|---|
| 符号化が OpenSSH と同じか | **`ssh-keygen -l -f` と突き合わせ**（別実装） |
| PEM の書き→読みが往復するか | 生成時と `ssh key` の指紋が一致するか |
| 鍵をサーバーへ提示できたか | `rc` が -16（形式が違う）か -18（未登録）か |
| パスワードを壊していないか | 鍵があっても接続できること |

ホストテストの期待値も **`ssh-keygen` が作った本物の鍵**にした。
自分で組んだ期待値と自分の実装を比べても、同じ間違いをしていれば通る（#7 の形）。

### 実機で踏んだ 2 つ

**#40 スタックが溢れた。** `ssh` を叩いたら再起動した。

```
***ERROR*** A stack overflow in task main has been detected.
```

libssh2 が PEM を読んで EC 署名するところがメインタスクの上で走る。
8192 では足りなかった。**増やしただけで終わりにせず、接続直後に
実測値をログへ出すようにした**（いまは 16384 で残り 8500 バイト）。
余裕を勘で決めていると、次に何か足したときまた同じことになる。

**#41 `rc=-16 (Key type not supported)`。** 公開鍵ファイルに NULL を渡すと
mbedTLS が秘密鍵から導出しようとするが、**その経路は RSA 専用**だった
（`_libssh2_mbedtls_pub_priv_key` が `MBEDTLS_PK_RSA` 以外を弾く）。

厄介なのは、**この失敗が「鍵が未登録」と区別できない**こと。どちらも
「公開鍵で入れなかった」としか見えない。`.pub` を明示的に渡したら
`rc=-18` に変わり、そこで初めて「提示はできている」と分かった。
**エラー番号が変わったことが、前進の唯一の証拠だった。**

### ed25519 が使えないことを先に書いた

`LIBSSH2_ED25519 = 0`。`ssh-keygen` の既定が ed25519 なので、黙っていると
利用者は必ず最初にそれを作って詰まる。ヘッダ・`ssh key` の失敗メッセージ・
DESIGN.md の 3 か所に書いた。

### 8 度目のエスケープ潰れ

`'\0'` を書こうとして、**ツール呼び出しの JSON 層**で 1 段落ち、
C ソースに**本物の NUL バイト**が入った。grep が「バイナリファイル」と
言って初めて気づいた。7 度目と同じ経路。規則（追跡下のファイルは
Write / Edit）を守っていれば起きていない。

## 再接続 — 起こせない事象をどう通すか（2026-08-29）

M7 の最後。通信断で繋ぎ直す。

### 繋ぎ直してよい切れ方だけ繋ぎ直す

ここが設計の中心だった。**`exit` で繋ぎ直すと、SSH から出られない機械になる。**
「切れた」を 1 つにまとめると必ずこうなる。

| 切れ方 | 繋ぎ直すか |
|---|---|
| 通信断 | する |
| リモートが閉じた (`exit`) | しない |
| `ssh close` | しない |

read/write のエラー経路と `libssh2_channel_eof()` の経路はもともと別だったので、
理由を持たせるだけで分かれた。**新しい判定は 1 つも書いていない。**

### 通信断は起こせないので注入した

WiFi を落とす手段もサーバーを止める手段も無い。**`EOF` を一時的に `ERROR` と
して扱う故障注入**で経路を通した。ログに

```
22583 リモートがセッションを閉じました
25552 （再接続）ホスト鍵 SHA1: ...
27189 接続しました
```

と並び、1 秒待ってから繋ぎ直しているのが見える。戻したあと `exit` が
繋ぎ直さないことも確認した。**注入して通し、戻して通さないことまで見る**のが
1 組。片方だけだと「常に繋ぎ直す」実装でも通ってしまう。

### 通せなかったもの

**キーで中止する経路は実機で通していない。** 相手が生きていると 1 回目で
繋がってしまい、止める隙が無い。状態機械はホストテストで見ているが、
結線は目視だけ。そう書いて残した。

### バックオフで固定した 2 つ

どちらも「動いているように見えて実は壊れている」種類:

- **時刻の一周。** 符号なしで比べると 49 日で一周した瞬間に「まだ来ていない」
  と判断して永久に繋ぎ直さなくなる。SSH は繋ぎっぱなしにするので実際にまたぐ。
- **上限で頭打ちにしてから倍にする。** 先に倍にすると 32bit を溢れて待ちが
  短くなり、**上限を上げたのに連打になる**という逆の壊れ方をする。

2 つ目はテストが先に見つけた。ついでに「上限自体も 2^31 ms を超えられない」
（一周判定を符号付きの差でやっている以上そうなる）ことも分かり、
そこで頭打ちにした。**テストが実装の前提を 1 つ掘り出した。**

### 9 度目のエスケープ潰れ

同じ回で 2 回踏んだ。`'\0'` が NUL バイトになり、`\033` と `\r\n` が
実体になった。どちらも Python ヒアドキュメント経由。
**規則は 5 回目に作ってある。守っていない私の問題で、規則の問題ではない。**
C ソースに手を入れるときは Write / Edit だけを使う。

## #42 消せない設定（2026-08-29・人間の指摘）

`set ssh.pass ""` でパスワードを消したのに復活する、という指摘。**そのとおりだった。**

```
set ssh.pass ""   → NVS のキーを消す
load_config()     → 「未設定」と見なして secrets.h の種を書き戻す
```

`cfg_or_seed()` が毎回「空なら種を撒く」をやっていた。**空にする＝未設定に戻す
なので、消した意思と初回の状態を区別できていない。** 結果、認証情報を消す手段が
無かった。パスワードを消して公開鍵だけにする、という一番したいことができない。

種を撒くのは本当に初回だけにした。判定は「設定キーが 1 つでもあるか」。
一度でも使われた機械なら、いまの中身がその人の意思。

### 直ったことの確かめ方

`set ssh.pass ""` のあと `load_config()` を走らせて（`wifi connect`）、
`set` で `(未設定)` のままなのを見る、では**弱い**。表示だけ直っていても通る。

**パスワードが無い状態で SSH が繋がるか**を見た。繋がるなら公開鍵しか
経路が無いので、消えていることと鍵が効いていることが同時に確定する。

```
ssh.pass (未設定)
→ 公開鍵で認証しました (/sdcard/id_ecdsa)
```

### ついでに直した表示

`ssh.key` が `(未設定)` と出ていたが、実際は既定の `/sdcard/id_ecdsa` が
効いている。**「設定しないと動かない」のか「既定で動いている」のかが
読み取れない**ので、既定値のあるものはその値を出すようにした。

```
ssh.key    /sdcard/id_ecdsa (既定)
ssh.recon  on (既定)
```

### 公開鍵は人間側の原因だった

`rc=-18` が続いていた件は、サーバーのファイル名が `.ssh/.authorized_keys`
（先頭にドット）だったため。人間が自分で見つけて直した。

こちらは「実機は正しい鍵を出している」ところまでしか確かめられていなかった
（SD 上の `.pub` と秘密鍵から導出した公開鍵が一致、`ssh-keygen -l` と指紋が一致）。
**その切り分けがあったので、探す場所がサーバー側だと分かっていた。**

## #43 生きているのに「失敗」と出る（2026-08-29・人間の指摘）

接続済みで `wifi connect` を叩くと、20 秒待ってから赤字で
`失敗 ESP_ERR_TIMEOUT` と出る。**接続は生きたまま。**

`esp_wifi_connect()` は接続中に呼んでも新しい GOT_IP イベントを上げない。
こちらはイベントを待っているので、必ずタイムアウトまで座り込む。

同じ SSID なら何もせず成功を返すようにした。SSID が違うときは切って繋ぎ直す
（設定を変えて叩いたのに前の AP のままのほうが分かりにくい）。

**「動いているのに失敗と言う」類は、動かないより始末が悪い。** 見た人は
まず接続を疑うので、原因から遠いところを探し始める。#41（`rc=-16` が
「鍵が未登録」と区別できない）と同じ形で、**表示が状態を正しく表していない**
という一点で共通している。

この 2 件はどちらも自動テストでは捕まらない。壊れているのは
「機械の動き」ではなく「人に伝わる内容」なので、使った人が言うまで分からない。

## #44 説明書を書いたら不具合が出た（2026-08-29）

取扱説明書に「かな入力から抜けるには `l`」と書いた。**書いた手順を実機で
なぞったら、抜けられなかった。**

```
$ にほん     ← nihon のあと l（末尾の n が打ちかけだった）
$ にほんっ   ← もう一度 l を押すと っ が出る
```

打ちかけのローマ字があるとモード切り替えキーが文字として扱われる。
`l` 自身が打ちかけになるので、次の `l` は `ll` = っ。**押すほど抜けられない。**

原因はローマ字表で `l` が小書き文字の前置き (`la`→ぁ、`ll`→っ) を
兼ねていたこと。同じ役割は `x` (`xa`→ぁ) が持っていて重複していた。

- `l*` と `q*` を表から外した（`くぁ` は `kw*` を足して拾えるようにした）
- モード切り替えは**打ちかけを吐き出してから必ず効く**ようにした
  （捨てると打った字が消えたように見えるので、`ん` は出してから切り替える）

### 説明書は検証の道具になる

これは**手順を書いて、そのとおり動かしてみた**から出た。
ホストテストも実機の selftest も通っていたし、変換そのものは動いていたので、
どちらにも引っかからない。**「使う人がやる順番でやってみる」以外に
見つけ方が無かった。**

同じ回で、`edit` は引数を省けないこと、シェルに Ctrl-B/F/U/K/W があること
（説明書に書き漏らしていた）も分かった。ソースから拾って実機で確かめる、を
1 項目ずつやると、書いてある嘘が落ちる。

### 既存のテストが落ちたのは正しい

`ltu` → `っ` を期待していたテストが落ちた。**製品の側が正しくて
テストが古い**ので、テストを直した。この判断を間違えて実装を戻すと、
せっかく直した不具合が復活する。

---

## M8（WebAssembly ユーザーアプリ）で分かったこと

**指示**: 「wasm を使って、ユーザーアプリをランタイムでロードできるようにしたい。
WASI や POSIX API 互換じゃなくていいので、軽量・簡素な独自 API も設計してほしい。」

人間が出した判断は 4 つ（ランタイム・実行モデル・描画 API の範囲・配布方法）。
そのうち**ランタイムだけ AI の推奨と違う選択**（AI は WAMR を推した。人間は wasm3）。

### wasm3 を選んだのは結果的に大きかった

AI が WAMR を推したのは「Espressif 公式コンポーネントがある」ためで、
人間が wasm3 を選んだのは別の理由だった。**やってみると後者のほうが
このプロジェクトの検証の作り方に合っていた。**

wasm3 は純 C99 の 12 ファイルなので、ホストビルドにそのまま入る。おかげで
`ctest` が**本物の `.wasm` を実機と同じソース**（`port_wasm_vm.c` /
`port_wasm_natives.c`）で回せる。M5 で「selftest が M2 から一度も通って
いなかった」ことを踏まえた設計目標に、いちばん効いた 1 手になった。

WAMR を選んでいたら、ホスト側は「偽のメモリを渡して自前の層だけ叩く」
テストになっていたはずで、**境界検査そのものは検証できなかった。**

### 実機でしか出ないものが 1 件

| | 内容 |
|---|---|
| #49 | 32KB のタスクスタックが内部 DRAM から取れない |

ホストでは 64bit のスタックが潤沢にあるので絶対に出ない。しかも
「空きメモリは 77KB ある」ので**総量を見ていると気づけない**。
最大ブロックを見て初めて分かった（`free` コマンドが両方出していたのが効いた）。

さらに、直したあとに測った高水位が「64KB 中 23,524 残り」で、
**hello.wasm ですら 42KB 使っている**ことが分かった。32KB のままだったら、
仮に確保できていてもスタックを踏み抜いていた。エラーが出たおかげで
踏み抜きを回避できたことになる。

### 検査そのものが空振りしていた（#47）

境界検査の対漏れを見る ctest を書いたら、いきなり「40 個すべて対になって
います」と通った。**通ったので疑って、わざと 1 個消してみたら、やはり
通った。** 区切りに使った置き換え文字が `@` を含んでいて、関数の本体が
最初の `;` で切れており、どの関数も「0 個 対 0 個」で一致していた。

M5 の「失敗したまま誰も見ていない検証は、無いのと同じ」の裏返しで、
**成功したまま何も見ていない検証**も同じだけ無意味だった。
新しい検査を足したら、落ちることを一度確かめる。

### レビューで見つかったものが 4 件（#50-#52 と `sock_connect`）

いずれも**実機では症状が出ないか、出ても原因が分かりにくい**もの:

- `con_write` が出力を捨てる（#50）— 画面から消えてログにしか残らない。
  しかも**ホストのテストがその挙動を「正しい」として固定していた。**
  テストが間違いを守る側に回ることがある。
- `wasm stop` に入る道が無い（#51）— 動かしてみても「動いているアプリは
  ありません」としか出ないので、壊れているのかコマンドが正しいのか分からない。
  この機械では**取扱説明書が検査でもある**（#44 がそれで見つかった）ので、
  書く前に消した。
- `sock_connect` が Ctrl-C を飲み込む — 実装前に指摘されたので、
  最初から刻む形で書いた。**いちばん詰まりやすい API がいちばん止まらない
  API になる**という筋の悪さは、動かす前に潰すしかない。

### 既存の穴が広がって見つかった（#53）

I2C と UART がピンを取るので予約表を通したら、**表が試作機 (CoreS3) の
ピンしか知らない**ことが分かった。v1 では液晶も SD も制御チャネルも
素通しで、逆に自分の基板の Grove I2C が塞がっていた。

`gpio` コマンドからも届く既存の穴で、M3 からずっとあった。
**新しい入口を作ったから見つかった**類の不具合で、機能追加が
既存コードの点検になった例。

### 同じ罠を 3 度踏んだ（#45）

`\033` が ESC の実体に潰れる。#13 / #14 と同じで、原因も同じ
（シェル経由で C のエスケープを書いた）。DEV_STATS に書いてあっても
踏むということで、**書くだけでは再発は止まらない。**
今回は途中から専用のファイル書き込みに切り替えて止まった。

### 数字

- 実機書き込み 4 回、実機ビルド 8 回、ホストビルド多数
- 実機で確かめたことは 10 項目（DESIGN.md §15.13 の表）
- カメラは 0 回（画面の内容だけで足りた）
- 自律ループの停止 0 回

### やり残し

**UART は実際のデバイスを繋いだ確認をしていない。** 手元に繋ぐものが
無く、ピンの拒否とバスを開けるところまで。**繋いだら動くはず、は検証ではない**
ので、DESIGN.md §15.14 と取扱説明書の両方に未検証と書いた。

**I2C は検証済み**（Unit ENV III / SHT30 + QMP6988 を G17/G18 に）。
このとき「繋いだら動くはず」が実際に外れた。動かなかったのはピンでも
配線でもなく、**アプリ用の I2C そのものに 4 件のバグ**（表の 64-67）。
走査は 0x10 より上を見つけられず、しかも走査するとセンサが止まった。
未検証と書いておいたのは正しかった。

---

## M8 続き（Rust の SDK）で分かったこと

**指示**: 「この独自 wasm API の、Rust 向けのクレート？SDK？やサンプルを書いてほしい。」
そのあと「Rust バージョンは 2024 でいきたい」。

DESIGN.md §15.10 に「同じ ABI に Rust から当てるのはファーム側の変更なしで
できる」と書いてあった。**当ててみたらファームを 2 か所直すことになった。**
書けると言い切ったまま試していなかったぶんが、そのまま出た。

### 新しい言語を足したら、既存の穴が 2 つ出た

| | 何が起きたか | なぜ M8 で見つからなかったか |
|---|---|---|
| #54 | 線形メモリを大きく宣言した `.wasm` で**ファームが二重解放で落ちる** | `m3_LoadModule` の**中で**失敗する fixture が無かった。`f_noentry` は load 成功後に落ち、ゴミバイト列は parse の段で弾かれる |
| #55 | `cdk.py push` が**複数フレームの転送で壊れる** | **C のアプリは最大 2,354 バイトで、どれも 1 フレーム (4KB) に収まっていた**。複数フレームを送る用事が一度も無かった |

どちらも「Rust だから」ではなく、**Rust のアプリが C より大きく、
より多くのメモリを宣言したから表に出た**もの。新しい使い手を足すと
既存の経路の未検証な部分が炙り出される、という形。

#55 は M8 で入れた「長さと全体の CRC を END で突き合わせる」がそのまま
効いた。無ければ壊れた `.wasm` が SD に置かれ、`wasm run` の
「読めません」から転送を疑うまでに遠回りしていた。
**転送の検査を入れておいた判断が、次の節目で回収された。**

#54 のほうが重い。**ゲストが持ち込むファイルでファームが落ちる**ので、
この機能でいちばん踏ませたくない類だった。上流の `m3_LoadModule` は
「失敗してもランタイムがモジュールを引き取る」と**コメントに明記して
いた**のに、こちらは読まずに解放していた。ベンダリングしたコードの
所有権の約束は、当てずっぽうで書くと静かに壊れる。

### 検査が空振りしていないかを、今度は先に試した

M8 で `wasm_natives_checked` が「0 個 対 0 個」で通っていた前例があるので、
新しい `abi_names_match` は**書いた直後に 2 通りの壊し方を試した**:

- 名前を 1 個消す → 落ちる
- 正規表現を壊して 0 件にする → 落ちる（下限の検査が効いた）

前回は通ったのを疑って壊してみて気づいた。今回は最初から手順に入れた。

### Rust だけが違う挙動が 1 つある

アロケータはバンプで解放しない（C 版の `cdk_alloc` と同じ）。線形メモリが
1MB なので、**確保を繰り返すループはいつか必ず落ちる。**

実機で測ったところ、70 バイトの `format!` を回すループは
**約 15,000 回**で尽きた（`memory allocation of 70 bytes failed`）。

同じループを C で書くと確保が起きない。**言語を足したことで、
同じ API なのに挙動が違う場所ができた**ことになる。サンプルはどれも
たまたま踏まない書き方だったので、測って初めて数字が出た。
取扱説明書とクレートの両方に「落ちる書き方 / 落ちない書き方」を並べた。

### パニックが画面に出るのが、そのまま利点になっている

```
panic: index out of bounds: the len is 3 but the index is 7 (apps\boom\src\lib.rs:21)
```

C 版は `落ちました: out of bounds memory access` としか出せない。
`no_std` で `#[panic_handler]` を自分で持てるので、`file:line` を出してから
トラップできる。**アプリを書く側から見て一番の差はここ**で、
`Result` や `format!` より効く。

### エディション 2024

利用者の指定。`unsafe extern` / `#[unsafe(no_mangle)]` / `static mut` 禁止の
3 点があり、3 つめだけアロケータに効いた（`AtomicUsize` に置き換え）。
それ以外は素直に通った。**最初のビルドが一発で通った**ので、
ここは想定していたより問題にならなかった。

### Windows の予約デバイス名

コンソールのモジュールを `con.rs` にしたら、**git がそのファイルだけ
add できなかった**（`open(): No such file or directory`）。`CON` は
`PRN` / `AUX` / `NUL` / `COM1` と同じ Win32 の予約名で、bash の `stat` は
通るのに Win32 の `open()` が転ぶ。`console.rs` にして `#[path]` で
呼び名だけ `con` に保った。

### 数字

- 実機書き込み 4 回、実機ビルド 6 回（うち CoreS3 の素通し確認 1）
- 不具合 5 件（#54-#58）。うち 1 件はレビュー指摘（`du` の丸め）
- サンプル 10 本。いちばん大きい `rs_du.wasm` で 18,945 バイト（上限 256KB）
- カメラ 0 回

### やり残し

- I2C と UART は C 版と同じく**実際のデバイスで未検証**
- crates.io への公開はしない（パス依存のまま）
- `std` 対応はしない

---

## スクロールバックで分かったこと

**指示**: 「コマンド実行結果が 1 画面に収まらずあふれることがあるので、
ターミナルのスクロールバッファを実装してほしい。」
あわせて「履歴は 200 行に。この作業を開始する前に今のブランチを main に
マージして、この作業自体は main で直接やって。」

### テストが空振りしていたことに、今度は自分で気づけた

M8 で `wasm_natives_checked` が「0 個 対 0 個」で通っていた前例があるので、
**新しい検査は書いた直後にわざと壊す**のを手順に入れてある。今回は
履歴側 4 条件・描画側 3 条件のすべてで落ちることを確かめた。

そのおかげで、**描画側のテストが本当に空振りしていた**ことも分かった。
`test_screen` の `count_color` は **どの字でも前景 60 / 背景 12 を返す**
（'A' も '2' も '4' も同じ）。字の違いを当てにしたテストは、通っても
何も見ていない。既存のケースが通っていたのは「0 より大きい」までしか
見ていなかったから。

最初はここで諦めて「原因が分からないので描画のテストは書けなかった」と
コミットしたが、**レビューで「具体的に何を確かめたか」を問われて調べ直し、
測定器のほうが壊れていたと分かった**。見方を「空白か、何か描かれているか」
（空白セルは背景色ちょうど 72 画素）に変えたら素直に書けた。

**「原因不明」で止めた判断が早すぎた。** 1 つ測れば分かることだった。

### 実機でしか出なかったものが 1 件

| | 内容 |
|---|---|
| #59 | エディタの中で `Shift+PgUp` を押すと画面が壊れる |

履歴に**積む**ほうは `alt_active` を見ていたのに、**遡る**ほうで
見落としていた。「記録しない」と「遡らせない」は別の判断で、片方だけ
書いて満足していた形。

ホストのテストでは出なかった。積む条件ばかり考えて、
「代替画面で遡ろうとしたらどうなるか」を試していなかったため。
直したあと、その条件もテストに足してある。

### 設計で効いたこと

`cdk_screen_draw` が行を `cdk_term_row(t, y)` からしか読んでいなかったので、
**そこにオフセットを入れるだけで描画側はほぼ変更なし**で済んだ。
M1 でこの 1 か所に絞ってあったのが、5 つ後の節目で効いた形。

`cdk_term_init` の形を変えず、履歴を後から足す口（`set_history`）にしたので、
ホストの基準レンダラ (`cdk_render`) は呼ばなければ今までと同じ。
`shot --verify` の比較が動かないまま入れられた。

### 数字

- 実機書き込み 3 回、実機ビルド 4 回（うち CoreS3 の素通し確認 1）
- 不具合 1 件（#59）
- ホストのテスト 17 ケース追加（履歴 13 / 描画 4）
- カメラ 0 回

---

## TLS で分かったこと（2026-09-01）

**指示**: 「wasm API について、いまネットワークソケットって TLS に容易には
つなげられないと思うんだけど、TLS 系の処理は ESP-IDF 側にまかせて、
とりえあず TLS 通信が使えるようにしてほしい。ひとまず HTTPS つなげられると
うれしい。」

### ABI を増やさずに済んだのは、前の設計の貯金だった

TLS は新しい口を 5 本（`tls_open` など）足す形になりがちだが、今回は
**インポートを 1 本も増やさずに入った。** `sock_open(CDK_SOCK_TLS)` に
型を足しただけで、`connect` / `send` / `recv` / `close` は同じ名前のまま。

効いたのは M8 の 2 つの判断:

1. **ゲストに渡すハンドルをスロット番号にしてあった**（fd を渡していない）。
   おかげでホストは「fd に見える整数」を返せばよく、TLS の実体は
   `port_sock.c` の中に閉じ込められた。上の 2 層は 1 行も変えていない。
2. **`sock_connect` がホスト名を文字列で持っていた。** IP だけを渡す API に
   していたら、SNI と証明書の照合のために新しい口が要った。

`abi_names_match` の `MIN_NAMES` は現在の個数ちょうどなので、名前を 1 本でも
増やすとそこも直すことになる。増やさない設計に寄せる圧力として効いていた。

### 「2 本目が失敗する」で済まなかった（その後 PSRAM で解決した）

同時に開ける TLS の本数を、はじめ 2 にした。mbedtls のセッションが
in 16KB + out 4KB で、内部 DRAM の空きが 75KB あるなら 2 本入るだろう、
という見積もり。

**1 回目は 2 本とも通ってしまった**（それぞれ 329 バイト取れた）。
ところが SSH を挟んだ後に同じものを走らせたら失敗した。ログを見ると:

```
E esp-aes: Failed to allocate memory
E esp-tls-mbedtls: mbedtls_ssl_handshake returned -0x0001
E esp-tls-mbedtls: write error :-0x0001
```

問題は失敗したことではなく、**壊れたのが 2 本目だけではなかった**こと。
内部 DRAM が枯れると、既に確立している 1 本目の read / write も
esp-aes の確保に失敗して落ちる。**「新しい接続が開けない」なら呼び出し側で
対処できるが、「動いている接続が巻き添えで壊れる」は対処のしようがない。**

いったん上限を 1 に下げた。空きヒープ次第でたまに通ることは分かっているが、
**たまたま通る数を上限にしてはいけない。**

この基板の内部 DRAM は、空きが 75KB あっても**連続では 31,744 バイトしか
取れない**。M8 で wasm のタスクスタックを PSRAM に追い出したのと同じ壁で、
「空き容量」ではなく「最大ブロック」を見るべきという教訓が 2 度目に出た。

### 症状ではなく確保の主を読んだら、上限が外れた

人間から「mbedTLS を PSRAM 配置にして同時 2 接続できる？」と聞かれて、
`sdkconfig` を変える前に**失敗しているのが誰の確保なのか**を読んだ。
`esp-aes: Failed to allocate memory` の出どころは `esp_aes_dma_core.c` で、
落ちているのは **DMA 記述子**の確保。しかも `MALLOC_CAP_DMA` 付きなので
**PSRAM には置けない**。

つまり「AES を PSRAM に移す」のは筋が悪く、正しくは
**mbedtls の 16KB/4KB を PSRAM へどけて、内部 DRAM を DMA 記述子のために
空ける**。`CONFIG_MBEDTLS_EXTERNAL_MEM_ALLOC=y` を入れたら 2 本とも通り、
4 本でも通った。**枯らしている側と、枯れて困っている側は別だった。**

一度成功しただけでは前と同じなので、3 回連続・SSH を挟んだ後・トラップで
落ちた後、をそれぞれ確かめてから 2 に上げた。4 本も一度は通ったが、
同じ密度で確かめていないので上限は 2 のままにしてある。

**払った代償はほぼ無かった。** ハンドシェイクは 1 本 1,917ms、2 本並行
1,880〜1,911ms、4 本並行 1,871〜1,920ms。この時間は網の往復と証明書の検証が
支配していて、バッファがどの RAM にあるかは効かない。速度を心配して
PSRAM を避ける理由は、少なくともここでは無かった。

### 逆に、内部 DRAM のままだと壊れ方が悪化する

比較のため内部 DRAM に戻して 4 本開いたら、エラーを返すのではなく
`rst:0xc` で**再起動した**（バックトレースは CORRUPTED）。
2 本のときの「1 本目が巻き添え」より明確に悪い。
**上限の設定を間違えたときの壊れ方まで見ておかないと、どれくらい
安全側に倒すべきかが決められない。**

### 見積もりを実機に否定させる場所を先に決めておいた

着手前の計画に「RAM と同時本数 — ここが唯一の未知数」という節を作り、
sdkconfig は先回りで触らない・実機で 1 本と 2 本を試す・駄目なら
`TLS_MAX` を 1 に下げると書いておいた。**降りる先を先に書いてあったので、
実機が否定したときに設計を作り直さずに済んだ。**

人間には「2 本」を選んでもらっていたが、根拠にした見積もりのほうが外れた
ので 1 に変えた。**選択そのものではなく、選択の前提が崩れた場合だった。**

### 一番間違えやすい 1 行を、数で確かめた

TLS で怖いのは `recv` の戻り値の写し方で、取り違えると「永久に回る」か
「本文が途中で切れる」になる。しかも**どちらも実機では成功に見えることがある**。

- esp-tls が `0` を返す = 相手が閉じた → `CDK_SOCK_CLOSED`
- `WANT_READ` / `WANT_WRITE` = まだ来ていない → `0`

もう 1 つ、ハンドシェイクは非ブロッキングで刻むので、**終わった後に下の
ソケットをブロッキングへ戻して `SO_RCVTIMEO` を 200ms に戻す**必要がある。
戻し忘れても動いてしまう（`recv` が即 0 を返し、ゲストが空回りするだけ）。

そこで「3 秒間、何も送らずに `sock_recv` を回して呼び出し回数を数える」
アプリを書いた。結果は **3001ms で 15 回**＝ちょうど 200ms 刻み。
戻し忘れていれば数千回になる。**目で見て正しそうなものを、数で確かめた。**

### 全体に効くフラグを入れるときに調べたこと

「検証を切る手段も欲しい」と言われて実装に入る前に ESP-IDF の中を読んだら、
`skip_common_name` はホスト名の照合を止めるだけで連鎖の検証は止めず、
CA を何も指定しない設定は「検証を飛ばす」のではなく**setup ごと失敗する**
と分かった（`esp_tls_mbedtls.c`）。検証を切るには `sdkconfig` で
`CONFIG_ESP_TLS_INSECURE` を立てるしかない。

これは**プロジェクト全体の既定を変えるフラグ**で、頼まれた内容とは
コストが違う。人間に戻して選び直してもらった上で入れた。
影響が限られる理由（`CDK_SOCK_TLS` は常に CA を渡すのでこの既定に落ちない、
SSH は libssh2 が mbedtls を直接使うので esp-tls を通らない）は推論なので、
**SSH で実際にログインするところまで実機で確かめた。**

### 数字

- 実機書き込み 8 回、実機ビルド 9 回、ホストビルド 4 回
- 不具合 0 件（実装中に見つけた設計の誤り 1 件 = TLS 2 本同時。
  コミット前に実機で潰したので不具合には数えない）
- ホストのテスト 5 ケース追加（型の検査のみ。`port_sock.c` はホストビルドに
  入らないので TLS 本体の自動テストは 0）
- 実機確認用のアプリを 3 本書いた（`tls2` 本数の上限と接続時間 /
  `tlsidle` recv の刻み / `tlstrap` 落ちた後の後始末）
- フラッシュ 1,527,728 → 1,663,984 バイト（+136,256 = 約 133KB。証明書バンドルと
  esp-tls が実際にリンクされた分）
- カメラ 0 回、スクリーンショット 9 枚

---

## シリアル端末 `uart` で分かったこと（2026-09-12）

**「実装より先に決めろ」と書いてあった設計メモが、そのまま効いた。**

`uart monitor` は M3 の「見送ったもの」で保留されていて、理由と一緒に
**先に決めるべき 2 点**（抜けるキー / 抜けるキー自体を相手に送る手段）が
書かれていた。今回はその 2 点を決めるだけで設計が済んだ。
保留の理由まで書き残してあると、再開のときに調査が要らない。

### 実装前に気づけたこと

- **`uart` という名前も設計済みだった。** 最初は `serial` で始めようとしたが、
  DESIGN.md §10 に `uart open/send/monitor` として載っていて、未実装リストにも
  `uart` と書いてあった。名前を変えると文書が二重になる。
- **基板は最初から対応していた。** D-sub の SP3232EEN はドライバ 2・
  レシーバ 2 で TX/RX/RTS/CTS がちょうど載り、`cdk_board.h` に 4 本とも
  定義済み。`tools/check_board_pins.py` の突き合わせ表にも入っていたので、
  ピン表の変更は 1 行も要らなかった。
- **ポート層は半分できていた。** `cdk_uart_open` は在ったが wasm 専用の
  貸し出し口で、フロー制御は決め打ちで無効。引数を 3 つ増やして、
  唯一の呼び出し元（wasm backend）に `false, -1, -1` を渡させるだけで済んだ。
  **ゲスト ABI は変えていない**ので、C / Rust の SDK を照合する
  `abi_names_match` は触らずに緑のまま。

### 実装中に見つけた 3 件（実機に繋ぐ前）

いずれもビルドとホストテストでは出ない。**セッションの前例（SSH / scp）と
突き合わせて読んだときに出てきた。**

| # | 何が起きるか |
|---|---|
| 1 | **かなモードだと `Ctrl-] q` で抜けられない。** `route_key` は SKK が先で、ひらがなモードの SKK は素の `q` を食う（カタカナ切り替え）。前置キーの判定だけを SKK の前に出した。画面を占有したまま抜けられなくなる形なので、実機で踏むと電源を切るしかない |
| 2 | **`uart_write_bytes` がメインループを永久に止める。** TX リングが埋まると `portMAX_DELAY` で待つ。フロー有効で相手の CTS が下がったままだと捌けない。wasm から呼んでいた頃はアプリのタスクが止まるだけだったが、書く主体がメインループになったので画面・キー・制御チャネルが揃って死ぬ。`uart_get_tx_buffer_free_size` で入る分を確かめて、入らなければ捨てる形にした |
| 3 | **応答を返す口で `term_printf` を呼ぶと端末パーサが再入する。** `on_term_reply` は `cdk_term_feed` の途中（エスケープ列を解いている最中）から呼ばれる。詰まりの通知がまた `cdk_term_feed` を呼ぶので壊れる。ここだけ `cdk_uart_write` を直に呼ぶ |

2 は「同じコードでも呼ぶ場所が変わると危険度が変わる」例。
`cdk_uart_write` 自体は前から在って、wasm では問題になっていなかった。

### 直した思い込み 2 件

- **詰まりの通知を毎回出すと画面が埋まる。** `route_bytes` は 1 バイトずつ
  送っていたので、500 バイトの貼り付けが弾かれると 500 行出る。
  「詰まりを見せる」ための表示で本文が流れて消えるのは本末転倒なので、
  詰まりに入った 1 回だけ出すようにし、0x1D までをまとめて送る形にした。
- **`cdk.py key ctrl+]` は `route_bytes` を通らない。** scp のコメントを
  真似て「忘れると `cdk.py key ctrl+]` が効かない」と書いたが、
  `key` は MSG_KEY で `route_key` に来る。`route_bytes` に来るのは
  `cdk.py type`（MSG_TEXT）。**コメントの主張を確かめてから書き直した。**

### 数字

- ホスト単体試験 27/27。`uart` の引数 5 件と帯 3 件を追加
- v1 / CoreS3 の両方でビルド。CoreS3 は `CDK_BOARD_HAS_EXT_UART 0` で
  セッションごと落ちる（`CDK_BOARD_EXT_UART_*` が定義されていないため、
  囲み忘れるとビルドで分かる）
- **実機 v1 で確認（書き込み 1 回）。** カメラ 0 回、スクリーンショット 15 枚

### 実機で確かめた（2026-09-12）

**作業の途中で人間からポート番号を知らされて実機が繋がった**
（COM75 = 制御、COM81 = ログ・書き込み。`cdk.py` の既定は COM76 なので
`CDK_LOG` で振り替えた）。それまでは未検証で出す前提で書いていたので、ここは追記。

**実装中に見つけた 3 件のうち、2 番（メインループが止まる）が一番効いた。**
`uart 9600 --flow` に 2000 バイト流すという、対策前なら機械ごと固まって
いたはずの操作で、**`ping OK` が返り、警告が 1 行出るだけ**で済んだ。
画面・キー・制御チャネルが生きたままなのをその場で確かめられた。

1 番（かなモードで抜けられない）も実機で確認した。帯を `あ` にしてから
`Ctrl-] q` を送って戻れている。**これは自動テストでは出せない**
（SKK と `route_key` の順序は実機のキー入力経路でしか通らない）。

ほかに確かめたもの: 0x1D + `q` での離脱（`route_bytes` 側）、`Ctrl-C` が
抜けずに相手へ通ること、開き直しが何度でもできること（`cdk_uart_close`）、
詰まりの通知が再入場でまた出ること、引数の拒否、`selftest` の回帰なし。

### 折り返しで確かめた（2026-09-12・人間が配線）

**人間が D-sub の先で TXD↔RXD と RTS↔CTS を折り返してくれた。**
これで残っていた 3 つのうち 2 つが閉じた。

**フロー制御が効いていることを、対照実験の形で示せた。**
配線前は CTS が浮いていて、`uart 9600 --flow` に流すと送信が詰まった。
配線後は**同じコマンド・同じ速度で普通に流れる**。変えたのは配線だけなので、
**CTS 入力が RTS で実際に駆動されている**ことがこれで言える。
単独の成功では言えなかったことが、前の失敗と並べて初めて言えた。

- echo: 打った字がそのまま戻る。ローカルエコーが無いので、
  画面に出ている物は往復してきたデータそのもの
- 取りこぼし: 9600 `--flow` で 320 バイト、230400 `--flow` で 960 バイト。
  番号付き 30 行が順番どおりで、欠けも化けも無し
- 対照: 230400 フロー無しでも完走し、帯から `F` が消える
  （無効時は G21/G38 を掴まないという実装どおり）

**詰まりの通知が「速度が追いつかない」側でも出ることを確認した。**
9600 に 2000 バイト（送信リングは 1KB）で出る。折り返しが繋がっていて
CTS は満たされているので、**これは CTS とは無関係の詰まり**。
通知の文言で原因を断定しなかったのは正しかった。

### 通せなかったもの

- **RTS の絞り込み**（混んだときに RTS を下げて相手を止めること）。
  SP3232 の定格（〜235kbps）では ESP32 の受信が余裕で追いつき、
  RX FIFO が閾値 122 を超えない。折り返しでは相手も自分なので、
  送る側を待たせる状況そのものが作れない。**確かめたのは
  「RTS が出ていて CTS がそれを受けている」ことまで。**
- **wasm が UART を掴んでいるときに `uart` が断ること**
  （`uartecho.wasm` が SD に無く、今回は流していない）

`i2c_probe` は実機を繋いだ途端に 4 件出た。今回そうならなかったのは、
**前例（SSH / scp のセッション）と突き合わせて先に 3 件見つけていた**分が
大きい。相手を繋ぐ段でまだ出る可能性は残っている。

## `wget` で分かったこと（2026-09-16）

**専用タスクを作りかけて、やめた。** 最初の案は「`esp_http_client_open` は
刻めないので HTTP 全体を別タスクで回す」だった。レビューで「接続を待つのは
scp の認証待ちと同じ前例で、決め手は本体を刻めるかだ」と指摘され、
IDF v5.5.5 のソースを読んで確かめた:

- `esp_http_client_read` は呼ぶたびに `client->timeout_ms` で select する
- `esp_http_client_set_timeout_ms` はフィールドを書くだけで、次の read から効く

なので「接続は待つ・本体はメインループが刻む」で scp と同じ形に収まり、
タスク間の状態の受け渡し（と、その排他・終了待ち）がまるごと要らなくなった。
**別タスク案のまま書いていたら、状態の文字列をタスクとメインループが
同時に触る競合を作り込んでいた。**

### 読んで見つけたもの（書く前）

- **長さの分からない応答は読めない。** `content_length` が -1 のとき
  `data_process < content_length` が偽になり、read が即 0 を返す。
  そのままだと 0 バイトのファイルが「受け取りました」で置かれる。ヘッダの段で断る
- **汲み切ったあとの read は期限いっぱい待つ。** 1 周 8 回読むと 80ms 止まるので、
  4KB 満杯で返らなかったらその周はやめる
- **リダイレクトは本文を読み捨ててから開き直す**（esp_https_ota の手順）

### レビューで見つかった 2 件（実機の前）

| # | 何が起きるか |
|---|---|
| 1 | **1 周でメインループが最大約 640ms 止まる。** 期限は `esp_http_client_read` 1 呼び出しではなく transport の read 1 回ごと。4KB を頼むと受信バッファ 512B 単位で最大 8 回待ち、それを 1 周 8 回。1 回に頼む量を 512B にし、30ms の時計を足した。**自分で「期限を短くすればその長さだけ」と書いたコメントが間違っていた** |
| 2 | **rename に失敗すると元も `.tmp` も消える。** 上書き指定では先に元を消しているのに、失敗の後片付けが `.tmp` も消していた。scp は「.tmp は残す」と約束していた |

どちらも読んだコード（read のループ、scp の約束）の中に答えがあって、
自分では読み流していた。

### 同じ罠をまた踏んだ（4 回目）

Python のヒアドキュメントで `cmd_wget` を書いたら、`\r\n` が本物の改行に、
`\033` が ESC の実体に潰れた（#13 / #14 / #45 と同じ）。**メモリに書いて
あったのに踏んだ。** ビルド前に `git diff` を見て気づき、Write ツールで
書いた断片を差し込み直した。出荷前なので不具合数には入れていない。

### 数字

- ホスト単体試験 27/27（`test_shell` 284 チェック。URL 判定・名前生成・連番の 3 ケースを追加）
- 実機ビルド 2 回（どちらも通過・警告なし。2 回目はレビュー指摘の修正後）。書き込み 0 回
- 2026-09-16 時点では実機が繋がっておらず、人間の指示で実機試験の手前で停止（翌日に確認。下記）

### 実機で確かめた（2026-09-17・v1）

機能はどれも一発で通った: http / https、多段リダイレクト（http → https →
raw.githubusercontent.com、Content-Length と一致）、404、`%` と `:` を含む名前、
連番、上書き、10MB / 4GB を途中で Ctrl-C（`.tmp` も本体も残らない）、引数の拒否。

**直したのは速さと応答で、3 件とも数字を出して初めて見えた。**
終了時のログに「周の数 / 回数切れ / 時間切れ / 最長 / 仕上げ」を足した。
`cdk.py ping` は PC 側の起動が約 450ms を占めるので、数十 ms の停止は
それでは見えない。

| # | 何が起きていたか | 見つけ方 |
|---|---|---|
| 1 | **1 周 8 回の予算で頭打ち**（国内ミラーで約 80KB/s、周の 7 割が回数切れ）。30ms の時間で切る形にして約 107KB/s | 実機の計測ログ |
| 2 | **SD へ 512B ずつ書いていた。** 書き込みのほうが遅く、周の 2 割が 30ms を超えていた。4KB 溜めて書く | 実機の計測ログ |
| 3 | **https で 1 周 200ms 止まる。** 期限は select にしかかからず、mbedtls が TLS レコード 1 つ分揃うまでブロッキングの recv で待つ。ヘッダ後にソケットを O_NONBLOCK にして最長 62ms・約 105KB/s。WANT_READ のたびに出るログは受け取り中だけ黙らせる | 実機の計測ログ ＋ IDF のソースを読んで原因を特定 |

3 は、実機に繋ぐ前に「TLS の読みは部分レコードで待つかもしれない」と
一度考えて、**「短いはず」で流していた**ものだった。

**残っている長い周は最後の 1 回だけ**（書き残し・削除・rename で 97〜152ms）。
scp と同じで受け入れた。

### 通せなかったもの

- SSH を開いたまま / 再接続待ちの間の `wget`（TLS のメモリ）
- rename の失敗、SD の容量切れ、長さの分からない応答（試せる相手を用意していない）

### 数字（実機分）

- 実機ビルド 5 回・書き込み 6 回（計測を入れて 3 回詰めた分を含む）。すべて成功
- スクリーンショット約 15 枚、カメラ 0 回

## `scp` の上限撤廃で分かったこと（2026-09-17）

人間の指定は「512KB の上限を外し、大きすぎるときは `wget` と同じ挙動に」。
上限の 2 行を消すだけの変更に見えたが、**消すと 32 ビットの壁が表に出た。**

- **この機械の `off_t` は 32 ビット。** libssh2 は相手の申告を 64 ビットで
  読むのに、`st_size` に詰めるところで上が落ちる。4GB+1KB は 1024 バイトとして
  届き、**黙って 1KB だけ受け取って「受け取りました」になる。**
  **これは上限があった頃からの不具合**だった（切られた後の値が 512KB 未満なら
  上限の確認も通る）。上限を外す作業で型を追って初めて気づいた
- **進捗の百分率が 43MB で溢れる**（`done * 100` が 32 ビット）。これも上限が
  隠していた

libssh2 の内部には手を入れず、申告どおり読み終えたあとに **scp の終端 NUL と、
その後 300ms 何も来ないこと**を確かめて 4GB 超を見分けた。NUL だけ見る案は、
疎なファイルでは中身の 0 バイトがすり抜けるので足りない。

### 実機で確かめた（v1・相手の VPS）

**相手のディスクが満杯だった**（`/` が 25G/25G。テスト用ユーザーのホームには
大きなものは無く、他人の領域なので触っていない）。`truncate` の疎なファイルは
ブロックを食わないので、それで組んだ。

- 1MB 受信（旧上限超え）: 41 秒・約 25KB/s で完走
- 4GB+1KB 受信: 1024 バイト読んだところで「大きすぎます (4GB 超)」、`.tmp` 無し
- 3GB 受信: 合計が正しく出て（負にならない）、Ctrl-C で止まり `.tmp` 無し
- 1MB 送信: 全部送れて、相手の「No space left on device」がそのまま出る

**送信の成功（512KB 超）は確かめていない**（相手に空きが無い）。
試験用のファイルは相手側から消した。

### 数字

- 実機ビルド 1 回・書き込み 1 回（どちらも成功）。ホスト試験 27/27
- 不具合数に 1 件足した（4GB 超の受信が黙って切られる。前からあったもの。
  AI が型を追って自力で発見）。百分率の溢れは上限を外して初めて起きるので数えない
