verylowfreq/cyd_kusabi/hardware/cdk_motherboard/cdk_motherboard_1.kicad_pcb

## KiCad design hardware/cdk_motherboard/cdk_motherboard_1.kicad_pcb (2026-10-30)

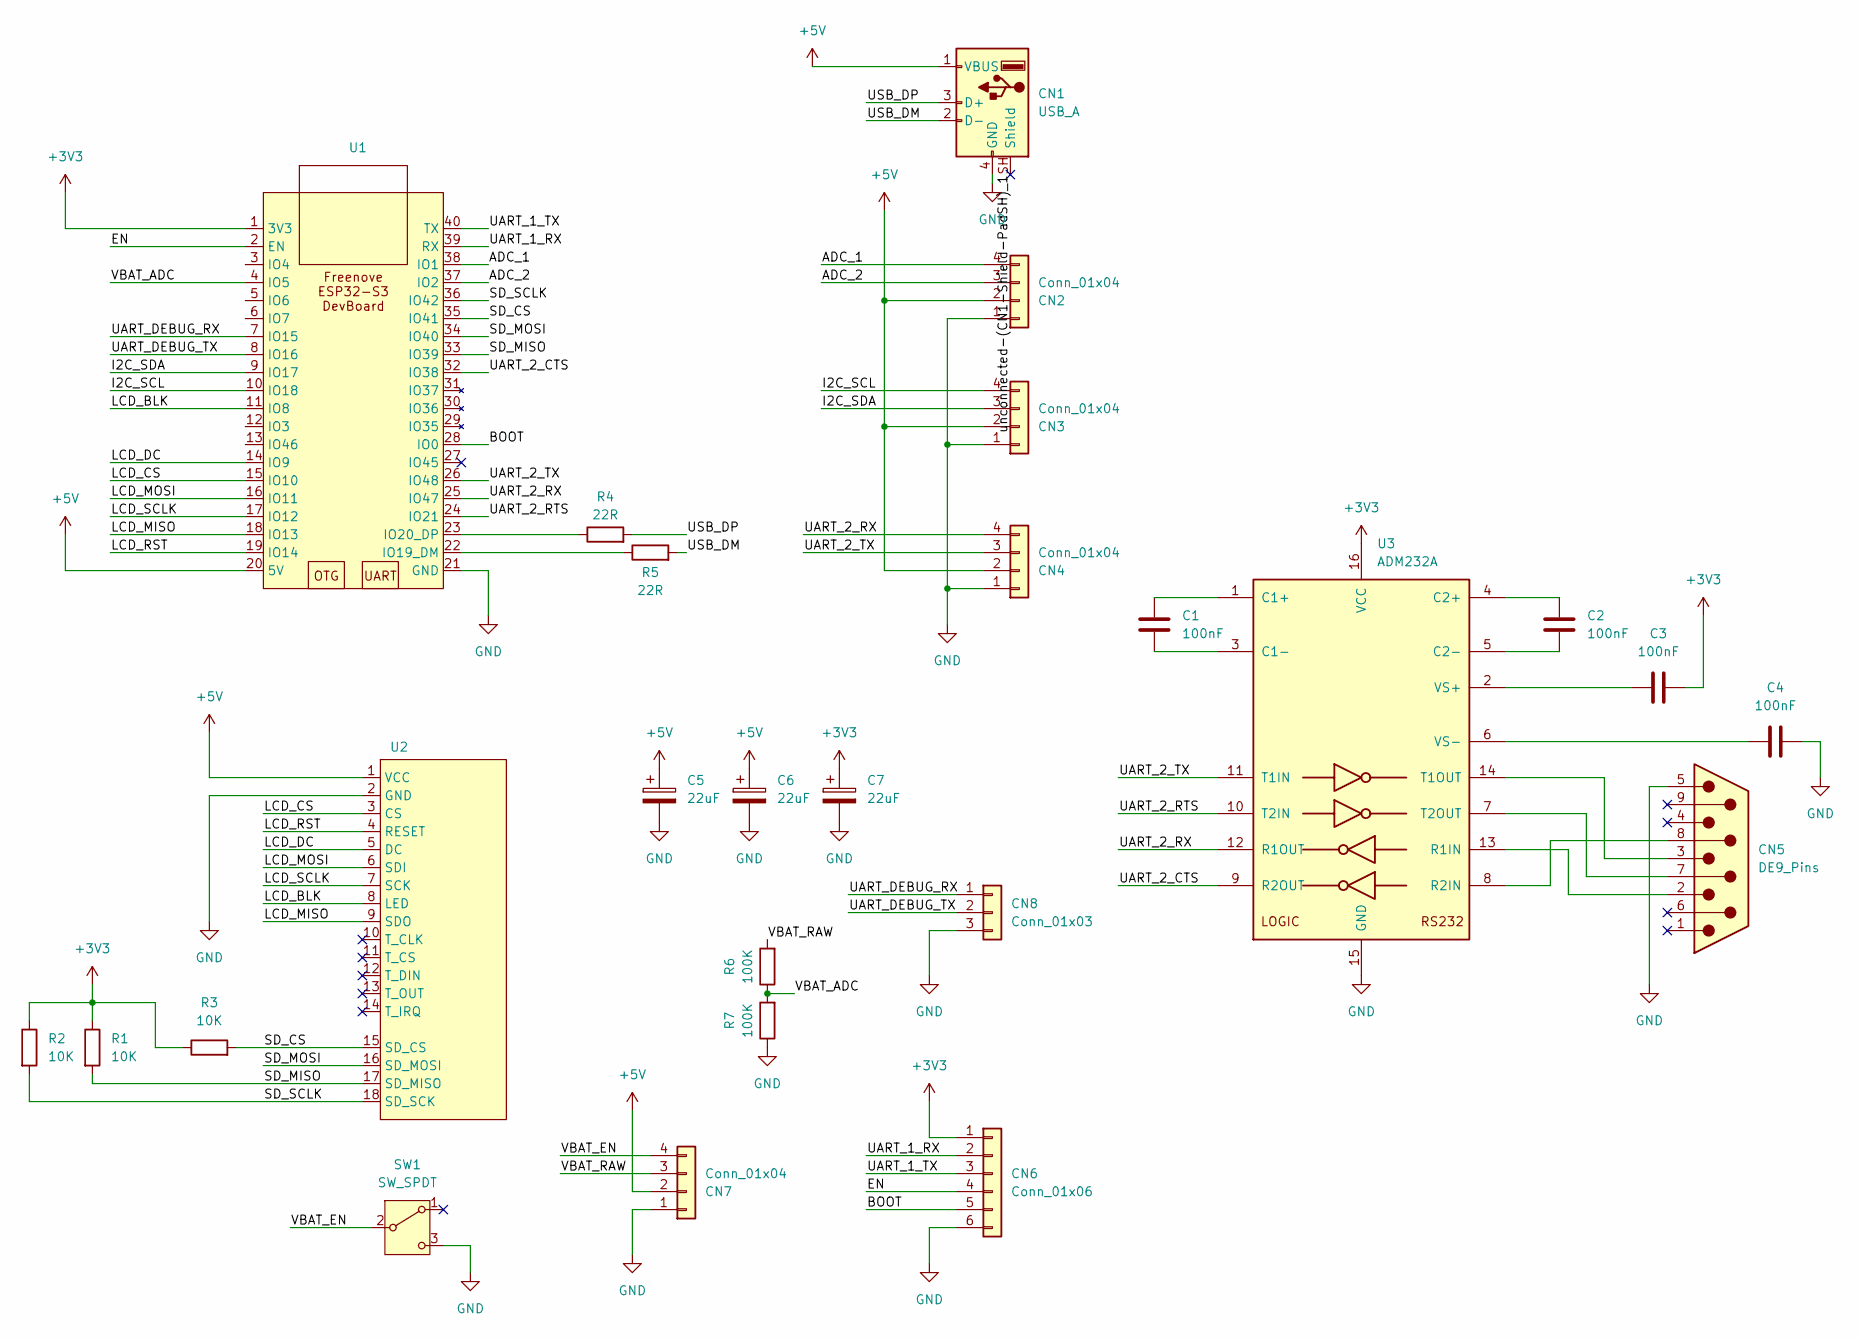
[picture p4: schematic cdk_motherboard_1.kicad_sch]

Parts:
C1, C2, C3, C4: 100nF; C_Disc_D3.0mm_W1.6mm_P2.50mm
C5, C6, C7: 22uF; CP_Radial_D5.0mm_P2.00mm
CN1: USB_A; USB Type-A Receptacle 5075AR-04-WH
CN2, CN3, CN4, CN7: Conn_01x04; JST_PH_B4B-PH-K_1x04_P2.00mm_Vertical
CN5: DE9_Pins; D-Sub 9pin Plug DMR-09PGG
CN6: Conn_01x06; PinSocket_1x06_P2.54mm_Vertical
CN8: Conn_01x03; PinSocket_1x03_P2.54mm_Vertical
R1, R2, R3: 10K; R_Axial_DIN0207_L6.3mm_D2.5mm_P7.62mm_Horizontal
R4, R5: 22R; R_Axial_DIN0207_L6.3mm_D2.5mm_P7.62mm_Horizontal
R6, R7: 100K; R_Axial_DIN0207_L6.3mm_D2.5mm_P7.62mm_Horizontal
SW1: SW_SPDT; Toggle Switch 2MS1-T1-B4-VS2-Q-E-S
U1: Freenove ESP32-S3 DevBoard
U2: LCD_480x320_4inch_SD
U3: ADM232A; DIP-16_W7.62mm

Connections:
+3V3: C3.2, C7.1, CN6.1, R1.1, R2.1, R3.1, U1.1 (3V3), U3.16 (VCC)
+5V: C5.1, C6.1, CN1.1 (VBUS), CN2.2, CN3.2, CN4.2, CN7.2, U1.20 (5V), U2.1 (VCC)
/ADC_1: CN2.4, U1.38 (IO1)
/ADC_2: CN2.3, U1.37 (IO2)
/BOOT: CN6.5, U1.28 (IO0)
/EN: CN6.4, U1.2 (EN)
/I2C_SCL: CN3.4, U1.10 (IO18)
/I2C_SDA: CN3.3, U1.9 (IO17)
/LCD_BLK: U1.11 (IO8), U2.8 (LED)
/LCD_CS: U1.15 (IO10), U2.3 (CS)
/LCD_DC: U1.14 (IO9), U2.5 (DC)
/LCD_MISO: U1.18 (IO13), U2.9 (SDO)
/LCD_MOSI: U1.16 (IO11), U2.6 (SDI)
/LCD_RST: U1.19 (IO14), U2.4 (RESET)
/LCD_SCLK: U1.17 (IO12), U2.7 (SCK)
/SD_CS: R3.2, U1.35 (IO41), U2.15 (SD_CS)
/SD_MISO: R1.2, U1.33 (IO39), U2.17 (SD_MISO)
/SD_MOSI: U1.34 (IO40), U2.16 (SD_MOSI)
/SD_SCLK: R2.2, U1.36 (IO42), U2.18 (SD_SCK)
/UART_1_RX: CN6.2, U1.39 (RX)
/UART_1_TX: CN6.3, U1.40 (TX)
/UART_2_CTS: U1.32 (IO38), U3.9 (R2OUT)
/UART_2_RTS: U1.24 (IO21), U3.10 (T2IN)
/UART_2_RX: CN4.4, U1.25 (IO47), U3.12 (R1OUT)
/UART_2_TX: CN4.3, U1.26 (IO48), U3.11 (T1IN)
/UART_DEBUG_RX: CN8.1, U1.7 (IO15)
/UART_DEBUG_TX: CN8.2, U1.8 (IO16)
/USB_DM: CN1.2 (D-), R5.2
/USB_DP: CN1.3 (D+), R4.2
/VBAT_ADC: R6.1, R7.2, U1.4 (IO5)
/VBAT_EN: CN7.4, SW1.2 (B)
/VBAT_RAW: CN7.3, R6.2
/unconnected-(CN1-Shield-PadSH)_1: CN1.SH (Shield)
/unconnected-(CN1-Shield-PadSH)_1_1: CN1.SH (Shield)
GND: C4.2, C5.2, C6.2, C7.2, CN1.4 (GND), CN2.1, CN3.1, CN4.1, CN5.5, CN6.6, CN7.1, CN8.3, R7.1, SW1.3 (C), U1.21 (GND), U2.2 (GND), U3.15 (GND)
unnamed: R5.1, U1.22 (IO19_DM)
unnamed: R4.1, U1.23 (IO20_DP)
unnamed: C1.1, U3.1 (C1+)
unnamed: C1.2, U3.3 (C1-)
unnamed: C2.1, U3.4 (C2+)
unnamed: C2.2, U3.5 (C2-)
unnamed: CN5.2, U3.13 (R1IN)
unnamed: CN5.8, U3.8 (R2IN)
unnamed: CN5.3, U3.14 (T1OUT)
unnamed: CN5.7, U3.7 (T2OUT)
unnamed: C3.1, U3.2 (VS+)
unnamed: C4.1, U3.6 (VS-)

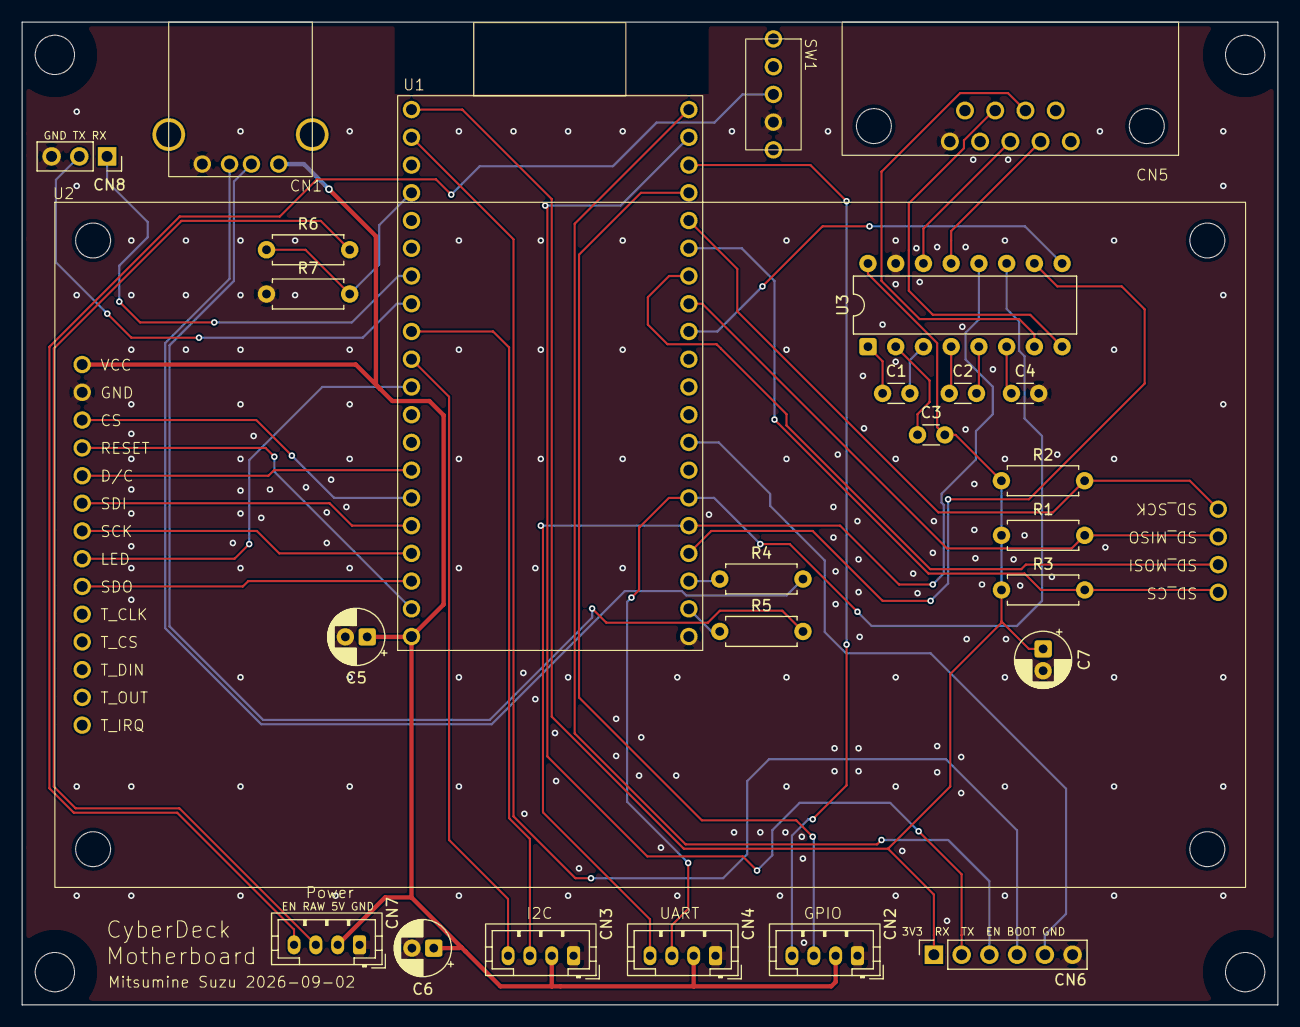
[picture p5: board cdk_motherboard_1.kicad_pcb from above]

Board: 2 copper layers, 115.0 x 90.0 mm, 26 parts (0 on the bottom side), 45 nets.
