verylowfreq/cyd_kusabi/cyberdeck_firmware/tools/mkfont.py

#!/usr/bin/env python3
"""mkfont.py — 東雲フォント BDF から cdk_font のバイナリブロブを作る。

  python tools/mkfont.py <shinonome-0.9.11/bdf> -o components/cdk_font/shinonome12.cdkfont

入力 (すべて Public Domain):
  shnm6x12a.bdf   ISO 8859-1        6x12  → U+0020..U+00FF
  shnm6x12r.bdf   JIS X 0201        6x12  → U+FF61..U+FF9F (半角カナ)
  shnmk12.bdf     JIS X 0208        12x12 → euc_jp 経由で Unicode へ

生成するもの (東雲に無く、CLI が多用するため自前で描く):
  U+2500..U+257F  罫線素片   ← JIS X 0208 にもあるが全角。端末は半角として
                                数える (East Asian Width = Ambiguous) ので、
                                6x12 の半角版が要る。無いと必ず桁がずれる。
  U+2580..U+259F  ブロック要素
  notdef          半角/全角それぞれの「げた」

出力フォーマット (すべてリトルエンディアン):
  0   char[4]  "CDKF"
  4   u16      version = 1
  6   u16      flags = 0
  8   u8       cell_w  (6)
  9   u8       cell_h  (12)
  10  u8       baseline (セル上端からの行数)
  11  u8       reserved
  12  u32      count
  16  u32      cp_off     -> u16 codepoints[count]  (昇順)
  20  u32      ent_off    -> u32 entries[count]
  24  u32      bits_off   -> ビットマップ本体
  28  u32      bits_len
  32  u32      notdef_half   ビットマップ内オフセット
  36  u32      notdef_wide
  40  ...      パディングして各セクション

  entries[i]: bit31 = 全角(2セル), bit0..30 = bits_off からのバイトオフセット
  半角グリフ: cell_h 行 x 1 バイト (MSB が左端、上位 cell_w ビットを使う)
  全角グリフ: cell_h 行 x 2 バイト

BMP 外の文字はグリフを持たない (幅だけ cdk_text が正しく数える)。
"""

from __future__ import annotations

import argparse
import re
import struct
import sys
from pathlib import Path

CELL_W = 6
CELL_H = 12
BASELINE = 10  # BBX の descent が 2 なので上端から 10 行目がベースライン

HALF_BYTES = CELL_H * 1
WIDE_BYTES = CELL_H * 2


# ----------------------------------------------------------------- BDF


def parse_bdf(path: Path) -> tuple[dict[int, list[int]], int, int]:
    """BDF を読み、{encoding: [行ごとのビット列]} と (幅, 高さ) を返す。

    行は int で表し、MSB が左端。幅 6 なら bit5..bit0 を使う。
    """
    glyphs: dict[int, list[int]] = {}
    fbb_w = fbb_h = 0
    enc = None
    bbx = None
    rows: list[int] | None = None

    with path.open("r", encoding="latin-1") as f:
        for line in f:
            line = line.rstrip("\r\n")
            if line.startswith("FONTBOUNDINGBOX"):
                p = line.split()
                fbb_w, fbb_h = int(p[1]), int(p[2])
            elif line.startswith("ENCODING"):
                enc = int(line.split()[1])
            elif line.startswith("BBX"):
                p = line.split()
                bbx = (int(p[1]), int(p[2]), int(p[3]), int(p[4]))
            elif line == "BITMAP":
                rows = []
            elif line == "ENDCHAR":
                if enc is not None and enc >= 0 and rows is not None and bbx is not None:
                    glyphs[enc] = normalize(rows, bbx, fbb_w, fbb_h)
                enc, bbx, rows = None, None, None
            elif rows is not None:
                if line and all(c in "0123456789abcdefABCDEF" for c in line):
                    # BDF は 1 行を 8 ビット単位にパディングして 16 進で書く
                    nbits = len(line) * 4
                    rows.append((int(line, 16), nbits))

    return glyphs, fbb_w, fbb_h


def normalize(rows, bbx, fbb_w, fbb_h) -> list[int]:
    """BBX のオフセットを考慮して、幅 fbb_w x 高さ fbb_h の左詰めビット行にする。"""
    bw, bh, bx, by = bbx
    out = [0] * fbb_h

    # BDF の行は下から数えた y=by が最下行。FONTBOUNDINGBOX の descent は -2 固定。
    # ここでは fbb と bbx の descent が一致する前提で素直に上詰めする。
    top = fbb_h - bh - (by - (-2))
    for i, (val, nbits) in enumerate(rows):
        # val は nbits ビット幅で MSB 詰め。上位 bw ビットが実データ。
        bits = (val >> (nbits - bw)) & ((1 << bw) - 1) if nbits >= bw else val
        # fbb_w 幅の中で bx だけ右にずらして MSB 詰めにする
        shift = fbb_w - bw - bx
        if shift < 0:
            shift = 0
        y = top + i
        if 0 <= y < fbb_h:
            out[y] = (bits << shift) & ((1 << fbb_w) - 1)
    return out


# --------------------------------------------------- 罫線素片の自前生成

NONE, LIGHT, HEAVY, DOUBLE = 0, 1, 2, 3

V_COLS = {LIGHT: [2], HEAVY: [2, 3], DOUBLE: [1, 3]}
H_ROWS = {LIGHT: [5], HEAVY: [5, 6], DOUBLE: [4, 6]}

# U+2500..U+256C を (up, right, down, left) の太さで表す。
# 破線 (2504-250B, 254C-254F) は実線で近似する。
BOX = {
    0x2500: (0, 1, 0, 1), 0x2501: (0, 2, 0, 2),
    0x2502: (1, 0, 1, 0), 0x2503: (2, 0, 2, 0),
    0x2504: (0, 1, 0, 1), 0x2505: (0, 2, 0, 2),
    0x2506: (1, 0, 1, 0), 0x2507: (2, 0, 2, 0),
    0x2508: (0, 1, 0, 1), 0x2509: (0, 2, 0, 2),
    0x250A: (1, 0, 1, 0), 0x250B: (2, 0, 2, 0),
    0x250C: (0, 1, 1, 0), 0x250D: (0, 2, 1, 0),
    0x250E: (0, 1, 2, 0), 0x250F: (0, 2, 2, 0),
    0x2510: (0, 0, 1, 1), 0x2511: (0, 0, 1, 2),
    0x2512: (0, 0, 2, 1), 0x2513: (0, 0, 2, 2),
    0x2514: (1, 1, 0, 0), 0x2515: (1, 2, 0, 0),
    0x2516: (2, 1, 0, 0), 0x2517: (2, 2, 0, 0),
    0x2518: (1, 0, 0, 1), 0x2519: (1, 0, 0, 2),
    0x251A: (2, 0, 0, 1), 0x251B: (2, 0, 0, 2),
    0x251C: (1, 1, 1, 0), 0x251D: (1, 2, 1, 0),
    0x251E: (2, 1, 1, 0), 0x251F: (1, 1, 2, 0),
    0x2520: (2, 1, 2, 0), 0x2521: (2, 2, 1, 0),
    0x2522: (1, 2, 2, 0), 0x2523: (2, 2, 2, 0),
    0x2524: (1, 0, 1, 1), 0x2525: (1, 0, 1, 2),
    0x2526: (2, 0, 1, 1), 0x2527: (1, 0, 2, 1),
    0x2528: (2, 0, 2, 1), 0x2529: (2, 0, 1, 2),
    0x252A: (1, 0, 2, 2), 0x252B: (2, 0, 2, 2),
    0x252C: (0, 1, 1, 1), 0x252D: (0, 1, 1, 2),
    0x252E: (0, 2, 1, 1), 0x252F: (0, 2, 1, 2),
    0x2530: (0, 1, 2, 1), 0x2531: (0, 1, 2, 2),
    0x2532: (0, 2, 2, 1), 0x2533: (0, 2, 2, 2),
    0x2534: (1, 1, 0, 1), 0x2535: (1, 1, 0, 2),
    0x2536: (1, 2, 0, 1), 0x2537: (1, 2, 0, 2),
    0x2538: (2, 1, 0, 1), 0x2539: (2, 1, 0, 2),
    0x253A: (2, 2, 0, 1), 0x253B: (2, 2, 0, 2),
    0x253C: (1, 1, 1, 1), 0x253D: (1, 1, 1, 2),
    0x253E: (1, 2, 1, 1), 0x253F: (1, 2, 1, 2),
    0x2540: (2, 1, 1, 1), 0x2541: (1, 1, 2, 1),
    0x2542: (2, 1, 2, 1), 0x2543: (2, 1, 1, 2),
    0x2544: (2, 2, 1, 1), 0x2545: (1, 1, 2, 2),
    0x2546: (1, 2, 2, 1), 0x2547: (2, 2, 1, 2),
    0x2548: (1, 2, 2, 2), 0x2549: (2, 1, 2, 2),
    0x254A: (2, 2, 2, 1), 0x254B: (2, 2, 2, 2),
    0x254C: (0, 1, 0, 1), 0x254D: (0, 2, 0, 2),
    0x254E: (1, 0, 1, 0), 0x254F: (2, 0, 2, 0),
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
    # 角丸は 6x12 では丸めようがないので普通の角で近似する
    0x256D: (0, 1, 1, 0), 0x256E: (0, 0, 1, 1),
    0x256F: (1, 0, 0, 1), 0x2570: (1, 1, 0, 0),
    # 端だけ伸びるもの
    0x2574: (0, 0, 0, 1), 0x2575: (1, 0, 0, 0),
    0x2576: (0, 1, 0, 0), 0x2577: (0, 0, 1, 0),
    0x2578: (0, 0, 0, 2), 0x2579: (2, 0, 0, 0),
    0x257A: (0, 2, 0, 0), 0x257B: (0, 0, 2, 0),
    0x257C: (0, 2, 0, 1), 0x257D: (1, 0, 2, 0),
    0x257E: (0, 1, 0, 2), 0x257F: (2, 0, 1, 0),
}


def draw_box(up: int, right: int, down: int, left: int) -> list[int]:
    px = [[0] * CELL_W for _ in range(CELL_H)]

    v_weight = max(up, down) or LIGHT
    h_weight = max(left, right) or LIGHT
    mid_cols = V_COLS[v_weight]
    mid_rows = H_ROWS[h_weight]
    c_lo, c_hi = min(mid_cols), max(mid_cols)
    r_lo, r_hi = min(mid_rows), max(mid_rows)

    def vline(w: int, y0: int, y1: int) -> None:
        for c in V_COLS[w]:
            for y in range(y0, y1 + 1):
                px[y][c] = 1

    def hline(w: int, x0: int, x1: int) -> None:
        for r in H_ROWS[w]:
            for x in range(x0, x1 + 1):
                px[r][x] = 1

    if up:
        vline(up, 0, r_hi)
    if down:
        vline(down, r_lo, CELL_H - 1)
    if left:
        hline(left, 0, c_hi)
    if right:
        hline(right, c_lo, CELL_W - 1)

    return pack(px)
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
