verylowfreq/cyd_kusabi/(commit log)

2026-08-27 M0: ビルド基盤・ホスト側テスト土台・表示・スクショ転送
    ESP-IDF v5.5.5 / ESP32-S3。試作機は M5Stack CoreS3。
    - components/ は ESP-IDF に依存しない純 C コア、components_port/ が
    ESP-IDF 依存のポート層。この境界は no_idf_in_core テストで機械的に守る。
    - cdk_proto: ホスト↔デバイスのフレーミング。CRC が合わなければ 1 バイト
    捨てて magic を探し直す再同期方式。ログやパニック出力の割り込みから復帰する。
    - cdk_canvas: RGB565 キャンバスとダーティ行管理。画面の内容はここが唯一の真実で、
    液晶からは読み戻さない（SPI パネルの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
    [partitions.csv]
2026-08-27 M1: VT パーサ・東雲フォント・テキストコンソール
    試作機 CoreS3 で 53桁 x 20行、最終ハード 480x320 で 80桁 x 26行。
    - cdk_text: UTF-8 ストリームデコーダ + East Asian Width。
    グリフの有無と幅計算を完全に切り離す。端末では「表示できないこと」より
    「桁がずれること」の方が致命的なため。
    - cdk_font + tools/mkfont.py: 東雲 12px (Public Domain) から 207KB の
    ブロブを生成してフラッシュに焼き込む。SD もファイルシステムも要らない。
    罫線素片 128 字・ブロック要素 32 字・CLI が使う記号 43 字は 6x12 の半角で
    自前生成する。東雲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
2026-08-27 テスト用の認証情報を ABOUT.md から .env へ移す
    ABOUT.md には環境変数名だけを残し、実際の値は gitignore した .env に置く。
    過去のコミットに残っている値はこの後 filter-repo で除去する。
2026-08-27 M2: SSH ライブラリを libssh2 に決定し、実機で初期化まで確認
    DESIGN.md では wolfSSH を第一候補にしていたが、調べた結果クライアント側の
    PTY が使えないことが分かったので覆した。PTY は「CLI が動く」という目標に
    対して譲れないため。
    wolfSSH を採らなかった理由:
    - PTY 要求 SendChannelTerminalRequest() が
    #if defined(WOLFSSH_TERM) && !defined(NO_FILESYSTEM) の中にあり、
    ベンダー純正の ESP32 用 user_settings.h が NO_FILESYSTEM を定義しているため
    既定ではコンパイル対象から外れる。
    - 上書き手段は wolfSSL の user_settings.h をプロジェクト側で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
2026-08-27 開発統計を DEV_STATS.md に集計し、機械的な数字は自動計上する
    ユーザー依頼: DEV_STATS.md に数字を入れ、今後も継続的に更新する。
    - dev-stats-hook.py: Claude Code の PostToolUse / PostToolUseFailure フックから
    呼ばれ、Bash/PowerShell のコマンドを分類してビルド・書き込み・テスト・
    カメラ撮影の回数を .dev-stats.json に貯める。テストとビルドの成否は
    出力から読む（grep のパイプで exit code が潰れるため当てにしない）。
    統計のために開発を止めないよう、何があっても exit 0 で終わる。
    - .claude/settings.json: 上記フックの登録。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
2026-08-27 M2: WiFi + PTY 付き SSH。実機で top が動く
    完了条件を満たした。実機からログインして top が 53x20 で正しく描画される。
    COLS=53 LINES=20 TERM=xterm-256color
    - port_net: WiFi STA。接続待ちの間だけリトライし、確立後の切断は繋ぎ直す。
    認証情報を NVS に残さないよう WIFI_STORAGE_RAM にしてある。
    - port_ssh: libssh2 でハンドシェイク → 認証 → PTY → シェル。
    PTY のサイズは cdk_term の実値を渡す。最終ハードの 80x26 を決め打ちすると
    試作機(53x20)で表示が崩れるため。
    ハンドシェイクと認証はブロッキング、以降はノンブロッキ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
2026-08-27 M3: 行編集つきシェル + GPIO / ADC / I2C、認証情報を NVS へ
    完了条件を満たした。実機のシェルから ssh で入り、exit で戻ってこられる。
    - cdk_keys_decode: バイト列 → キーイベント。cdk_keys_encode の逆。
    往復（encode → decode）を 82 通りでテストしている。おかげでシェルは
    エスケープ列を一切見ない。USB キーボード(M7)は最初からキーイベントで
    来るので、この境界がそのまま使える。
    - cdk_shell: 行編集・履歴・タブ補完・引用符つき分割。純 C。
    - port_cfg: NVS。認証情報をファームウェアのバイナリから外した。
    起動時は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
2026-08-27 M4: microSD と known_hosts によるホスト鍵検証
    CoreS3 は LCD の DC と SD の MISO が同じ G35 なので、SPI3 の排他だけでは
    足りずピンの向きも切り替える必要がある。port_spibus が所有者ごとに
    向きを変え、再帰ミューテックスで直列化する。SD アクセス直後のパネルは
    カメラで確認した。shot はキャンバスのダンプなので転送の破壊は写らない。
    ホスト鍵は /sdcard/ssh/known_hosts に TOFU で記録する。不一致のときは
    警告ではなく接続を断る。断らないなら検証している意味がないため。
    逆に SD が無いだけで繋げないのは端末として使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
2026-08-27 M5a: ローマ字かな変換（純 C）
    SKK の入力系の土台。入力した ASCII 1 文字ごとに 0 個以上の かな を返す
    状態機械で、状態は「まだ かな にならない未確定のローマ字」だけ。
    促音は表に直接書く（"kk" → っ + 打ち直し "k"）。規則で書こうとすると
    「n は重ねても っ にならない」「ch は tch」といった例外が条件分岐で
    並ぶので、表のほうが読める。
    撥音だけは表で書けない。"nn" を単に ん と決め打つと konna が
    「こんあ」になる。2 つ目の n が「ん」なのか「な行の頭」なのかは
    その次の文字を見ないと決まらない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
2026-08-27 M5b: SKK 辞書のバイナリ形式・生成・読み出し
    SKK-JISYO.L は EUC-JP のテキストで 4.5MB（UTF-8 で 6.2MB）。実機で
    パースするのは現実的でないので、tools/skk_build.py が PC 側で
    「索引 + レコード」に組み替える。実機は索引を二分探索してレコードを
    読むだけで、RAM 使用量は辞書の大きさに依存しない。
    見出し語は UTF-8 バイト順に並べ直す。元の辞書は EUC-JP 順なので、
    そのまま使うと memcmp での二分探索が成立しない。
    送りあり / なしは別の索引にする。混ぜると「おくr」のような送りあり
    見出しが普通の見出しと並び、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
2026-08-27 M5c: SKK の変換状態機械（▽ / ▼）
    「キーイベント → 確定した文字列 + 画面に出る未確定部分」の関数として
    書いたので、ホストで全部テストできる。実機に載せる前に 74 チェック。
    SKK は「どこから漢字にするか」を人が指示する方式なので変換範囲の推定が
    要らず、状態機械が小さく収まる。
    ▽ 大文字で始める見出し入力
    ▼ 候補選択。Space で次、x で前、他の文字を打つと確定して打ち直す
    送り仮名は ▽ の途中でもう一度大文字を打って始める。辞書は
    「かな + 送りの頭の子音」で引く（KaeRu → "かえr"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
2026-08-27 M5d: SKK を実機に載せる（辞書 8MB パーティション + 未確定文字列の描画）
    skkdict パーティションを 4MB → 8MB にして SKK-JISYO.L 全体
    （バイナリ 6.86MB / 17.5 万件）をフラッシュに焼けるようにした。SD 上の
    ファイルは実機に挿さないと用意できないので、辞書をフラッシュに置けるか
    どうかは開発の回し方に直結する。nvs は factory より前なので位置が動かず、
    認証情報は残る（実機で確認）。
    `cdk.py dict` が辞書を作って焼く。書き込み先はビルド済みの
    パーティション表から引く。0x410000 を決め打ちにすると、partitions.csv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
    [partitions.csv]
2026-08-27 M5e: 個人辞書（確定時の学習）と M5 のドキュメント
    選んだ候補を次から先頭に出す。これが無いと、よく使う語でも毎回同じ回数
    Space を押すことになり、長い文章を書くのが苦痛になる。
    /sdcard/skk/user.dic に 1 行追記する。全体を書き直さないのは、書いている
    途中で電源が落ちたときに辞書ごと失うのを避けるため。同じ見出しの行が
    何度あってもよく、後の行が勝つ。
    SKK 本来の辞書形式は送りあり / なしをファイル内の区画で分けるので、
    追記だけでは育てられない。行ごとに種別を持つ独自形式にした。
    書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
2026-08-27 M5 の締め: 学習の切り詰めを検証し、検証を回す約束を書く
    **切り詰めが起きたときに選んだ候補が落ちないこと**を確かめた。実物の
    「かえr」は注釈つき 9 候補で、つなぐと個人辞書の受け皿 (192B) を超える。
    ここで先頭が落ちると、学習が効かないのはまさに候補の多い語＝いちばん
    学習してほしい語になる。落ちるのは後ろ側でなければならない。
    - ホスト: 12 候補を順に選び、毎回それが先頭に来ることを確認
    - 受け皿より長い候補そのものは捨てる（壊れた文字列を残さない）
    - 実機: 9 番目の候補を選んで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
2026-08-27 M6a: エディタの中身（純 C）
    microSD 上のプレーンテキストを編集する。出力は端末へのバイト列
    （cdk_shell と同じ）。エスケープ列を組んで cdk_term に流すので、
    描画・フォント・桁計算は既存の検証済みの経路をそのまま通る。
    画面を自前でセル単位に描くと、ホストの基準レンダラと比べられなくなる。
    本文は平たいバイト配列 + memmove。ギャップバッファは使わない。128KB の
    memmove は 1 打鍵あたりの処理として十分に速く、速さのために正しさを
    危うくする理由がない。
    日本語の文章を書くので折り返す（横スク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
2026-08-27 M6b: エディタを実機に載せる
    `edit <file>` で SD 上のテキストを日本語入力つきで編集する。
    代替画面 (ESC[?1049h) で開くので、抜けるとシェルの画面がそのまま戻る。
    保存は .tmp に書いてから rename する。元のファイルに直接書くと、途中で
    電源が落ちたり SD が抜けたりしたときに書きかけのものが元の場所に残る。
    FATFS の rename は上書きしないので先に remove する。
    route_key はシェル / SSH と同じ 1 か所のまま。SKK が消費しなかったキーだけが
    エディタへ落ちる。**Ctrl-J 以外の Ctrl 付きは SKK が食べない**ようにした。
    全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
2026-08-27 M6c: 折り返しでカーソルが動かなくなる不具合を潰す
    **折り返した行がちょうど右端まで埋まっていると、上下移動でカーソルが
    動かなくなっていた。** 「行の末尾」と「次の行の先頭」が同じオフセットに
    なるので、上へ動いたつもりが元の行へ戻ってきていた。実機では
    「エディタが固まった」としか見えない。画素を測っても分からない。
    offset_within が行の外へ出ないようにした。行が埋まっているときは
    最後の文字の先頭に留める。あわせて move_vert から「末尾に改行が無ければ
    行き過ぎ」という重複した判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
2026-08-27 M6 の締め: 境界の移動を固定し、M7 への引き継ぎを書く
    move_vert から重複した判断を消したときに、「最終行で Down しても動かない」
    ことを確かめていなかった。既存のテストは行番号でしか見ておらず、
    末尾に改行が無い行で Down が本文の末尾へ飛んでも気づけない
    （見た目は End を押したのと同じ）。オフセットで固定した。
    - 末尾に改行が無ければ最終行で Down しても動かない
    - 末尾が改行なら空の最終行へ行けて、その先へは行かない
    M7 で画面が 53x20 から 80x26 に変わるので、桁数・行数を持っている側の
    洗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
2026-08-27 HARDWARE_DESIGN.md にハードウェア仕様の検証結果を書き足す
    ESP-IDF v5.5.5 のソース・資料と TI の製品情報に突き合わせた。
    ピンの並びそのものは正確で、モジュールで使えないピン（octal PSRAM が食う
    GPIO35-37）もストラッピングピンも正しく除いてある。指摘が集中したのは
    「ピンの選び方」ではなく「その結果として何が使えなくなるか」。
    決めないといけないこと 4 件:
    - USB ホストを GPIO19/20 に置くと内蔵 USB PHY を USB-Serial-JTAG と
    取り合うので、cdk_proto の制御チャネルと USB 書き込みが両方消える
    - 外部 JTAG (GPIO39-42)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
2026-08-27 F-11/F-12: 空きピンの整理と基板の切り分け
    ハードウェアレビューの回答を反映した。決定 12 件を HARDWARE_DESIGN.md に
    記録し、残る未決を「液晶コントローラの型番」と「F-11 の付随信号」の 2 つに
    絞った。
    F-11 空きピン一覧:
    - 完全に自由なのは GPIO6 / 7 の 2 本だけ。どちらも ADC1 かつ RTC
    - 条件つきが 5 本（3 = JTAG 選択だが eFuse を焼かなければ効かない、
    13 = LCD MISO 未使用、21/38 = フロー制御を使わないなら、45/46 = 起動時 LOW 必須）
    - **RTC GPIO は GPIO0〜21 に限られ、空いているのは 6 と 7 だけ。**
    ディープスリープか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
2026-08-28 SKK 辞書を SKK-JISYO.L.unannotated に差し替える
    注釈（候補に付く説明文）が不要とのことなので、注釈なしの版に替えた。
    SKK-JISYO.L 送りあり 15,996 / 送りなし 159,795 6,857,578 バイト
    SKK-JISYO.L.unannotated 同じ 6,319,076 バイト
    **語彙は 1 語も減らない。**件数が完全に同じで、候補の説明文が無いだけ。
    538KB 小さくなり、8MB パーティションの余裕が 1.46MB → 2.0MB になる。
    8MB に広げた判断は変わらない（注釈を落としても 4MB には収まらない）。
    形式も cdk_skk_cand_at の注釈切り離しもそのまま残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
2026-08-28 v1 の表示ドライバ (ILI9488) を書く
    液晶コントローラが ILI9488 に決まったので、port_display の v1 側を実装した。
    これで HARDWARE_DESIGN.md の未決は F-11 の付随信号 1 件だけになった。
    **ILI9488 は SPI 接続では 16bit を受け付けない。** 18bit (RGB666) の 3 バイト
    しか通らない。全画面の転送量は 450KB（RGB565 なら 300KB の 1.5 倍）。
    帯単位で送るので全画面ぶんを持つ必要はなく、16 行ぶん 23KB の変換バッファを
    起動時に 1 回だけ確保する（DESIGN.md §14）。
    初期化列は atanisoft/esp_lcd_ili9488 に任せた。ベンダのレジスタ列を
    当てずっぽ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
2026-08-28 v1 の初火入れ: SPI ホスト番号の修正と UART 制御チャネル
    本番回路のブレッドボード試作機で初めてファームを動かした。
    起動・表示・WiFi・SKK 辞書まで通り、DESIGN.md §0 で決めた
    480x320 → 端末 80桁 x 26行 がそのまま出た。
    **SPI ホストの番号を 1 つ間違えていた。** spi_host_device_t は
    SPI1_HOST=0 / SPI2_HOST=1 / SPI3_HOST=2 で、周辺機能の名前の数字と
    1 つずれる。「SPI2 だから 2」と書いていた。
    - SD は 3 が範囲外で invalid host_id。起動時に落ちるので気づけた
    - **LCD は 2 が SPI3 に載る。初期化も表示も通ってしまう。**
    IO_MUX 直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
    [cdk.py, cdk_board.h, port_display.c, port_link.c, port_storage.c]
2026-08-28 v1 で selftest が完走。ポートの役割を基板ごとに解決する
    SD の配線修正と FT232 の接続で、最終ハードの検証経路が全部つながった。
    - selftest が完走。**480x320 = 307,200 バイトがホストの基準画像と完全一致**
    - SKK: Ctrl-J → Nihon → Space → ▼日本（画素で桁も確認）
    - エディタ: 日本語を書いて Ctrl-S → SD に 53 バイト保存、cat で読み戻し
    - SD: SL16G 認識、user.dic の学習 3 件も読める
    - 空きヒープ internal 108KB / PSRAM 7.77MB
    **cdk.py boot が動かなかったのはツールの前提の問題だった。**
    リセット線が乗っている口が基板で違うのに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
    [cdk.py]
2026-08-28 DEV_STATS: 「実機で見つかった」と「実機でしか出ない」を分ける
    初火入れの節に「33 件のうち実機でしか出なかったのは 5 件」と書いたが、
    表の発見方法の欄からは確かめられない数だった。欄が示すのは
    「どこで見つけたか」であって「どこでしか出ないか」ではない。
    番号を挙げて 2 つを分けた。実機で見つかったのは 11 件、そのうち
    実機でしか出ないのは 5 件。差の 6 件は純粋な C の側にあり、
    ホストで捕まえられたのに実機で先に踏んだもの。
    前者を「実機が要る証拠」として数えると、自分のテストの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
2026-08-28 SPI ホストの取り違えをビルドで止める
    不具合 #34 の直しはコメントだけで、同じ間違いが再発しても何も落ちなかった。
    `check_board_pins.py` はピン番号の食い違いを見るが、#34 は番号ではなく
    **ホスト**の取り違えなので、守る対象が違って引っかからない。
    `soc/spi_pins.h` が IO_MUX のピン番号を持っているので、
    HARDWARE_DESIGN.md の「LCD は SPI2 の IO_MUX 直結だから速い」という主張を
    そのまま静的アサートにできる。ホストを変えても、LCD の 4 本を IO_MUX から
    外しても、そこでビルドが止まる。SD 側は範囲外とバス共有も見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
2026-08-28 パネルに合わせる: 上端 1 画素ずらし + 地の文を純白に
    実機の指摘 2 件。どちらも実機を見ないと分からない性質のもの。
    **1) 上端 1 行が見えない。** キャンバスの行 y をパネルの行 y+1 に出す。
    ずらした分、キャンバス下端の 1 行はパネルの外に出るので送らない。
    落とした行だけがダーティだったときは、そこでダーティを消してから帰る
    （消し忘れると永久にダーティのままで、以降の flush が毎回空回りする）。
    キャンバスは 480x320 のまま。ずれはパネルの性質であって描く内容の性質では
    ないし、shot --verif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
2026-08-28 パネルのガンマ補正を入れ、実行時に追い込めるようにする
    「少し暗いだけの色がぜんぜん読めない」という指摘。原因は 2 つ重なっていた。
    xterm の通常色は 0xCD = 80% しかなく、バナーの緑 (ESC[32m = 0x00CD00) は
    1 チャネルだけなので条件が最悪。そこにパネル自身の沈みが乗る。
    0 と最大値を固定したまま中間だけ持ち上げる。v1 の既定はガンマ 2.2。
    **パレットではなくセルの色に最後に掛ける。** dim や反転を済ませてから
    補正しないと「補正後の値の半分」になり、dim が沈みすぎる。ホストテストで
    その順序を固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
2026-08-28 DEV_STATS: 測れないと分かるまでの 3 回の失敗を記録
    ガンマ値をカメラで決めようとして 3 通り試し、全部失敗した。
    視野角・露出・飽和と、失敗の理由が毎回違う。
    引き際の話として書いた。上端 1 画素ずらしは A/B の差を見ていたので
    測れたが、今回は絶対値が要る。同じカメラでも測れるものと測れないものが
    あり、1 回目で気づけたはずのところを 14 枚撮ってから諦めている。
    #38（起動時に NVS を開いていなかった）と、7 度目のヒアドキュメント
    （今回はツール呼び出しの JSON 層で 1 段落ちた）も追加。
    Co-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
2026-08-28 DEV_STATS: 表の途中に入った空行と日付を直す
    38 行目の前に空行が入って、markdown の表が 2 つに割れていた。
    Claude-Session: https://claude.ai/code/session_01QLEqQMUtSQU1cHKRXo8FuG
2026-08-28 USB キーボードから入力できるようにする (M7)
    DESIGN.md 7.3 / 7.4。実機の HHKB (VID=04FE PID=000D) で abc が通った。
    **cdk_hid（純 C・ホストテスト付き）がブートプロトコルの 8 バイトを解釈する。**
    レポートディスクリプタは読まない。キーボードなら全機種がブートプロトコルを
    持っていて、その keycode が cdk_keycode_t（HID usage id）とそのまま同じ値に
    なるので、特殊キーは変換表すら要らない。
    **キーの組み立てはメインループだけが触る。** USB 側はレポートをキューに積む
    だけにした。route_key は端末・画面・SKK・SSH を触る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
2026-08-28 キー配列の既定を JIS にし、検証の経緯を記録する
    実機で @ / : / " が正しく入ることを確認した。ログにも根拠が残っている:
    report 00 | 2F -> '@' JIS の @ 位置
    report 00 | 34 -> ':'
    report 02 | 1F -> '"' Shift+2
    report 02 | 2F -> '`' Shift+@
    基板の既定を CDK_BOARD_KEYMAP_JIS_DEFAULT にした（v1 = JIS）。決め打ちでは
    なく既定値で、set keymap us で変えられる。NVS を消しても手元の機体で
    そのまま打てるようにするため。
    **この回は「AI が入力を発生させられない」点がこれまでと違った。**
    shot --verify も A/B 撮影も故障注入も自分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
2026-08-28 文字を 2 倍にするモードを追加する (展示用)
    set fontscale 2 → 再起動で 40桁 x 13行。480x320 では等倍 (80x26) と
    2 倍 (40x13) のどちらも余りがちょうど 8px で、DESIGN.md 0 章が
    ステータス帯に予約している分と一致する。
    **24px のフォントを持ってくるのではなく、12px のグリフを画素ごと広げる。**
    別フォントにすると字形もカバー範囲も変わって「その字だけ出ない」問題を
    新しく作る。等倍のグリフを 2x2 にするだけなら字形もカバー範囲もそのままで、
    容量も増えない。間は補間しない（ビットマップフォントは字形が最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
2026-08-28 ステータス帯を追加する (M7)
    set statusbar on → 再起動で最下段に IP / SSH / かな / SD / KBD / 電池。
    既定は off（本文が 1 行減るため）。実機で 192.168.1.97 あ SD14G KBD を確認。
    **§0 の「余りの 8px を帯に使う」通りには作らなかった。** 8px に 12px の
    フォントは入らず、専用の小さいフォントを作ると 2 倍表示のときに帯だけ
    極小になって展示で読めない。1 行使えば拡大率にそのまま追随する。
    代償は本文が 1 行減ることなので、既定を off にして影響しないようにした。
    **DECSTBM で最下行を守る案は使えない。** vi も less も t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
2026-08-29 公開鍵認証と実機での鍵生成 (M7)
    ssh keygen / ssh key / ssh（公開鍵 → パスワードの順）。実機で ECDSA P-256 を
    作り、出てきた公開鍵を貼れば使える。SD へファイルを送り込む口が無いので、
    実機で作れないと鍵を持ち込む手段が無い。
    **符号化は ssh-keygen と突き合わせて確認した。**
    実機 : SHA256:EdkLEb+mPmDNjBfDGEJepj/qLS332bvGM0UfRA/ZLAc
    ssh-keygen -l : 256 SHA256:EdkLEb+...ZLAc cyberdeck (ECDSA)
    ホストテストの期待値も ssh-keygen が作った本物の鍵にした。自分で組んだ
    期待値と自分の実装を比べても、同じ間違いをしていれば通る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
2026-08-29 SSH の再接続 (M7 完了)
    通信が切れたら 1→2→4→8→15 秒と待って繋ぎ直す（最大 8 回）。
    set ssh.recon off で止められる。
    **繋ぎ直してよい切れ方だけ繋ぎ直す。** exit で繋ぎ直すと SSH から出られない
    機械になる。read/write のエラー経路と libssh2_channel_eof() の経路は
    もともと別なので、理由を持たせるだけで分かれた（新しい判定は書いていない）。
    ERROR 通信断 → 繋ぎ直す
    EOF リモートが exit → 繋ぎ直さない
    LOCAL ssh close → 繋ぎ直さない
    待っている間もシェルは使える（画面を占有しない）。**どの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
    [app.h, cdk_commands.c, main.c]
2026-08-29 消した設定が secrets.h から復活するのを直す (#42)
    `set ssh.pass ""` で消したパスワードが、次の load_config で secrets.h から
    書き戻されて復活していた。**空にする＝未設定に戻す**なので、消した意思と
    初回の状態を区別できていない。結果、認証情報を消す手段が無かった
    （パスワードを消して公開鍵だけにする、という一番したいことができない）。
    種を撒くのは本当に初回だけにした。判定は「設定キーが 1 つでもあるか」で、
    一度でも使われた機械ならいまの中身がその人の意思。印は NVS の "seeded"
    （設定ではなく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
2026-08-29 接続済みの wifi connect が「失敗」と出るのを直す (#43)
    接続済みで `wifi connect` を叩くと 20 秒待って赤字で
    `失敗 ESP_ERR_TIMEOUT` と出ていた。接続自体は生きたまま。
    esp_wifi_connect() は接続中に呼んでも新しい GOT_IP イベントを上げないので、
    イベント待ちが必ずタイムアウトする。
    同じ SSID なら何もせず ESP_OK を返す（cdk_wifi_ssid_is で判定）。
    SSID が違うときは切って繋ぎ直す。設定を変えて叩いたのに前の AP に繋がった
    ままのほうが分かりにくい。
    シェル側も「接続中...」を出さずに「既に接続しています (IP)」と出す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
2026-08-29 docs/MANUAL.md を書く（機械を触る人向け）
    起動・キーボード・日本語入力・シェル・エディタ・SSH・設定・展示・困ったとき。
    **書きながら実機で確かめた。** 記憶で書くと嘘が混ざるので、キー割り当ては
    ソースから拾い、動きは実機で通した:
    - 変換の流れ (Ctrl-J → Nihon → Space → ▼日本 → Space → ▼二本 → x → Enter)
    - シェルの Ctrl-A/E/B/F/U/K/W と Tab 補完
    - `edit` は引数必須で、/ で始めない限り SD の直下
    **その過程で、書こうとした手順が間違っていることが分かった。**
    「かな入力から抜けられないときは `l`」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
2026-08-29 SKK の l で抜けられない件を直し、説明書にビルド手順を足す (#44)
    **モード切り替えキーは打ちかけを吐き出してから必ず効くようにした。**
    以前は「打ちかけが無いときだけ」で、`nihon` の直後は末尾の n が残るので
    `l` が文字扱いになり、その `l` がまた打ちかけになって次の `l` が
    `ll` = っ を出す。押すほど抜けられなかった。
    ローマ字表から `l*` と `q*` を外した。小書きは `x*` が持っていて重複して
    いたため。`q` が持っていた くぁ〜くぉ は `kw*` を足して拾えるようにしたので、
    打てなくなる字は無い。
    打ちか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
2026-08-30 M8a/M8b: wasm3 と独自 ABI の純 C コア（ホストで .wasm が回る）
    実行時にユーザーアプリを読み込めるようにする土台。ランタイムは wasm3
    (MIT / 純 C99)、API は WASI でも POSIX 互換でもない独自の小さな ABI。
    層の分け方は DESIGN.md §1 をそのまま延長した:
    components/cdk_wasm/ 純 C。ABI・fd 表・パスのサンドボックス・リング
    components_port/wasm3/ 上流のベンダリング（libssh2 と同じ作法）
    components_port/port_wasm/ wasm3 の出し入れと native シム
    wasm3 が純 C99 なので、**port_wasm_vm.c と port_wasm_natives.c を
    ホストビルドにも入れた。**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
2026-08-30 M8c/M8d: 実機でユーザーアプリが動き、PC から SD へ転送できる
    `wasm run apps/hello.wasm foo` が実機で通った。コンソール出力・端末寸法・
    引数・終了コードまで確認済み（m8_hello.png）。
    **アプリは専用の FreeRTOS タスクで走らせる。** この機械はコマンドを
    メインループの中で同期実行するので、そこで回すと画面もキーも制御チャネルも
    止まり、Ctrl-C すら届かない。実際 spin.wasm を走らせている最中に
    スクリーンショットを撮ると、カウンタが進みながら画面が更新されている
    （m8_spin.png）。止めると 1 秒以内にプロンプ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
2026-08-30 M8e/M8f: I2C 読み書き・UART・ソケットと、基板ごとの予約ピン
    ユーザーアプリから周辺とネットワークを触れるようにした。どれもポート層の
    **新規実装**で、既存のラッパではない（I2C は scan しか無く、UART と
    生ソケットの口はそもそも無かった）。
    実機で `httpget.wasm example.com /` が 828 バイト取ってきて画面に出た
    （m8_http.png）。素の TCP で名前解決から HTTP GET まで、ゲスト側の
    コードだけで通っている。
    ## 中断できることを設計に入れた
    止められるのは native の入口だけなので、**いちばん詰まりやすい API が
    いち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
2026-08-30 M8g: 文書。DESIGN.md §15 / 取扱説明書 10 章 / DEV_STATS
    実装の正は DESIGN.md。§15 に M8 をまるごと書いた（独自 ABI にした理由、
    wasm3 を選んだ理由、層の分け方、実行モデル、中断、実測メモリ、ABI 一覧、
    サンドボックス、ゲスト SDK、転送、実機で見つかったこと、検証、やらないこと）。
    §10 のコマンド表と §12 の限界表、§0 の開発順序にも反映した。
    取扱説明書に 10 章「自分でアプリを書く」を足した。
    **書いた手順を実機でそのままなぞったら、載せたコード例が通らなかった。**
    `wasmcc.py` が `-Werror` を既定で付け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
2026-08-30 i2c_open の速度指定が効いていなかった（レビュー指摘）
    `cdk_i2c_open` は freq_hz を検査してログにも出しておきながら、実際には
    使っていなかった。ESP-IDF の新しい I2C ドライバはクロックをバスではなく
    **デバイスごと**に持つので、`dev_for()` が既定の 100kHz で足していた。
    `i2c_open(sda, scl, 400000)` が 100kHz で動き、**ログだけ 400kHz と言う**
    という一番たちの悪い形になっていた。
    open で言われた速度を覚えて、デバイスを足すときに使う。
    旧 `cdk_i2c_scan` は `(void)freq_hz;` と書いて「使っていない」ことを
    明示していた。そ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
2026-08-30 (a) Rust SDK の骨格。エディション 2024 で通り、枠にも収まる
    独自 wasm ABI の Rust 向けクレート `cdk-app` と、ビルドの道具 2 つ。
    DESIGN.md §15.10 に「同じ ABI に Rust から当てるのはファーム側の変更なしで
    できる」と書いたまま誰も試していなかった。まずそこを潰した。
    ## 枠に収まるかの見極め（この段の目的）
    hello を組んで 2 つとも測った:
    | | 実測 | 上限 |
    |---|---|---|
    | ファイル | **7,484 バイト** | 262,144 |
    | 線形メモリ | 初期 1 / **最大 16 ページ** | 16 |
    `format!` と `Display` の機構を積んで 7.5KB なので余裕がある。
    `--max-memo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
2026-08-30 (b) ABI の三重管理を機械で守り、1MB を本当に効かせる
    ## ゲストが持ち込むデータでファームが落ちるのを直した
    新しい fixture (`f_bigmem` = 線形メモリを 2MB 宣言するモジュール) を
    足したら **segfault した。**
    原因は M8 で書いた `port_wasm_vm.c`。上流の `m3_LoadModule` は
    **失敗しても** モジュールをランタイムの一覧に繋ぐ（途中まで進んだ
    初期化が他のモジュールの表に関数を書いているかもしれず、それを
    宙ぶらりんにしないため。上流のコメントに明記されている）。
    そこで自分から `m3_FreeModule` を呼んでいたので、あ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
    [check_abi_names.py, fs.rs, i2c.rs, lib.rs, net.rs, port_wasm_vm.c]
2026-08-30 (c)(d)(e) サンプル 10 本が実機で動く。転送のフレーム落ちを直した
    ## cdk.py push が複数フレームで壊れていた
    Rust のアプリ（5〜19KB）を送ったら **10 本中 6 本が失敗した。**
    M8 の C アプリは最大 2,354 バイトで**どれも 1 フレーム (4KB) に収まって
    いた**ので、この経路が一度も試されていなかった。
    原因は受け側。`cdk_link_poll` が 1 周で 256 バイトしか汲まない一方、
    921600 baud では約 92 バイト/ms 届く。メインループ 1 周（5ms 強）で
    500 バイト以上来るので追いつかず、2KB の受信リングが溢れて
    フレームがまるごと消えて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
2026-08-30 (f)(g) 1MB の枠を実機で確かめ、文書を書く
    ## 枠を入れても既存の C アプリは全部動く
    `d_m3MaxLinearMemoryPages=16` を入れたあと、**C のサンプル 8 本を
    1 本ずつ実機で回した**（m8rs_capA/B.png）。どれも `--max-memory=1048576`
    = 16 ページで出ているので通る、という予測どおり。**予測を確かめるための
    段なので、まとめて流さず全部見た。**
    `port_link` の直しは `#if CDK_BOARD_LINK_IS_USB_SERIAL_JTAG` の両側に
    掛かるので、CoreS3 でもビルドが通ることを確認してから v1 に戻して焼いた。
    ## Rust だけが違う挙動を測って書いた
    アロケータはバ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
2026-08-30 証拠と数え方を揃える（レビュー指摘）
    - `du` の丸めを直したあと `m8rs_du.png` を撮り直していなかった。
    DESIGN.md §15.14 がそれを証拠として挙げているので、直した版で撮り直した
    （画面の値は K 範囲だけだったので表示は元から正しかったが、
    **修正前のビルドを指す証拠表**にはしない）。
    - **1MB という数が 4 か所にある**ことを §15.14 に書いた。wasm3 の
    CMakeLists 2 つ・`.cargo/config.toml`・`wasminfo.py`。ピン番号や
    ABI の名前と同じ形だが、いまは機械で突き合わせていない。
    `abi_names_match` を広げるならここが次、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
2026-08-30 ターミナルのスクロールバック（200 行）
    コマンドの出力が 1 画面に収まらないと、流れたぶんは二度と見られなかった。
    `Shift+PgUp` / `Shift+PgDn` で遡れるようにする。
    ## 積むのは「画面から永久に消える」経路だけ
    `cdk__scroll_up` の中では積まない。あの関数は 3 経路から呼ばれ、
    そのうち `cdk__delete_lines` (DL, `CSI M`) は **`t->top` を一時的に
    `t->cy` にすり替えて**呼ぶ。中で積むと `vi` や `less` の行削除が
    そのまま履歴に流れ込む。呼ぶのは `cdk__index`（LF）と `CSI S` の 2 か所だけ。
    積む条件は 3 つとも要る:
    !alt_active && t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
2026-08-30 描画側のテストも書けた（前のコミットの積み残し）
    前のコミットで「test_screen の中でだけ字が正しく描かれない」と書いて
    諦めたが、**そうではなかった。**
    `count_color(..., S.default_fg)` は **どの字でも 60 / 背景 12 を返す**。
    'A' でも '2' でも '4' でも同じ。この検査は字の形を見分けられない。
    既存のケースが通っているのは「0 より大きい」までしか見ていないからで、
    字の違いを当てにした自分のテストだけが空振りしていた。
    `cdk_term_set_history` を付けた場合と付けない場合で描画結果が
    まったく同じ（fg=60 bg=12）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
2026-08-30 文書。DESIGN.md §6.5 / 取扱説明書 4 章・9 章 / DEV_STATS
    - **DESIGN.md に §6.5 を新設。** 積む経路を 2 か所に絞った理由（DL が
    `t->top` をすり替えること）、条件が 3 つとも要る理由（上端そのままで
    下だけ狭めた領域）、`view_off` を 0 に戻す 4 か所、割り込み位置を
    動かせない理由、実測のメモリ。§6.2 の表と §12 の #2 にも反映した。
    - **`test_screen` の落とし穴を書き残した。** `count_color` はどの字でも
    前景 60 / 背景 12 を返すので、**字の違いを当てにしたテストは通っても
    何も見ていない。** 次に描画のテストを書く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
2026-09-01 wasm アプリから TLS（HTTPS）を使えるようにする
    TLS は自前で持たず ESP-IDF (esp-tls + 証明書バンドル) に任せる。
    wasm 側に積む道は 1MB のリニアメモリにも 256KB のモジュール枠にも入らない。
    **インポートは 1 本も増やしていない。** sock_open の型に足しただけで、
    connect / send / recv / close は素の TCP と同じ約束のまま使える。
    int sd = sock_open(CDK_SOCK_TLS); /* 2 = 検証する / 3 = 検証しない */
    sock_connect(sd, host, hlen, 443);
    これで済んだのは M8 の設計の貯金。ゲストに渡すハンドルがスロット番号で
    fd ではなかったので、TLS の実体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
2026-09-03 起動時の WiFi 接続を待たなくする（帯に「WiFi接続中」→ IP）
    `cdk_wifi_connect()`（IP が取れるまで待つ）を `cdk_wifi_connect_start()`
    ＋ `cdk_wifi_poll()` に置き換えた。**待つ版は残していない。**
    それまでは起動時に最大 20 秒ブロックしていた。AP が居ない場所（外、電車、
    別の家）で電源を入れると、その 20 秒はバナーが出たままキーも効かず、電源を
    切る以外に手が無い。**この機械の主目的は SSH だが、副目的は「持ち出して
    文字を打つ」で、そちらは WiFi が要らない。** 繋がるまで打てないのは筋が
    通らない。
    実機 (v1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
2026-09-03 `wifi off` — 繋ぎ直しを諦めさせて電波も止める
    「確立後は諦めない」の裏で、**相手が二度と現れない場合に止める手が無い**
    という穴が空いていた。家で使っていて点けたまま外へ出ると、この機械は消えた
    AP を延々と探し続ける。持ち歩く機械なので、減るのは電池だけ（人間の指摘）。
    **電波を止めるところまでやるのが要点。** `cdk_wifi_off()` は状態を `IDLE`
    に落として `esp_wifi_stop()` まで行く。繋ぎ直しをやめるだけでは電池の話が
    解決しない。
    `IDLE` はイベント側のどちらの枝にも当たらないので、`disconnect` /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
2026-09-03 `ssh user@host` — その場かぎりの接続先（NVS は書き換えない）
    Linux と同じ書き方で、設定に無い相手へ繋げる。
    ssh alice@192.168.1.5
    **NVS には書かない**（人間の指示）。覚えさせたいなら `set ssh.host` /
    `set ssh.user`。
    ## 溜めたパスワードは、溜めた相手にしか送らない
    ここが今回いちばん考えたところ。
    **`ssh.pass` は `ssh.host` の `ssh.user` のものであって、「どこでも使う
    合言葉」ではない。** 引数で渡された相手へ黙って送ると、宛先を打ち間違えた
    だけで知らない機械に平文のパスワードを渡すことになる。**送ってし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
2026-09-03 繋ぐところを 2 つに割る（scp の下地）＋ 既存 `ssh` の穴 2 つ
    `scp` を足す前の下ごしらえ。**それ自体で `ssh` の不具合 2 つを直している。**
    `cdk_ssh_connect()` を 2 つに割った。
    | | やること |
    |---|---|
    | `cdk_ssh_session_open()` | TCP・ハンドシェイク・known_hosts・認証まで |
    | `cdk_ssh_shell_open()` | PTY 付きチャネルを開いてノンブロッキングへ |
    **認証の塊を写さないため。** あそこには「空パスワードで password 認証を
    叩かない」「`.pub` を必ず渡す」「ホスト鍵が食い違ったら断る」が入っていて、
    どれも実機で踏んだ末のもの。2 つ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
2026-09-03 `scp` — この機械だけでファイルをやり取りする
    ```
    scp <手元> user@host:<パス> 送る
    scp user@host:<パス> <手元> 取る
    ```
    それまで手元と向こうでファイルを渡す手段は `cdk.py push`（**PC から** SD へ）
    と SSH 越しに `cat` して目で写すことだけで、**この機械だけで完結した経路が
    無かった。** `-r` も複数指定もやらない（人間の指定）。上限 512KB。
    `scp.c` は上流の `CSOURCES` をそのまま並べていたので**最初からビルドに
    入っていた**。ベンダリングの方針の副産物で、誰も狙っていない。
    ## 転送はメインループが刻む。専用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
2026-09-03 `i2c_probe` — 走査で相手を壊さないようにする（実機で I2C を検証）
    M5Stack Unit ENV III (SHT30 + QMP6988) を Grove の G17/G18 に繋いで、
    アプリ用の I2C を初めて実機で確かめた。DESIGN.md §15.15 に「実機のデバイスで
    未検証」と書いておいたとおり、**繋いだら動くはず、は外れた。**
    動かなかったのはピンでも配線でもなく、こちらの実装 4 件。
    (1) 走査を 1 バイト読みで書いていて、相手を壊していた
    待機中の SHT30 に読みを 1 回投げると、来ない続きを待って SCL を
    握り続ける。ユニットの VDD を抜くまで戻らず、同じバ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
2026-09-04 `ssh user@host` — 鍵で断られたらその場でパスワードを聞く
    `ssh alice@box` は鍵だけで行くので (§8.3)、鍵が相手の authorized_keys に
    無ければそこで終わりだった。知らない機械に入るには `set ssh.host` /
    `ssh.user` / `ssh.pass` を 3 つ書き換えて NVS の相手そのものを差し替える
    しかなく、**戻すのを忘れると次の `ssh` が別の機械へ行く。**
    鍵で断られたときだけパスワードを聞くようにした。
    (1) 聞くのは鍵が駄目だったあと。先には聞かない
    先に聞くと、鍵で入れる相手にまで平文の合言葉を打たせることになる。
    この機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
2026-09-12 `uart` — シリアルでつながった機器と話す（実機の折り返しで検証）
    DESIGN.md §10 に `uart open/send/monitor` として設計だけ置いてあったものを、
    端末の部分だけ実装した。M3 の「見送ったもの」が**実装より先に決めろ**と
    書いていた 2 点を決めたのが、実質この変更の主題。
    - 抜けるキーは `Ctrl-] q` の 2 打鍵
    - 素の `Ctrl-]` は 0x1D としてそのまま相手へ通る
    1 打鍵で抜ける方式にすると、バイナリを流す相手に 0x1D を送る手段が
    無くなり、「抜けるキーを送るためのエスケープ」をもう 1 つ決める必要が
    あった。前置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
2026-09-16 `wget` — Web からファイルを 1 本取ってくる（HTTP / HTTPS）
    手元へファイルを入れる経路は `cdk.py push`（PC から）と `scp`（SSH の
    相手から）だけで、Web 上のものを取る道が無かった。http / https だけ、
    引数は URL と保存名だけ（人間の指定）。
    形は scp と同じにした。専用タスクは作らない。
    - 接続（名前解決・TCP・TLS・リダイレクト・ヘッダ）は待つ（期限 8 秒）
    - 本体はメインループが cdk_wget_poll() で刻む。ヘッダを取ったあとで
    esp_http_client の期限を 10ms に落とす（set_timeout_ms は次の read
    から効く）。初期化時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
2026-09-16 `scp` — 512KB の上限を外し、4GB 超の受信を見分けて断る
    上限 (CDK_SCP_MAX_BYTES = 512KB) を撤廃した（人間の指定。wget と同じ扱い）。
    SD が埋まれば書き込みの失敗で止まり、書きかけの .tmp を消す。
    上限を外すと、前からあった穴が表に出る: **この機械の off_t は 32 ビット。**
    libssh2 は相手の申告を 64 ビットで読むが、st_size に詰めるときに上が落ちる。
    - 2GB〜4GB は負で来る → (uint32_t) で読み直せば正しい（FAT の上限も 4GB）
    - 4GB 超は下 32 ビットだけ残り、4GB+1KB が 1024 バイトとして来る。
    そのままだと先頭 1KB だけ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
2026-09-16 電池電圧をステータス帯と `info` に出す（実機の NiMH x2 で 2.67V）
    GPIO5 (ADC1_CH4) に電池電圧の 1/2 が来るよう分圧が決まった（人間の配線）。
    分圧比が未定のあいだは「間違った電圧を出すより出さない」としていたもの。
    - cdk_board.h に CDK_BOARD_BATT_DIV 2
    - cdk_batt_read_mv(): 校正済みの値を 8 回平均して 2 倍する。
    校正 (curve fitting) が使えなければ出さない（生値からの換算は信用しない）。
    測る口の無い CoreS3 は ESP_ERR_NOT_SUPPORTED で、info にも出ない
    - 帯: 10 秒に 1 回だけ読む。毎周読むと無駄なうえ、数 mV の揺れ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
2026-10-30 `scp` も鍵で断られたらパスワードを聞く（実機 v1 で検証）
    `ssh` と同じく、鍵で断られて送るパスワードも無いとき (PASS_NONE) だけ
    伏せ字で聞いて、もう一度繋ぐ。
    「scp では聞けない（転送はメインループが刻むのでシェルに戻れない）」
    としていたのは理由が間違っていた。接続と認証は cdk_scp_start() の中で
    同期で済み、SESSION_SCP に入るのは認証が通ったあと。断られた時点では
    まだシェルにいる。
    - 聞く・覚えるを ask_password(cb) / remember_asked() に切り出して
    ssh と共有する（規則を 2 か所に持たない）
    - app_scp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
2026-10-30 シェル: 画面幅を超えたコマンド行を描き直すたびに段が増えるのを直す
    40 桁を超えたコマンドを打つと、1 字打つたびに行が 1 段ずつ増えていった
    （`scp ... user@host:/path` で実機で踏んだ）。描き直しが `\r\033[K` で
    今の段の頭にしか戻らず、折り返した上の段を残したまま下に描いていた。
    cdk_shell が端末の桁数を知らず、戻る段数が分からなかったため。
    - cdk_shell_set_cols() で桁数を教える（main.c は s_term.cols）。
    教えなければ今まで通り 1 段の前提で描く
    - 前に描いた行の形（カーソルの段・最後の段）を覚え、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
2026-10-30 シェル: 再接続の知らせがプロンプトを食うのを直す（hide_line / show_line）
    SSH の再接続まわりの知らせ（`再接続 n 回目...`・app_ssh_open(false) の
    出すもの・`繋ぎ直せませんでした`・`再接続をやめました`）は main.c が
    term_printf で直に書いていた。どれも enter_shell() が `$ ` を描いた
    直後に来るので、`$ ssh : 再接続 1 回目...` と続き、終わっても
    プロンプトが出なかった。
    - cdk_shell_hide_line() / cdk_shell_show_line() を足した。シェルを
    通さずに書くときに前後を囲むと、打ちかけの行をプロンプトごとどけて、
    書き終えた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
2026-10-30 画面: 赤を明るくする（#CD0000 → #FF5050、明るい赤は #FF7070）
    エラーの字（SGR 31）が ILI9488 で暗くて読みにくかった。純色の赤は赤の
    副画素しか光らないので白の 5 分の 1 ほどの明るさしか出ず、ガンマ 2.2 でも
    0 の成分は持ち上がらないので直らない。
    - cdk_screen の k_ansi の 1 と 9 だけ白を混ぜた。エラー表示の書き方
    （67 か所）は触らない。SSH の向こうの赤も一緒に読みやすくなる
    - 値は実機のパネルに 38;2;255;n;n の見本を 9 段階並べ、人間が目で
    選んだ（カメラでは明るさを比べられない）
    - 9（明るい赤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
2026-10-30 v1: パネルの上端オフセットを 1 → 0 に戻す
    以前のモジュールは一番上の 1 画素行が見えず 1 下げていたが、いまの
    パネルでは画面全体が 1 画素下にずれて見えた（人間の目視）。
    ずらしの処理（port_display.c の flush）はオフセットの値によらないので
    そのまま。0 になったので、ステータス帯の最下段 1 行も送られるようになる。
    HARDWARE_DESIGN.md の「上端 1 行が見えない」は経緯を残して書き直した。
    ホスト 27 件緑。実機 v1 で selftest（基準画像と完全一致）。上下端の
    見え方は shot では分からないので、見本を出し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
2026-10-30 scp: 相手の scp をこちらで起こす（Windows に送れない・取れないのを直す）
    Windows（OpenSSH_for_Windows 9.5）の相手に scp すると、送りも取りも
    `'C:/…': No such file or directory` で失敗していた。libssh2 の
    scp_send64 / scp_recv2 はパスを '...' で括って `scp -t` / `scp -f` を
    起こすが、Windows の sshd はコマンドを cmd.exe に渡すので ' がそのまま
    scp.exe に届く。libssh2 は直さない方針なので、最初のやりとりを自前にした。
    - port_scp はチャネルを開いて `scp -t` / `scp -f` を exec し、
    C 行の送受・応答の 1 バイトまでを自分で進める。データと締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
2026-10-30 wasm アプリ: batterytest と penlight を足す
    - batterytest.c: 1 分おきに ADC4 の電圧を 2 倍して VBAT として、
    192.168.1.205:8080 へ `GET /?vbat=<mV>` を送る
    - penlight.c: 制御盤（UART TX=G48 RX=G47）のスライダーとボタンを読み、
    ペンライトへ OSC/UDP 6668 で色（/led/set）と振動（/vibration/set）を送る
    [batterytest.c, penlight.c]
2026-10-30 MIT ライセンスと基板データ（hardware/cdk_motherboard）を入れる
    公開に向けて。
    - LICENSE: MIT / Copyright (c) 2026 Mitsumine Suzu (verylowfreq)。
    取り込んだ libssh2 (BSD-3) と wasm3 (MIT) は各ディレクトリの
    COPYING / LICENSE のまま。東雲フォントは Public Domain、SKK 辞書は入れていない
    - hardware/cdk_motherboard: KiCad のプロジェクト（pro / sch / pcb）、
    プロジェクト内ライブラリ ProjectLibrary（シンボルとフットプリント 12 個。
    sym-lib-table / fp-lib-table は ${KIPRJMOD} 相対）、JLCPCB 用のガーバーと BOM / CPL
    - .gitignore: KiCad の自動バックアップ・.kic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
    [BOM-cdk_motherboard_1.csv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]
2026-10-30 公開前の掃除: 資格情報の古い記述を直し、フックのパスを相対にする
    - ABOUT.md「セキュリティ上の注意」と DESIGN.md §8.1 / §12 #12 が
    「ABOUT.md に PSK / SSH パスワードが平文で入っている」のままだった。
    2026-08-27 に .env へ移し、2026-09-01 に filter-repo で履歴からも消して
    いるので、その経緯に書き直した。2026-10-30 に .env の値で全コミットと
    作業ツリーを照合し、どこにも無いことを確かめた
    - .claude/settings.json の統計フックが C:/DATA-0/... の絶対パスだった。
    $CLAUDE_PROJECT_DIR に変えた（変更後に ctest を回し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
2026-10-30 名前を KUSABI に。`cdk.py build` は --board を省くと前回の基板を引き継ぐ
    - 起動画面の見出しを `KUSABI - ESP32-S3 CyberDeck` にした（banner.vt /
    banner40.vt の両方。枠の内側 34 桁は変えていない）。起動ログと READY の
    版名 CDK_VERSION は "cyberdeck M6" → "KUSABI v1"
    - `cdk.py build` は --board を省くと cores3 になり、.cdk_board まで
    cores3 に書き換えていた。ファームは前の sdkconfig のまま v1 で焼けるのに、
    flash / boot の選ぶポートだけ CoreS3 のものにずれる。省いたら
    current_board()（前回の基板。初回は cores3）を使う
    - selftest のヘル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
2026-10-30 文書を実装に合わせる。README と基板 v1 の既知の誤りを足す
    公開に向けて、文書を実装と突き合わせて直した（約 60 件。どれもコードで確認）。
    - README.md（新規）: 概要（英語併記）・できること・ハードウェア・構成・
    ビルド（secrets.h の作り方を含む）・開発について・ライセンス。images/ に写真と回路図
    - 基板 v1 の既知の誤り（HARDWARE_DESIGN.md「基板 v1」、hardware/cdk_motherboard/README.md、
    cdk_board.h のコメント）:
    - microSD の SPI 4 本（GPIO39〜42）は回路図・基板データの信号名が実物と違う。
    液晶モジ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
2026-10-31 SSH 中の Shift+PgUp / PgDn を相手のアプリへ渡す（codex をスクロールできるように）
    SSH 先の codex は Shift+PgUp / PgDn でスクロールできなかった。全画面のアプリは
    スクロールをマウスのホイールで受けることが多く、この機械にはマウスが無い。
    SSH 中は、相手が端末に頼んだことを見て行き先を変える:
    - マウス報告を頼まれている（?1000 / 1002 / 1003）→ ホイールの報告を
    行数 / 3 段。形式は ?1006 (SGR) / ?1015 (urxvt) / 既定に合わせる
    - 頼まれていないが代替画面 → Shift なしの PgUp / PgDn
    （↑ / ↓ は claude の入力欄で履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
